princekumar983777/TYNOR/README.md

# TYNOR

these area the project that i have worked on,
these product falls under the Category of walker support
