princekumar983777/TYNOR/Walker Ergo/Z_INFO.txt

TYNOR Orthotics Pvt. Ltd

Leg Braces
Walking Ergo 

WE-P2-LB
