princekumar983777/TYNOR/Commode Chair Ergo/src/WhatsApp Image 2026-06-30 at 12.06.18 PM.jpeg

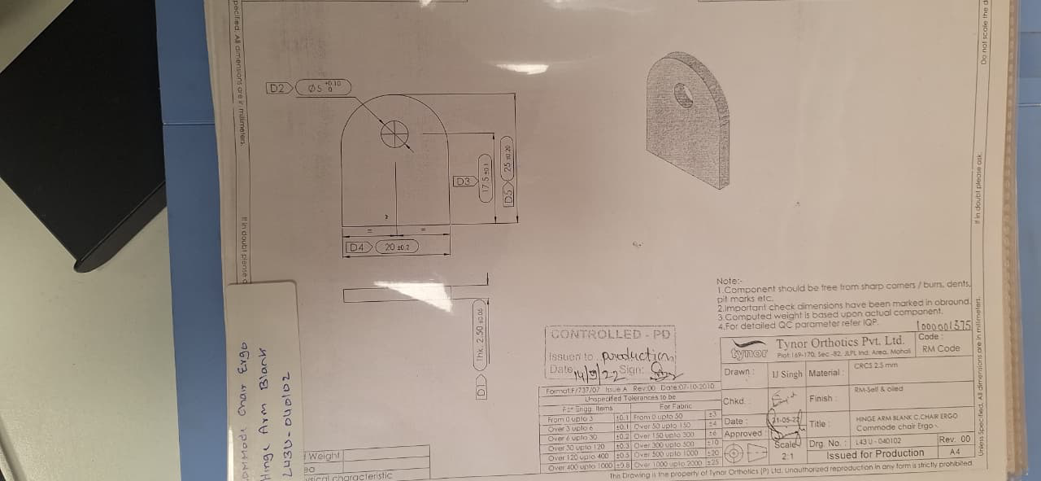
Commode Chair Ergo/src/WhatsApp Image 2026-06-30 at 12.06.18 PM.jpeg
