princekumar983777/TYNOR/Walker Aluminium/src/WhatsApp Image 2026-06-11 at 11.34.19 AM.jpeg

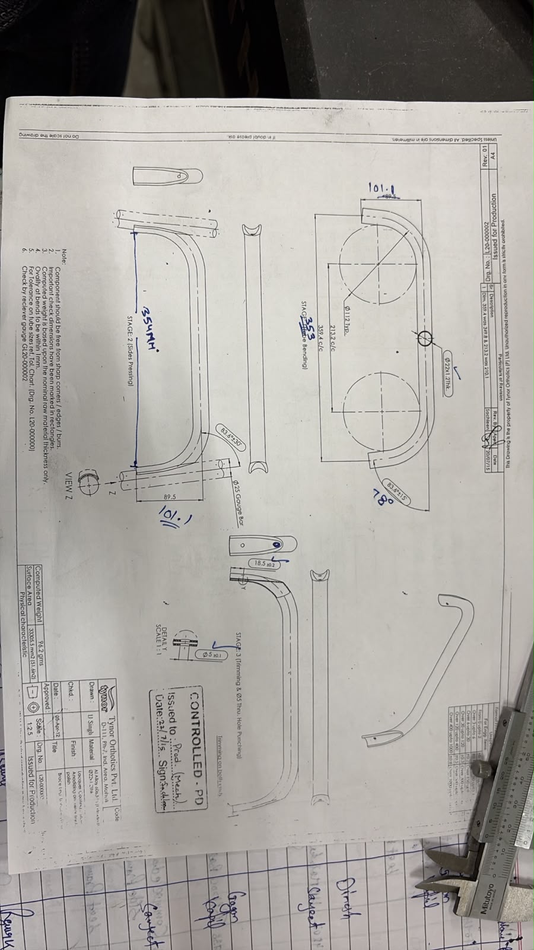
Walker Aluminium/src/WhatsApp Image 2026-06-11 at 11.34.19 AM.jpeg
