princekumar983777/TYNOR/Walker Aluminium/src/WhatsApp Image 2026-06-11 at 12.56.39 PM.jpeg

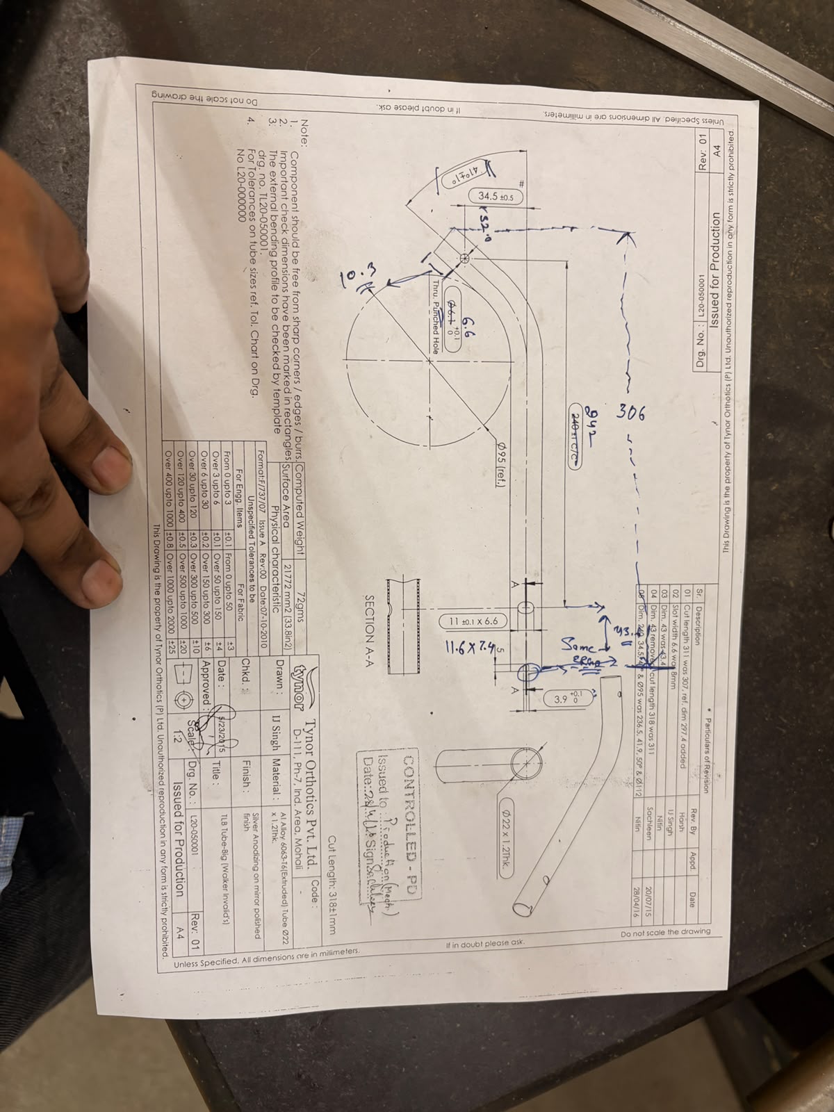
Walker Aluminium/src/WhatsApp Image 2026-06-11 at 12.56.39 PM.jpeg
