princekumar983777/TYNOR/Walker Aluminium/src/WhatsApp Image 2026-06-16 at 1.27.41 PM.jpeg

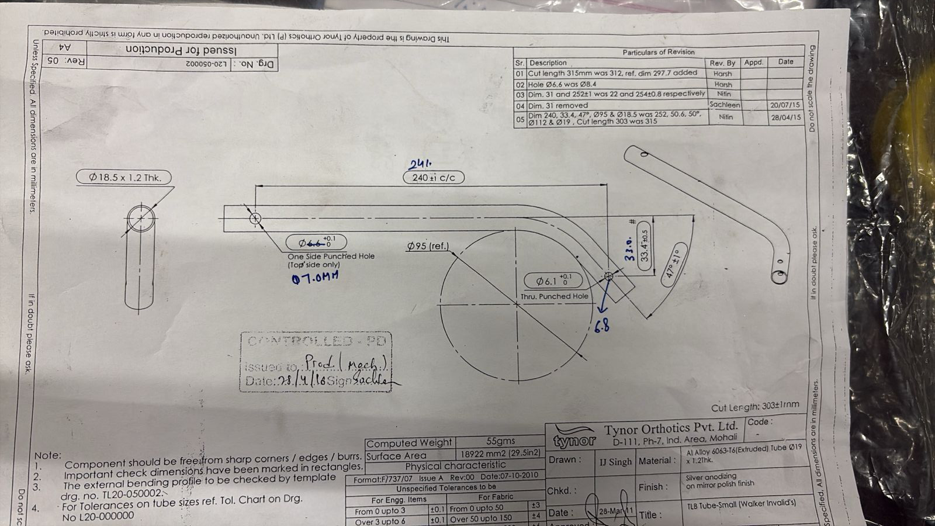
Walker Aluminium/src/WhatsApp Image 2026-06-16 at 1.27.41 PM.jpeg
