princekumar983777/TYNOR/Walker Aluminium/src/WhatsApp Image 2026-06-16 at 2.34.24 PM.jpeg

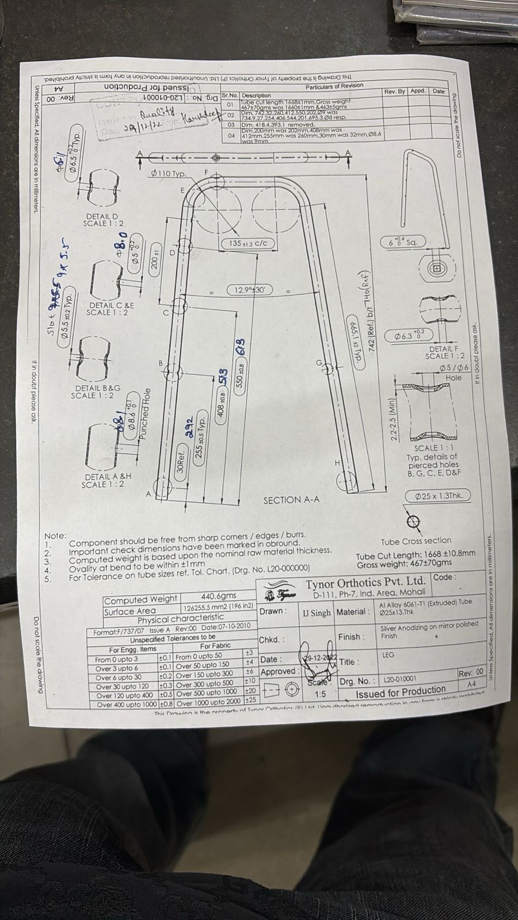
Walker Aluminium/src/WhatsApp Image 2026-06-16 at 2.34.24 PM.jpeg
