princekumar983777/TYNOR/Walker Aluminium/src/WhatsApp Image 2026-06-17 at 1.30.02 PM (2).jpeg

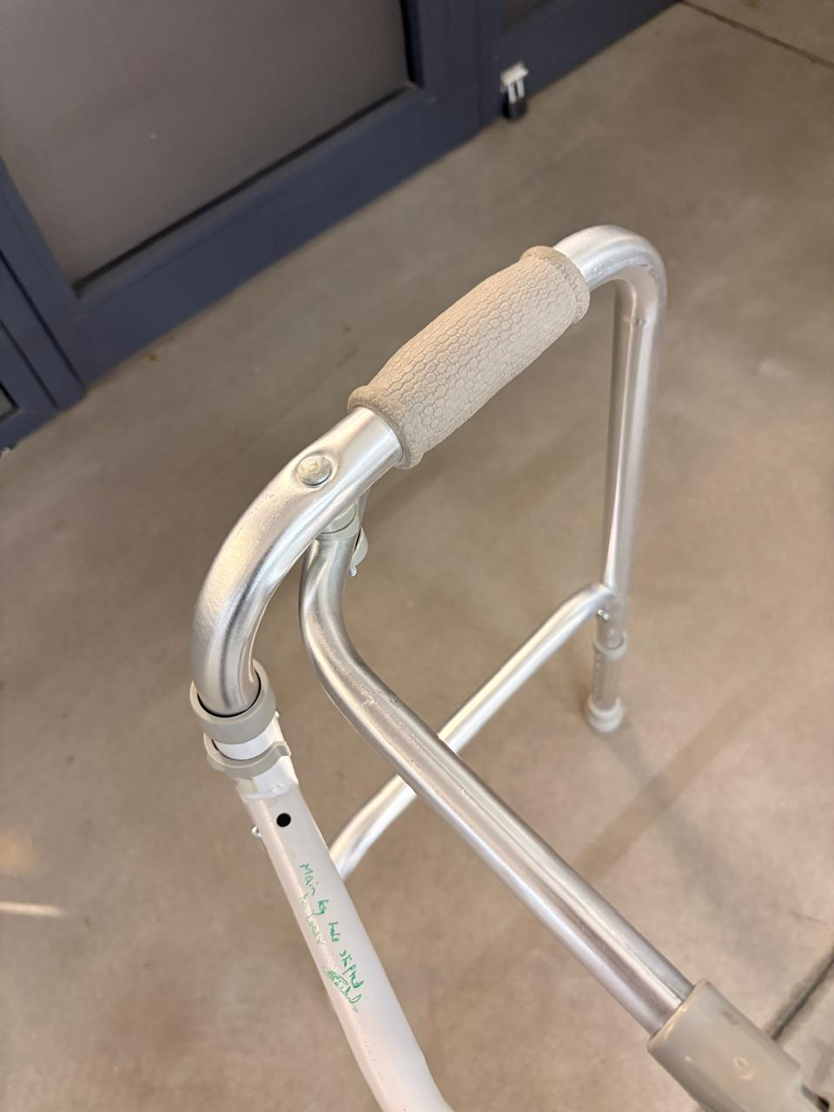
Walker Aluminium/src/WhatsApp Image 2026-06-17 at 1.30.02 PM (2).jpeg
