princekumar983777/TYNOR/Walker Aluminium/src/WhatsApp Image 2026-06-19 at 2.53.04 PM.jpeg

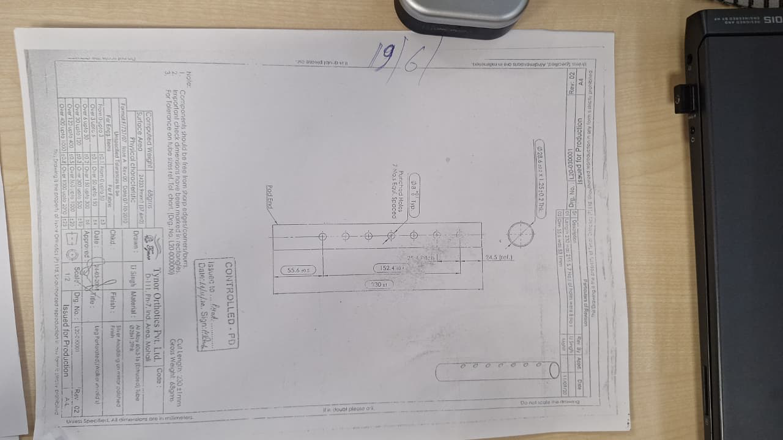
Walker Aluminium/src/WhatsApp Image 2026-06-19 at 2.53.04 PM.jpeg
