princekumar983777/TYNOR/Walker Aluminium/src/WhatsApp Image 2026-06-25 at 8.43.58 AM.jpeg

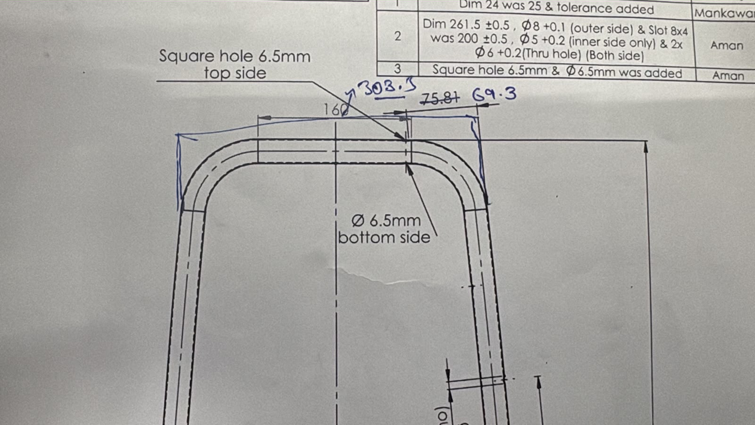
Walker Aluminium/src/WhatsApp Image 2026-06-25 at 8.43.58 AM.jpeg
