princekumar983777/TYNOR/Walker HD/src/WhatsApp Image 2026-06-15 at 3.05.31 PM.jpeg

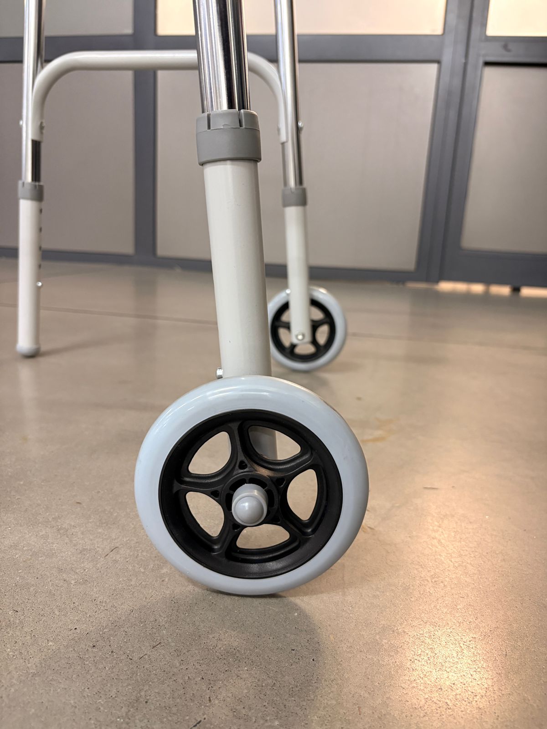
Walker HD/src/WhatsApp Image 2026-06-15 at 3.05.31 PM.jpeg
