princekumar983777/TYNOR/Walker HD/src/WhatsApp Image 2026-06-22 at 1.30.08 PM (3).jpeg

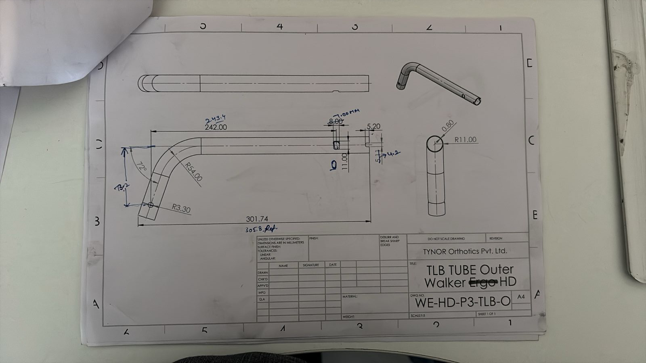
Walker HD/src/WhatsApp Image 2026-06-22 at 1.30.08 PM (3).jpeg
