princekumar983777/TYNOR/Walker Aluminium/Simple Walker/PART_1 MAIN LINE.SLDPRT

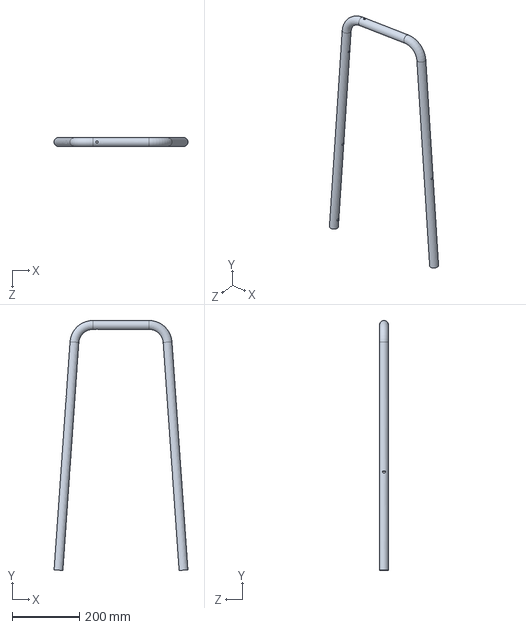
[picture p37: CAD file, 2026-06-26]
Walker Aluminium/Simple Walker/PART_1 MAIN LINE.SLDPRT
398.2 x 743.4 x 26.4 mm
