princekumar983777/TYNOR/Walker Aluminium/Walker Al. with Wheel with Straight Leg/Walker Al. with Wheel/PART_1 MAIN LINE.SLDPRT

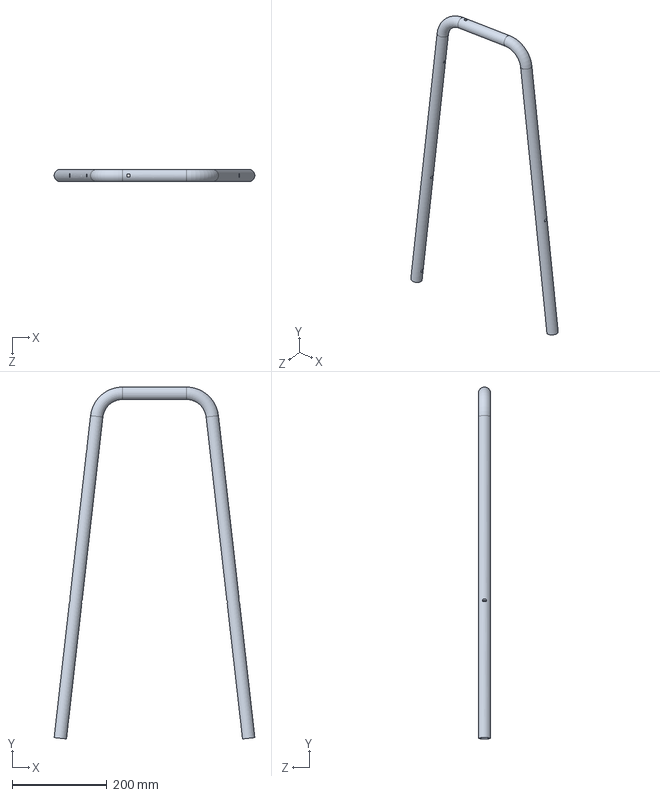
[picture p38: CAD file, 2026-06-25]
Walker Aluminium/Walker Al. with Wheel with Straight Leg/Walker Al. with Wheel/PART_1 MAIN LINE.SLDPRT
424.4 x 744.0 x 26.4 mm
