princekumar983777/TYNOR/Walker Ergo/PART_1 MAIN LINE.SLDPRT

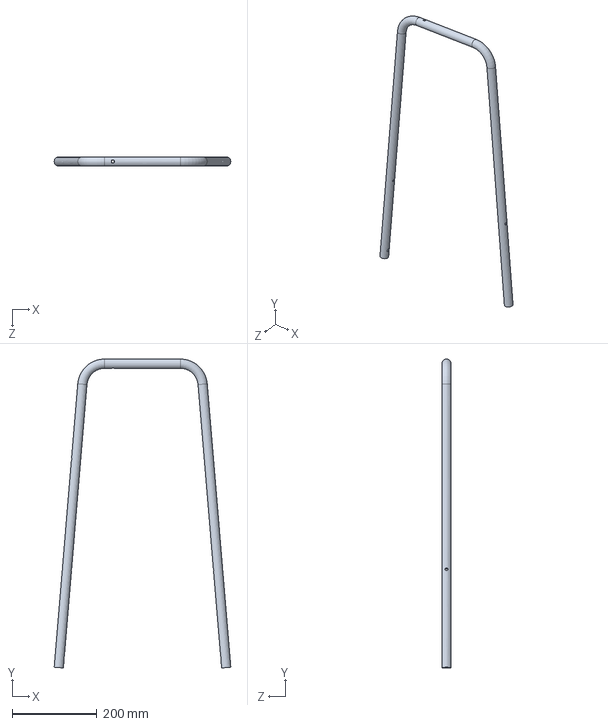
[picture p39: CAD file, 2026-06-25]
Walker Ergo/PART_1 MAIN LINE.SLDPRT
417.9 x 730.9 x 22.0 mm
