princekumar983777/TYNOR/Walker Aluminium/Simple Walker/SIDE STAND.SLDASM

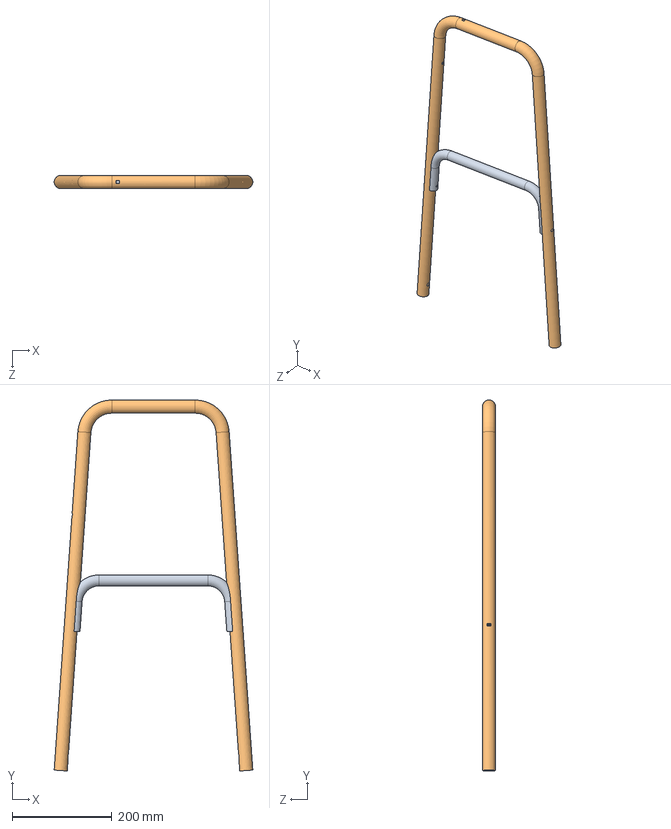
[picture p40: CAD file, 2026-06-26]
Walker Aluminium/Simple Walker/SIDE STAND.SLDASM
398.2 x 743.4 x 26.4 mm
PART_1 MAIN LINE
PART_2 Ergo walker joint Formed
