princekumar983777/TYNOR/Walker Aluminium/Simple Walker/Assembly 1.0.SLDASM

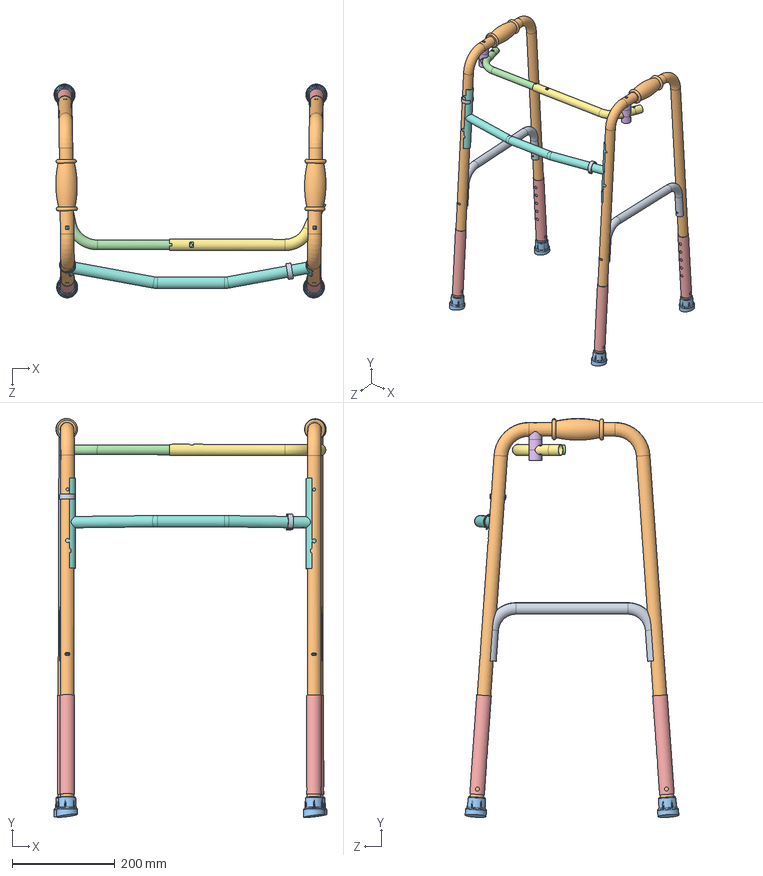
[picture p42: CAD file, 2026-06-26]
Walker Aluminium/Simple Walker/Assembly 1.0.SLDASM
530.8 x 775.9 x 415.9 mm
PART_1 MAIN LINE x 2
PART_2 Ergo walker joint Formed x 2
PART_4 WELDED Coated ERGO WALKER
PART_3 TLB Tube Outer walker Ergo
Pkug x 6
PART_5 Perforated Pipe D25.4 ERGO WALKER x 4
PART_3_1 TLB Tube Inner
P_Stand x 4
P_Handle Part x 2
LOCK_PIN x 2
