princekumar983777/TYNOR/Walker Aluminium/Walker Al. with Wheel/Assembly 1.0.SLDASM

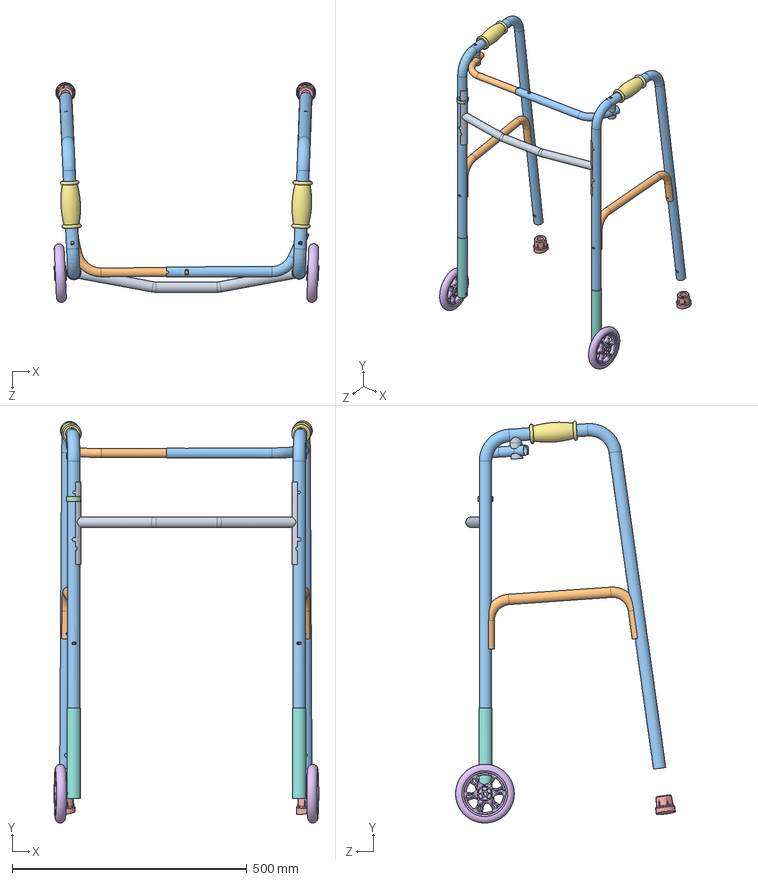
[picture p43: CAD file, 2026-06-26]
Walker Aluminium/Walker Al. with Wheel/Assembly 1.0.SLDASM
563.7 x 855.5 x 468.1 mm
PART_1 MAIN LINE x 2
PART_2 Ergo walker joint Formed x 2
PART_4 WELDED Coated ERGO WALKER
PART_5 Perforated Pipe D25.4 ERGO WALKER x 2
P_Handle Part x 2
wheel x 2
P_Stand x 2
LOCK_PIN
PART_3 TLB Tube Outer walker Ergo
PART_3_1 TLB Tube Inner
Plug_ x 6
