princekumar983777/TYNOR/Walker HD/Walker HD Fr. Wheel/Assembly 1.0.SLDASM

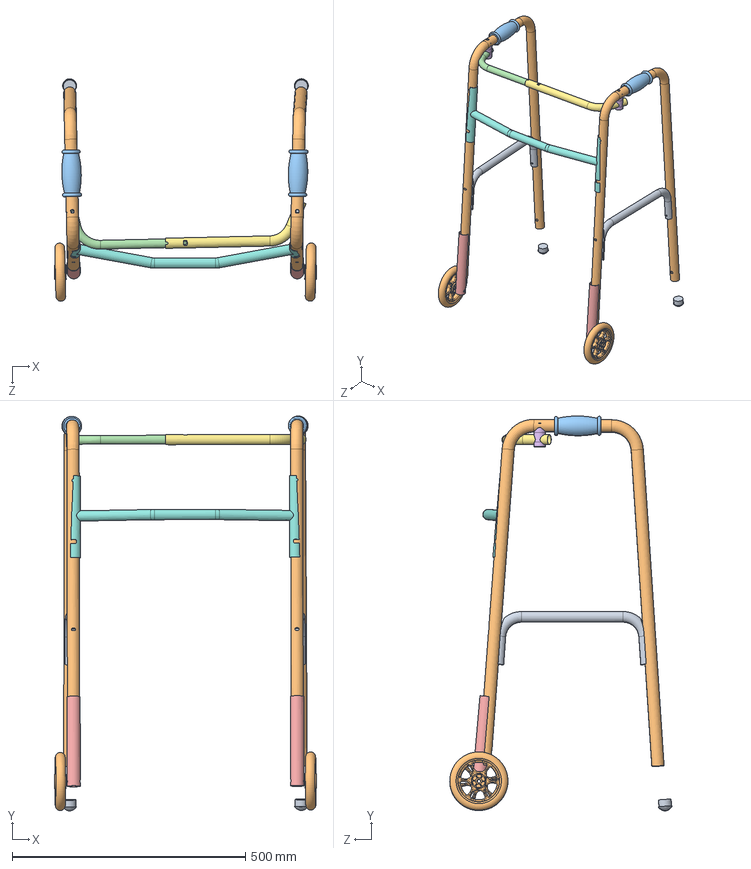
[picture p44: CAD file, 2026-06-25]
Walker HD/Walker HD Fr. Wheel/Assembly 1.0.SLDASM
563.1 x 847.6 x 477.5 mm
PART_1 MAIN LINE x 2
PART_2 Ergo walker joint Formed x 2
PART_4 WELDED Coated ERGO WALKER
PART_3 TLB Tube Outer walker Ergo
Pkug x 6
PART_5 Perforated Pipe D25.4 ERGO WALKER x 2
PART_3_1 TLB Tube Inner
P_Handle Part x 2
wheel x 2
plug_wheel x 2
