princekumar983777/TYNOR/Walker Aluminium/Walker Al. with Wheel with Straight Leg/STP/Main_Leg_Straight.STEP

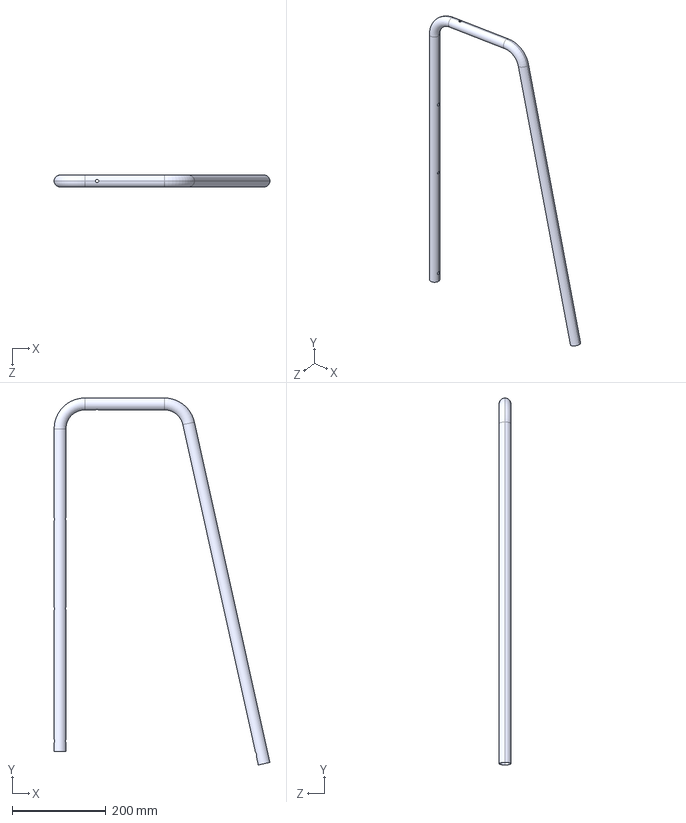
[picture p47: CAD file, 2026-06-26]
Walker Aluminium/Walker Al. with Wheel with Straight Leg/STP/Main_Leg_Straight.STEP
461.0 x 784.0 x 25.4 mm
