princekumar983777/TYNOR/Commode Chair Ergo/Commode Chair Ergo/Arm rest pipe hinge assembly Commode Chair Ergo.SLDPRT

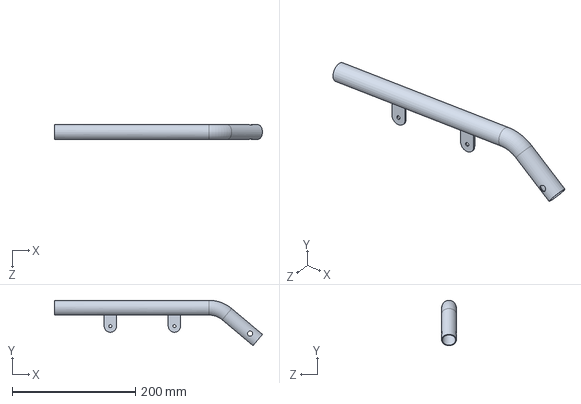
[picture p48: CAD file, 2026-06-30]
Commode Chair Ergo/Commode Chair Ergo/Arm rest pipe hinge assembly Commode Chair Ergo.SLDPRT
337.7 x 73.7 x 24.0 mm
