princekumar983777/TYNOR/Walker Ergo/Assembly 1.0.SLDASM

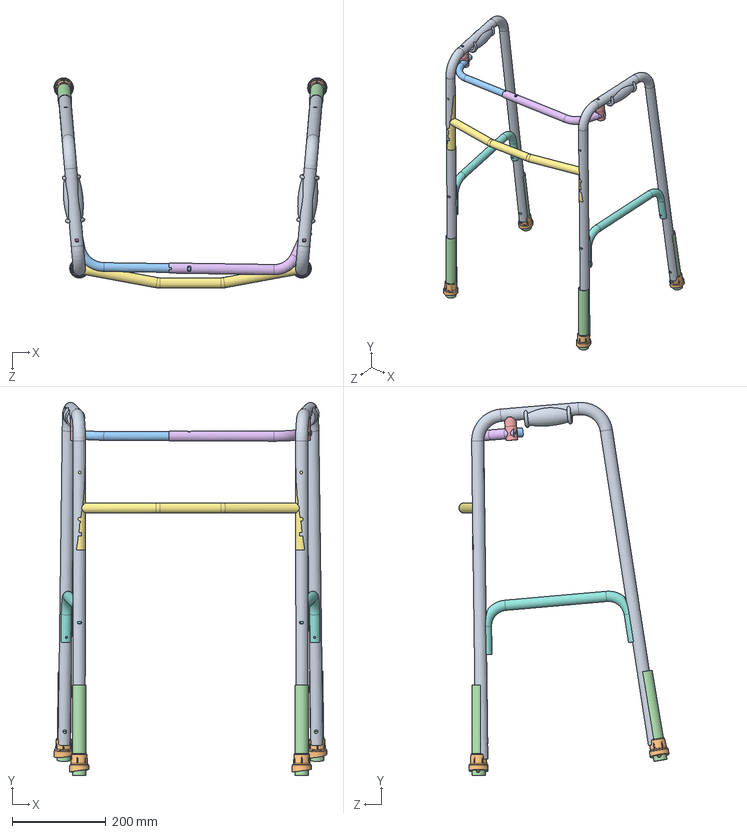
[picture p49: CAD file, 2026-06-17]
Walker Ergo/Assembly 1.0.SLDASM
583.3 x 797.6 x 449.7 mm
PART_1 MAIN LINE x 2
PART_2 Ergo walker joint Formed x 2
PART_4 WELDED Coated ERGO WALKER
PART_3 TLB Tube Outer walker Ergo
Pkug x 6
PART_5 Perforated Pipe D25.4 ERGO WALKER x 4
PART_3_1 TLB Tube Inner
P_Stand x 4
P_Handle Part x 2
