princekumar983777/TYNOR/Walker Aluminium/Walker Al. with Wheel with Straight Leg/Walker Al. with Wheel/Ground Stand.SLDASM

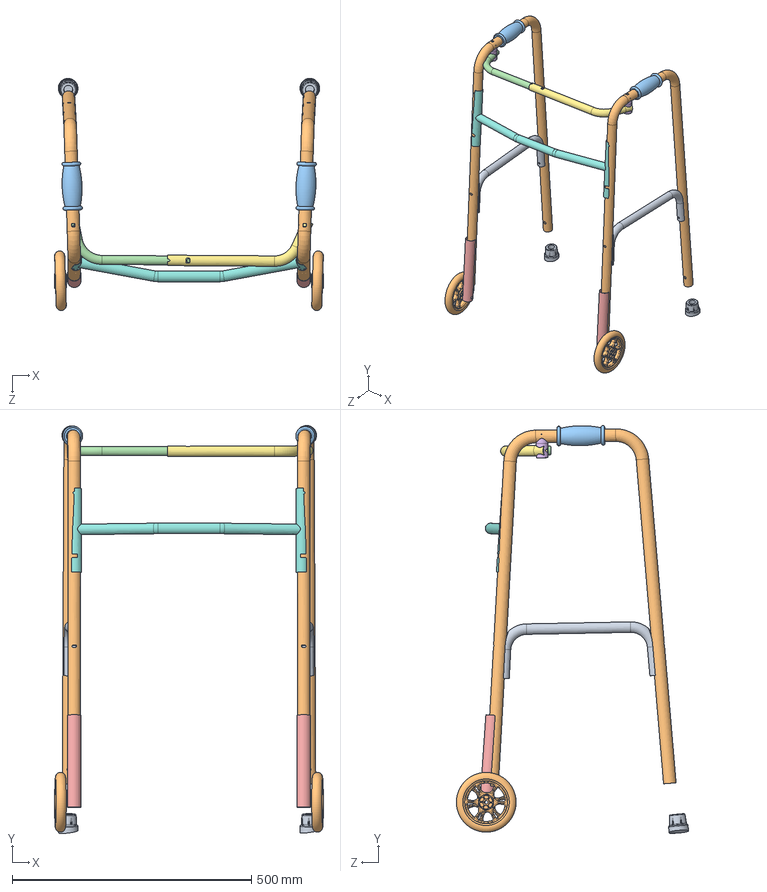
[picture p51: CAD file, 2026-06-17]
Walker Aluminium/Walker Al. with Wheel with Straight Leg/Walker Al. with Wheel/Ground Stand.SLDASM
563.4 x 852.9 x 485.5 mm
PART_1 MAIN LINE x 2
PART_2 Ergo walker joint Formed x 2
PART_4 WELDED Coated ERGO WALKER
PART_3 TLB Tube Outer walker Ergo
Pkug x 6
PART_5 Perforated Pipe D25.4 ERGO WALKER x 2
PART_3_1 TLB Tube Inner
P_Handle Part x 2
wheel x 2
P_Stand x 2
