princekumar983777/TYNOR/Commode Chair Ergo/Commode Chair Ergo/P_Stand.SLDPRT

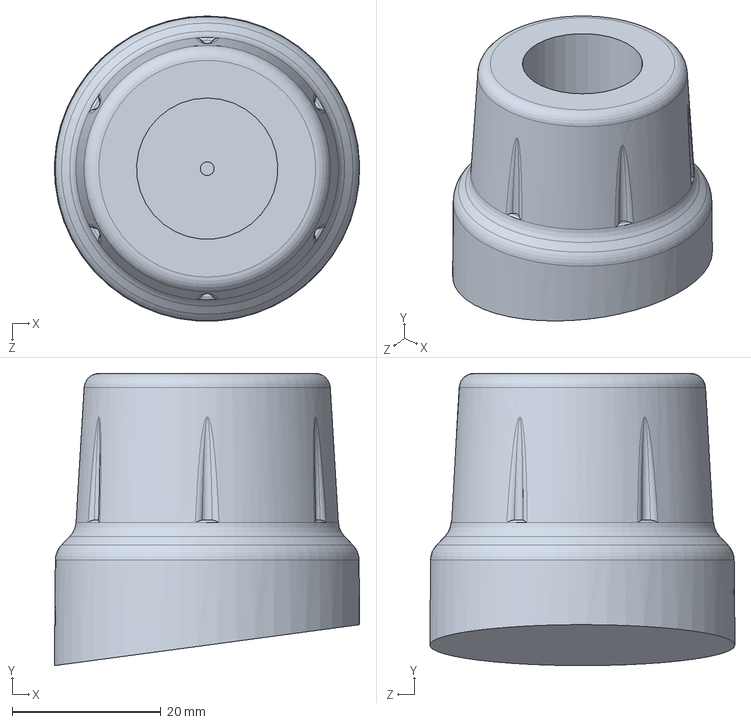
[picture p52: CAD file, 2026-07-01]
Commode Chair Ergo/Commode Chair Ergo/P_Stand.SLDPRT
41.0 x 39.3 x 41.0 mm
