princekumar983777/TYNOR/randoms/Pipe.SLDPRT

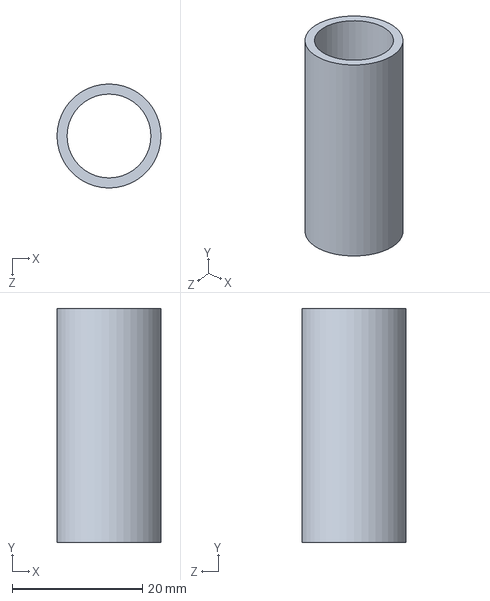
[picture p53: CAD file, 2026-06-29]
randoms/Pipe.SLDPRT
16.0 x 36.0 x 16.0 mm
