princekumar983777/TYNOR/Walker Aluminium/test Part.SLDPRT

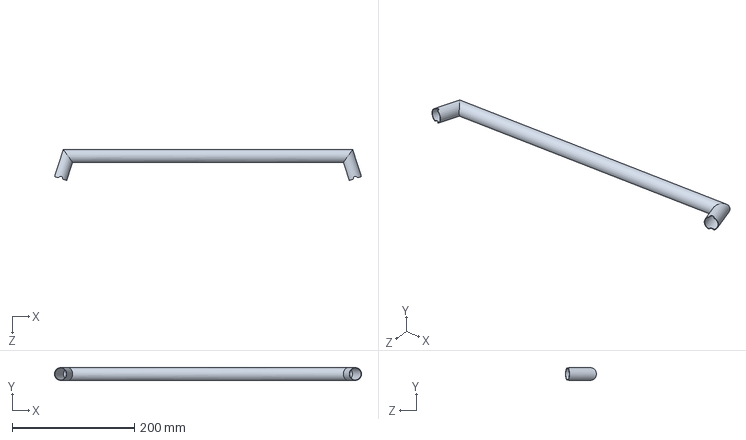
[picture p54: CAD file, 2026-06-25]
Walker Aluminium/test Part.SLDPRT
501.6 x 21.0 x 50.6 mm
