princekumar983777/TYNOR/Walker Aluminium/Walker Al. with Wheel with Straight Leg/STP/PART_2 Ergo walker joint Formed.STEP

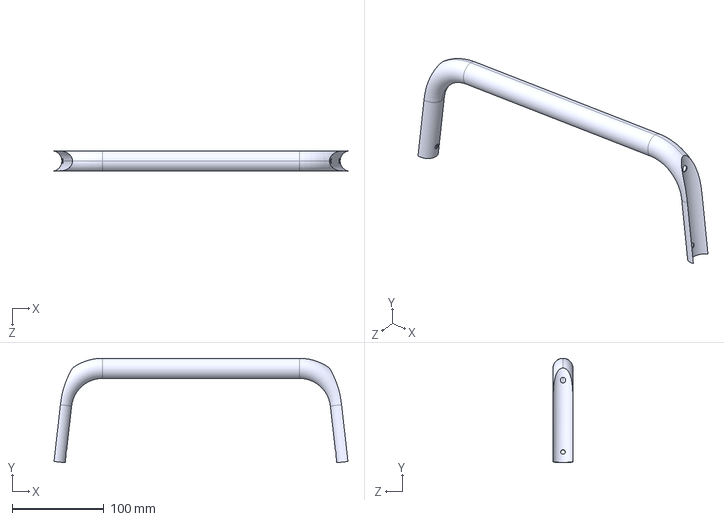
[picture p55: CAD file, 2026-06-26]
Walker Aluminium/Walker Al. with Wheel with Straight Leg/STP/PART_2 Ergo walker joint Formed.STEP
321.1 x 114.1 x 22.0 mm
