princekumar983777/TYNOR/Walker Aluminium/Walker Al. with Wheel with Straight Leg/Walker Al. with Wheel/Wheel/wheel.SLDPRT

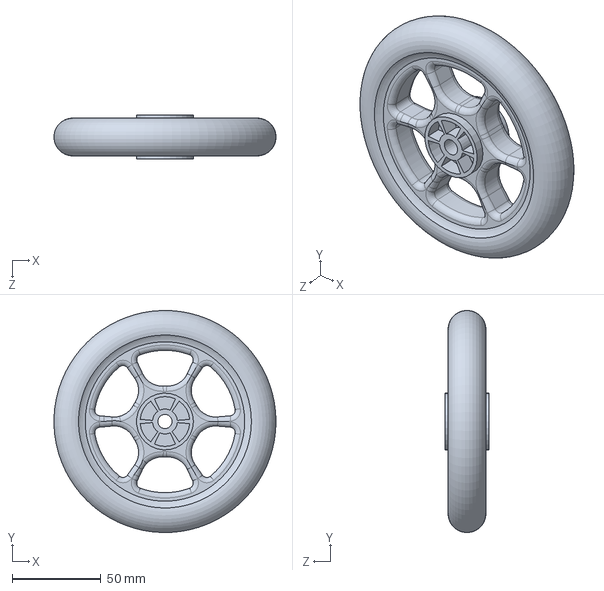
[picture p56: CAD file, 2026-06-17]
Walker Aluminium/Walker Al. with Wheel with Straight Leg/Walker Al. with Wheel/Wheel/wheel.SLDPRT
124.8 x 124.9 x 25.0 mm
