princekumar983777/TYNOR/Walker Aluminium/Walker Al. with Wheel/PART_3 TLB Tube Outer walker Ergo.SLDPRT

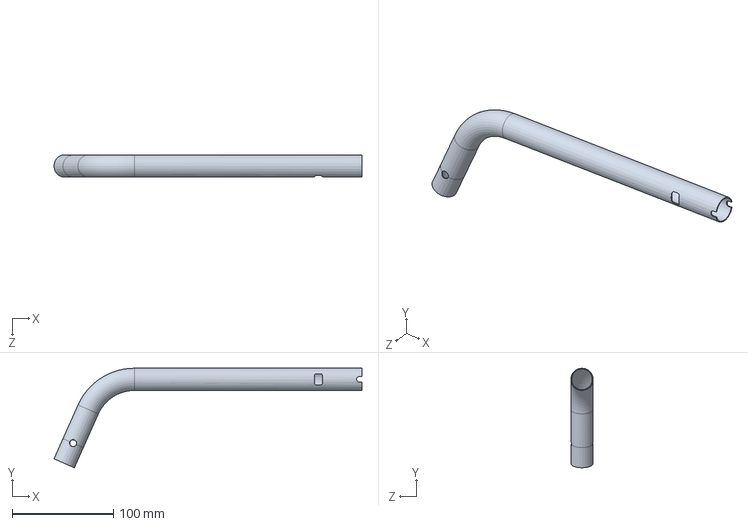
[picture p57: CAD file, 2026-06-26]
Walker Aluminium/Walker Al. with Wheel/PART_3 TLB Tube Outer walker Ergo.SLDPRT
303.9 x 98.3 x 22.0 mm
