princekumar983777/TYNOR/Walker Aluminium/Walker Al. with Wheel/RAW/Unbent TLB outer.SLDPRT

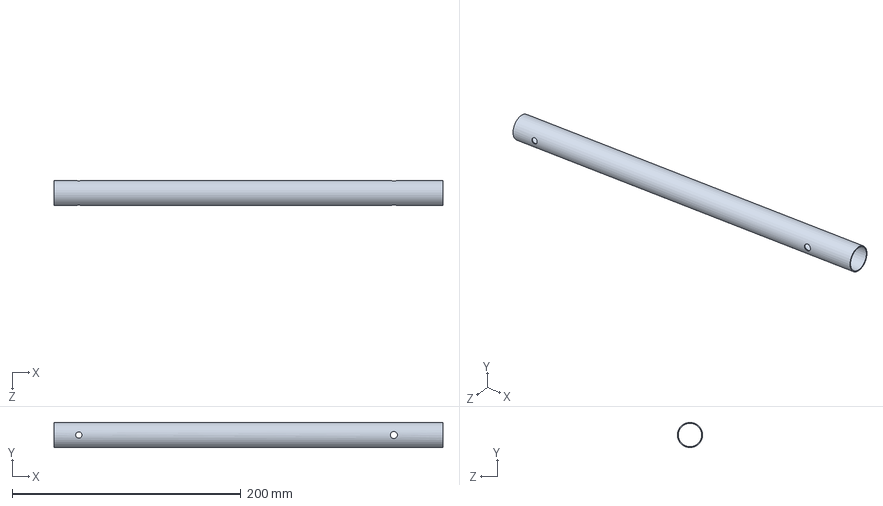
[picture p58: CAD file, 2026-06-26]
Walker Aluminium/Walker Al. with Wheel/RAW/Unbent TLB outer.SLDPRT
340.3 x 22.0 x 22.0 mm
