princekumar983777/TYNOR/Walker HD/Walker HD Fr. Wheel/Wheel/plug_wheel.SLDPRT

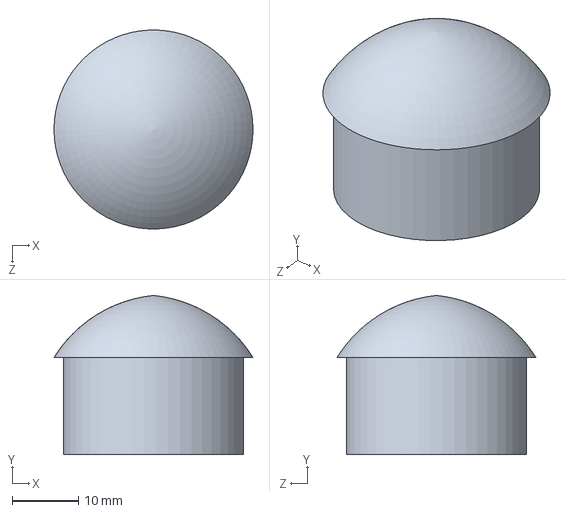
[picture p60: CAD file, 2026-06-25]
Walker HD/Walker HD Fr. Wheel/Wheel/plug_wheel.SLDPRT
30.0 x 24.0 x 30.0 mm
