princekumar983777/TYNOR/Walker HD/Walker HD/PART_3_1 TLB Tube Inner.SLDPRT

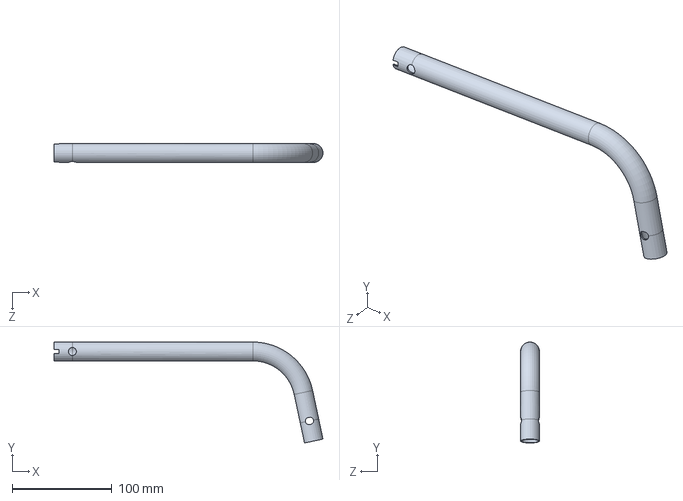
[picture p61: CAD file, 2026-06-25]
Walker HD/Walker HD/PART_3_1 TLB Tube Inner.SLDPRT
270.3 x 101.5 x 19.0 mm
