princekumar983777/TYNOR/Commode Chair Ergo/Commode Chair Ergo/PJug_front.SLDPRT

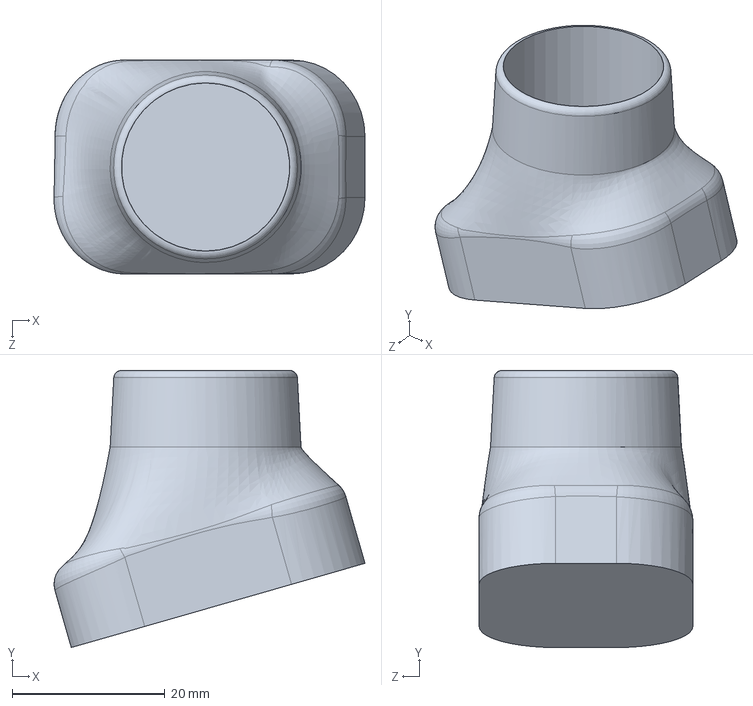
[picture p62: CAD file, 2026-07-01]
Commode Chair Ergo/Commode Chair Ergo/PJug_front.SLDPRT
40.7 x 36.3 x 28.0 mm
