princekumar983777/TYNOR/randoms/Pipe_Holder.SLDPRT

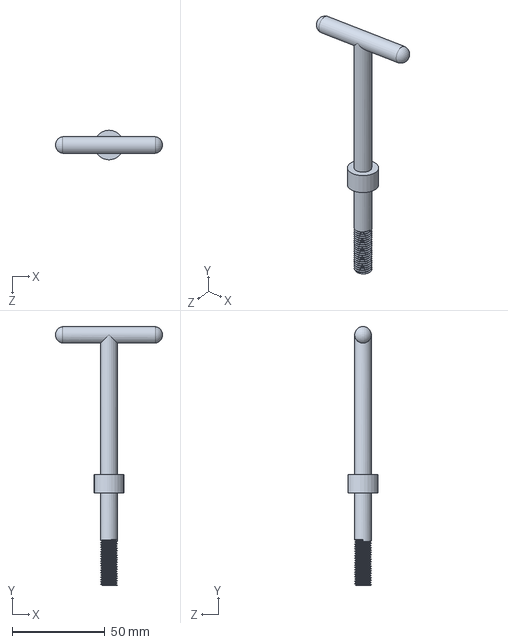
[picture p63: CAD file, 2026-06-29]
randoms/Pipe_Holder.SLDPRT
57.9 x 140.0 x 16.0 mm
