princekumar983777/TYNOR/Walker Aluminium/Walker Al. with Wheel with Straight Leg/STP/P_Stand.STEP

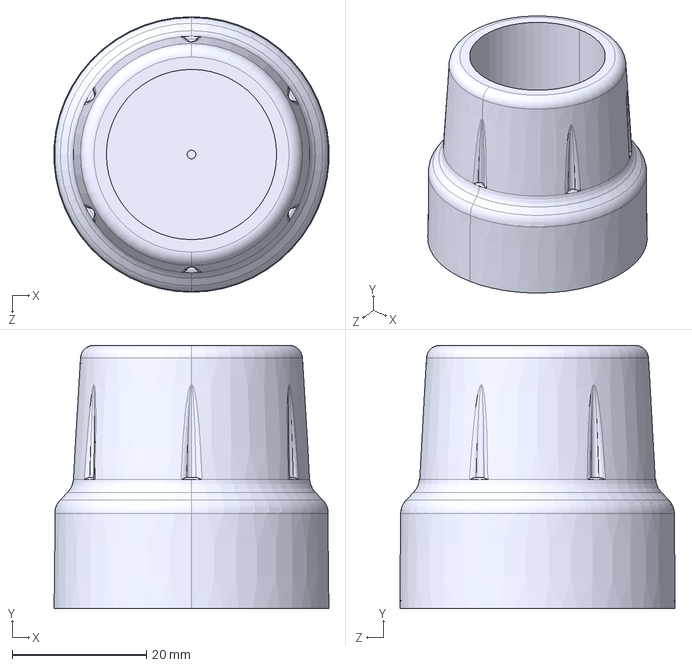
[picture p64: CAD file, 2026-06-26]
Walker Aluminium/Walker Al. with Wheel with Straight Leg/STP/P_Stand.STEP
41.0 x 39.3 x 41.1 mm
