princekumar983777/TYNOR/Walker Aluminium/Walker Al. with Wheel with Straight Leg/Walker Al. with Wheel/Plug_.SLDPRT

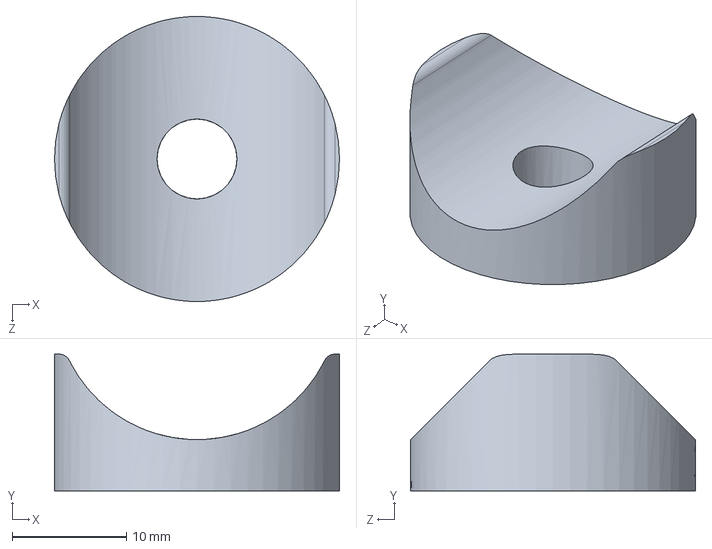
[picture p65: CAD file, 2026-06-25]
Walker Aluminium/Walker Al. with Wheel with Straight Leg/Walker Al. with Wheel/Plug_.SLDPRT
25.0 x 12.0 x 25.0 mm
