princekumar983777/TYNOR/Walker Aluminium/Walker Al. with Wheel/RAW/Unbent TLB Inner.SLDPRT

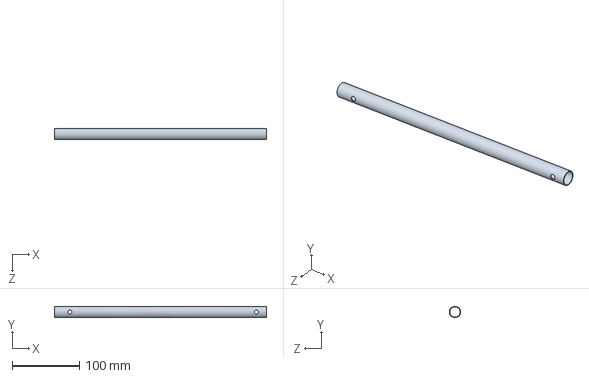
[picture p66: CAD file, 2026-06-26]
Walker Aluminium/Walker Al. with Wheel/RAW/Unbent TLB Inner.SLDPRT
315.0 x 16.9 x 17.0 mm
