princekumar983777/TYNOR/Walker Aluminium/Walker Al. with Wheel/TLB_OUTER_Using_Bending.SLDPRT

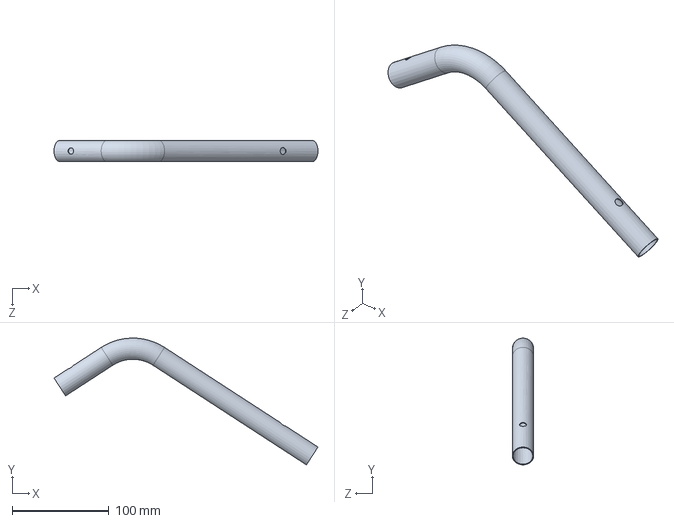
[picture p67: CAD file, 2026-06-26]
Walker Aluminium/Walker Al. with Wheel/TLB_OUTER_Using_Bending.SLDPRT
273.0 x 131.1 x 22.0 mm
