princekumar983777/TYNOR/Walker Ergo/PART_4 WELDED Coated ERGO WALKER.SLDPRT

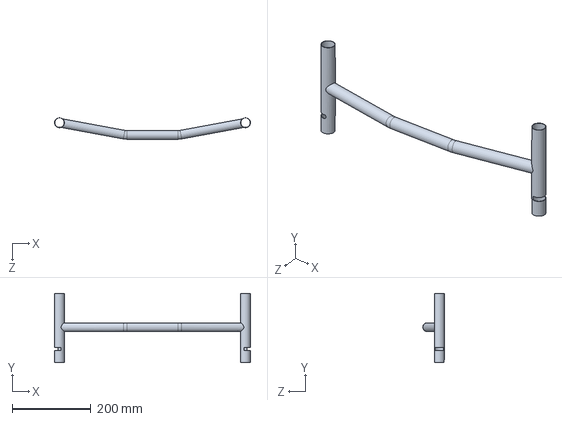
[picture p68: CAD file, 2026-06-25]
Walker Ergo/PART_4 WELDED Coated ERGO WALKER.SLDPRT
499.2 x 176.0 x 54.9 mm
