princekumar983777/TYNOR/Commode Chair Ergo/Commode Chair Ergo/PJug_back.SLDPRT

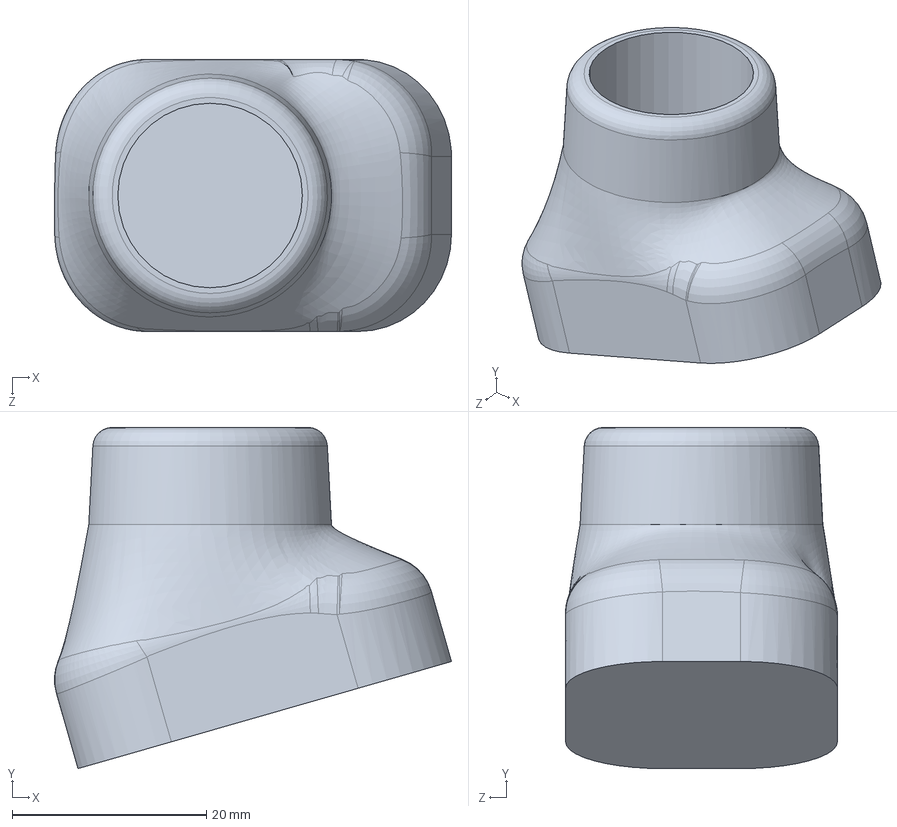
[picture p69: CAD file, 2026-07-01]
Commode Chair Ergo/Commode Chair Ergo/PJug_back.SLDPRT
40.9 x 35.1 x 28.0 mm
