princekumar983777/TYNOR/Walker Aluminium/Walker Al. with Wheel with Straight Leg/Walker Al. with Wheel/LOCK_PIN.SLDPRT

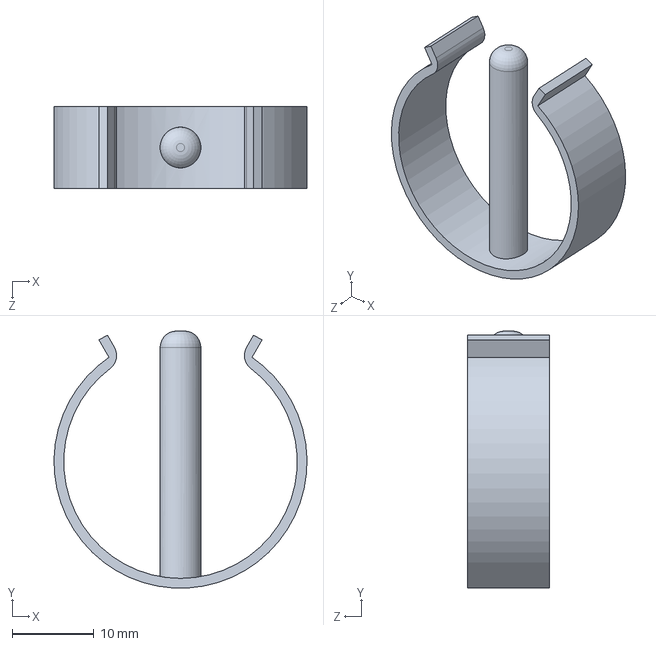
[picture p70: CAD file, 2026-06-25]
Walker Aluminium/Walker Al. with Wheel with Straight Leg/Walker Al. with Wheel/LOCK_PIN.SLDPRT
31.0 x 31.5 x 10.0 mm
