princekumar983777/TYNOR/Walker Ergo/P_Handle Part.SLDPRT

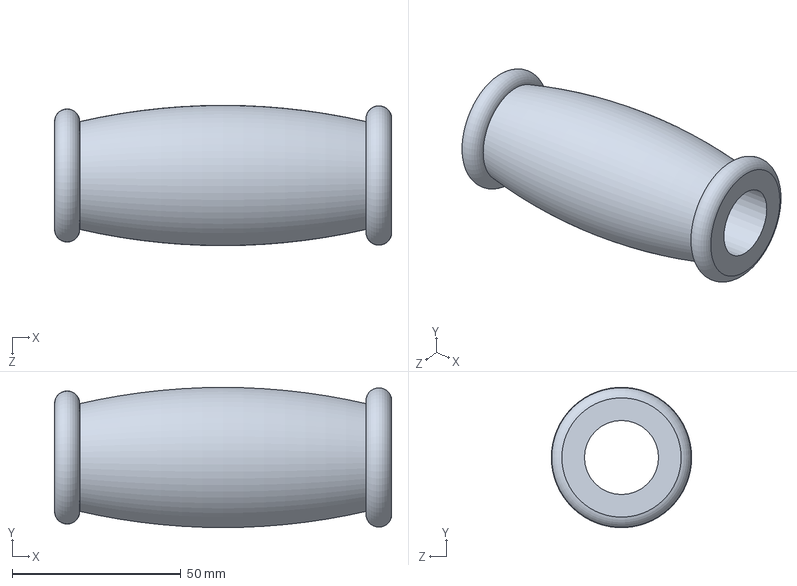
[picture p71: CAD file, 2026-06-25]
Walker Ergo/P_Handle Part.SLDPRT
100.0 x 41.6 x 41.7 mm
