princekumar983777/TYNOR/Walker HD/Walker HD/Pkug.SLDPRT

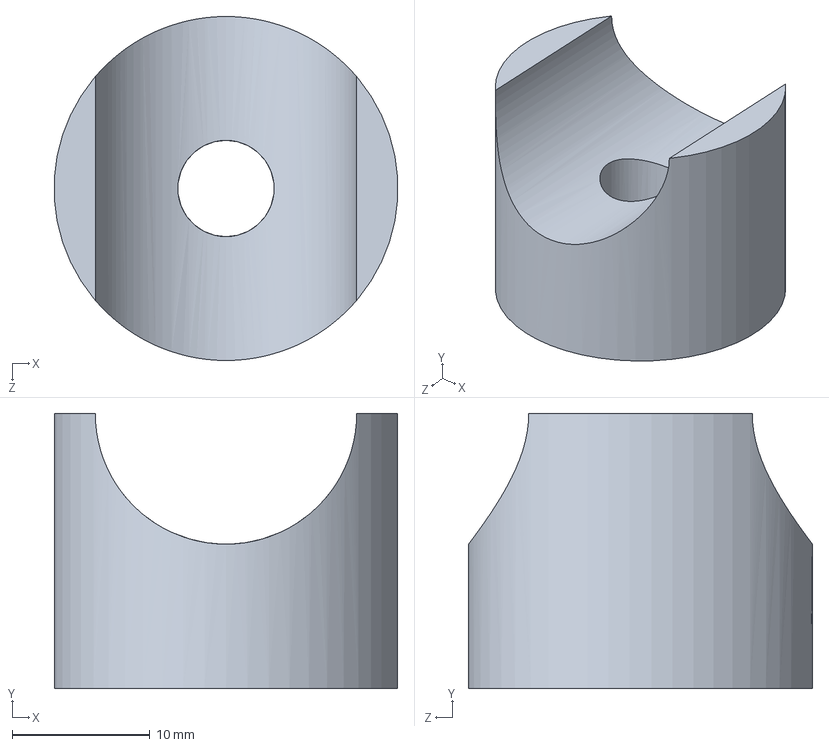
[picture p72: CAD file, 2026-06-25]
Walker HD/Walker HD/Pkug.SLDPRT
25.0 x 20.0 x 25.0 mm
