princekumar983777/TYNOR/Walker Aluminium/Simple Walker/PART_2 Ergo walker joint Formed.SLDPRT

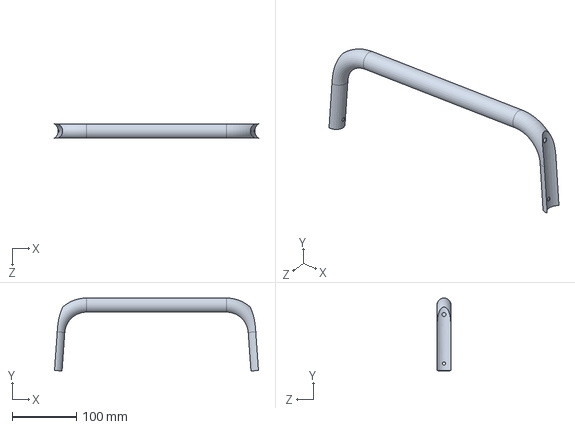
[picture p73: CAD file, 2026-06-26]
Walker Aluminium/Simple Walker/PART_2 Ergo walker joint Formed.SLDPRT
317.7 x 113.7 x 22.0 mm
