princekumar983777/TYNOR/Walker Aluminium/Walker Al. with Wheel with Straight Leg/STP/LOCK_PIN.STEP

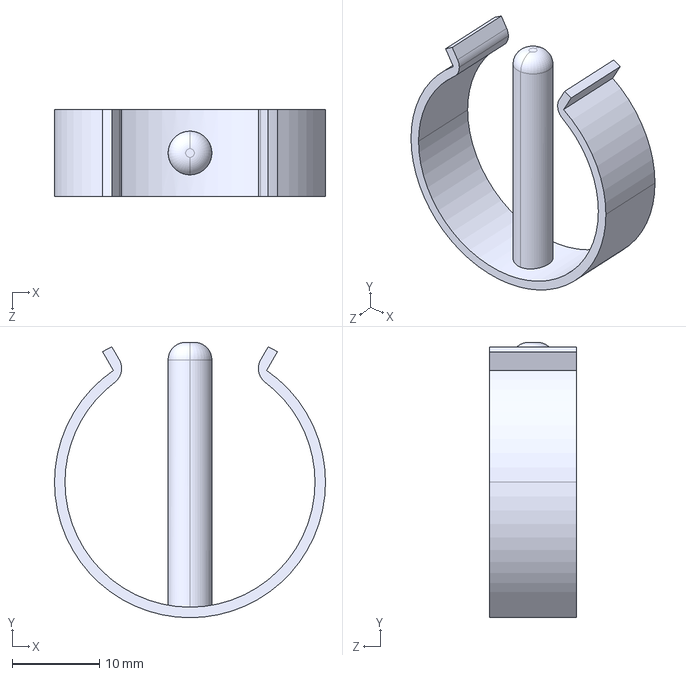
[picture p74: CAD file, 2026-06-26]
Walker Aluminium/Walker Al. with Wheel with Straight Leg/STP/LOCK_PIN.STEP
31.0 x 31.5 x 10.0 mm
