princekumar983777/TYNOR/Walker Ergo/PART_3_1 TLB Tube Inner.SLDPRT

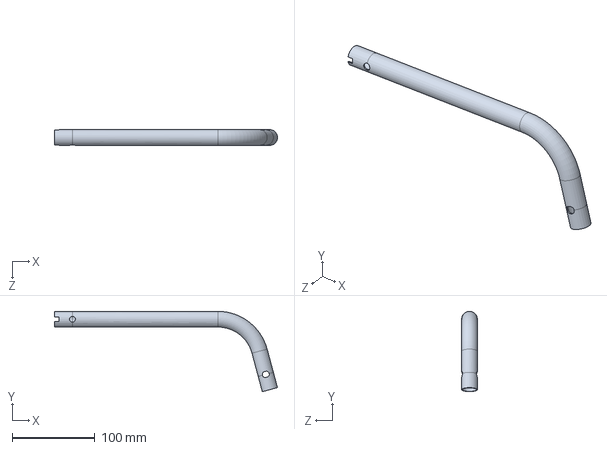
[picture p75: CAD file, 2026-06-25]
Walker Ergo/PART_3_1 TLB Tube Inner.SLDPRT
269.1 x 97.0 x 19.0 mm
