princekumar983777/TYNOR/Commode Chair Ergo/Commode Chair Ergo/Back Support Tube Commode Chair Ergo.SLDPRT

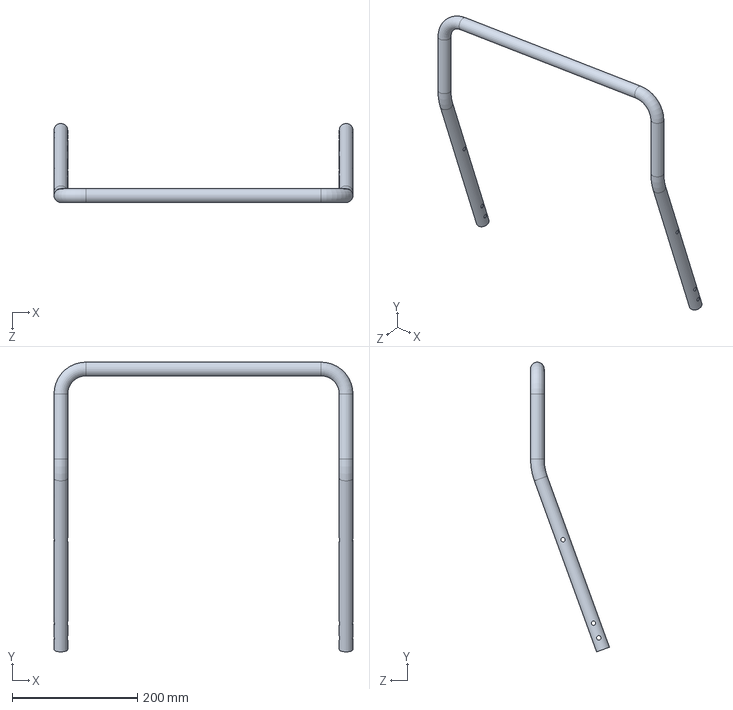
[picture p76: CAD file, 2026-07-01]
Commode Chair Ergo/Commode Chair Ergo/Back Support Tube Commode Chair Ergo.SLDPRT
478.0 x 463.3 x 126.3 mm
