princekumar983777/TYNOR/Walker Aluminium/Walker Al. with Wheel/PART_3_1 TLB Tube Inner.SLDPRT

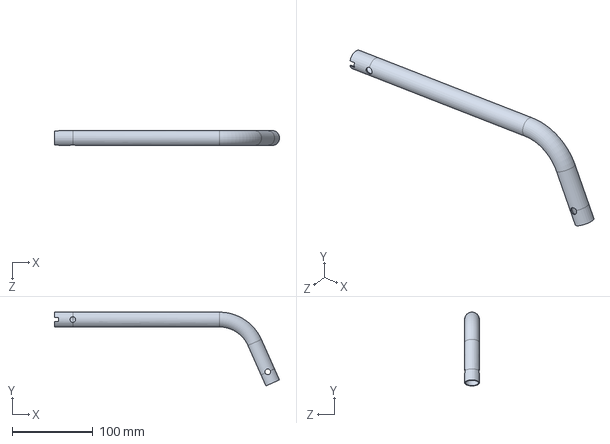
[picture p78: CAD file, 2026-06-26]
Walker Aluminium/Walker Al. with Wheel/PART_3_1 TLB Tube Inner.SLDPRT
279.3 x 91.7 x 18.5 mm
