princekumar983777/TYNOR/Walker HD/Walker HD Fr. Wheel/PART_4 WELDED Coated ERGO WALKER.SLDPRT

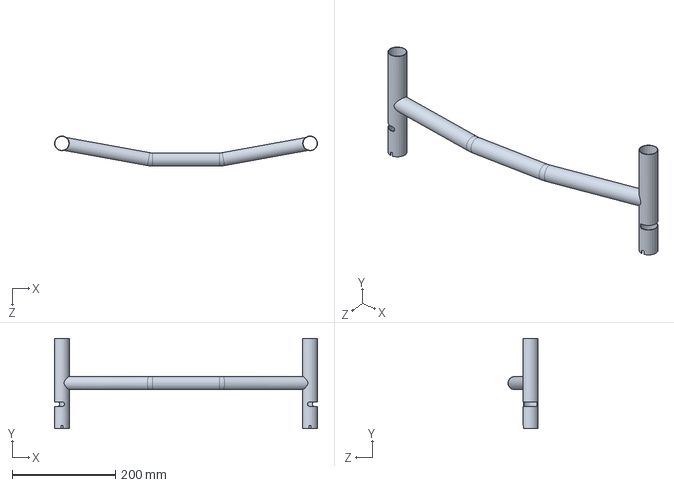
[picture p79: CAD file, 2026-06-17]
Walker HD/Walker HD Fr. Wheel/PART_4 WELDED Coated ERGO WALKER.SLDPRT
508.4 x 174.5 x 58.1 mm
