princekumar983777/TYNOR/Walker HD/Walker HD/PART_3 TLB Tube Outer walker Ergo.SLDPRT

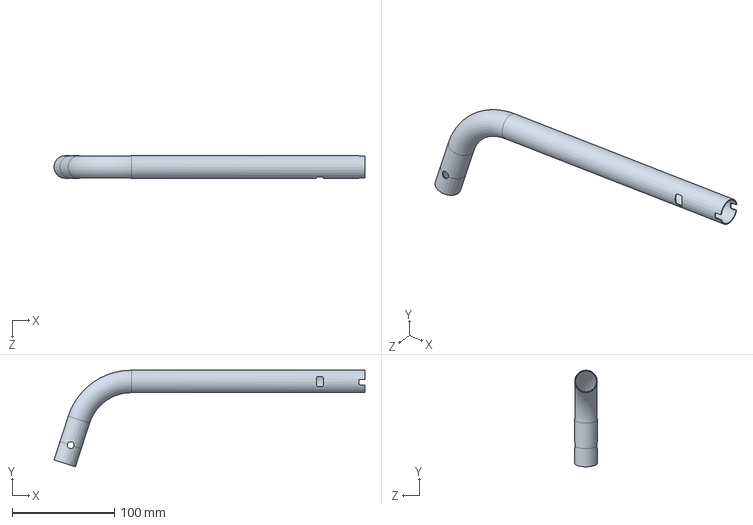
[picture p80: CAD file, 2026-06-25]
Walker HD/Walker HD/PART_3 TLB Tube Outer walker Ergo.SLDPRT
303.6 x 94.4 x 22.0 mm
