princekumar983777/TYNOR/Commode Chair Ergo/Commode Chair Ergo/pla_rivets_3.SLDPRT

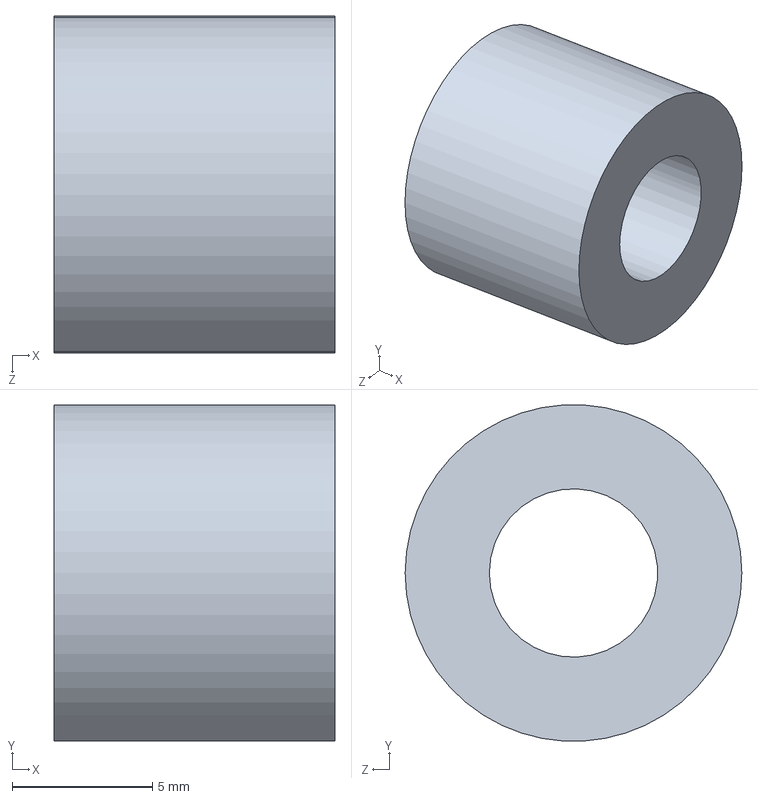
[picture p81: CAD file, 2026-07-01]
Commode Chair Ergo/Commode Chair Ergo/pla_rivets_3.SLDPRT
10.0 x 12.0 x 12.0 mm
