princekumar983777/TYNOR/Walker Ergo/PART_2 Ergo walker joint Formed.SLDPRT

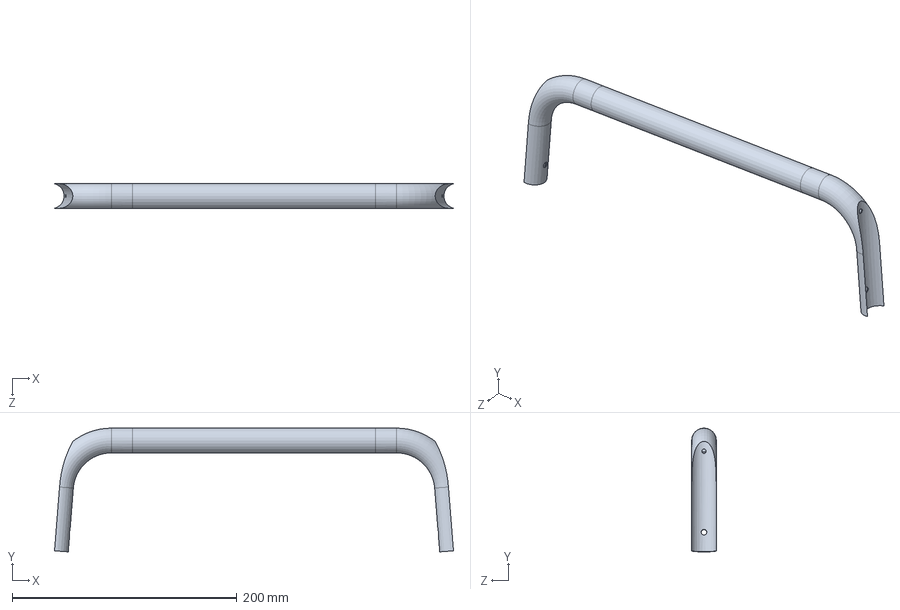
[picture p82: CAD file, 2026-06-25]
Walker Ergo/PART_2 Ergo walker joint Formed.SLDPRT
354.7 x 110.1 x 22.0 mm
