princekumar983777/TYNOR/Commode Chair Ergo/Commode Chair Ergo/Back Leg Frame Commode Chair Ergo.SLDPRT

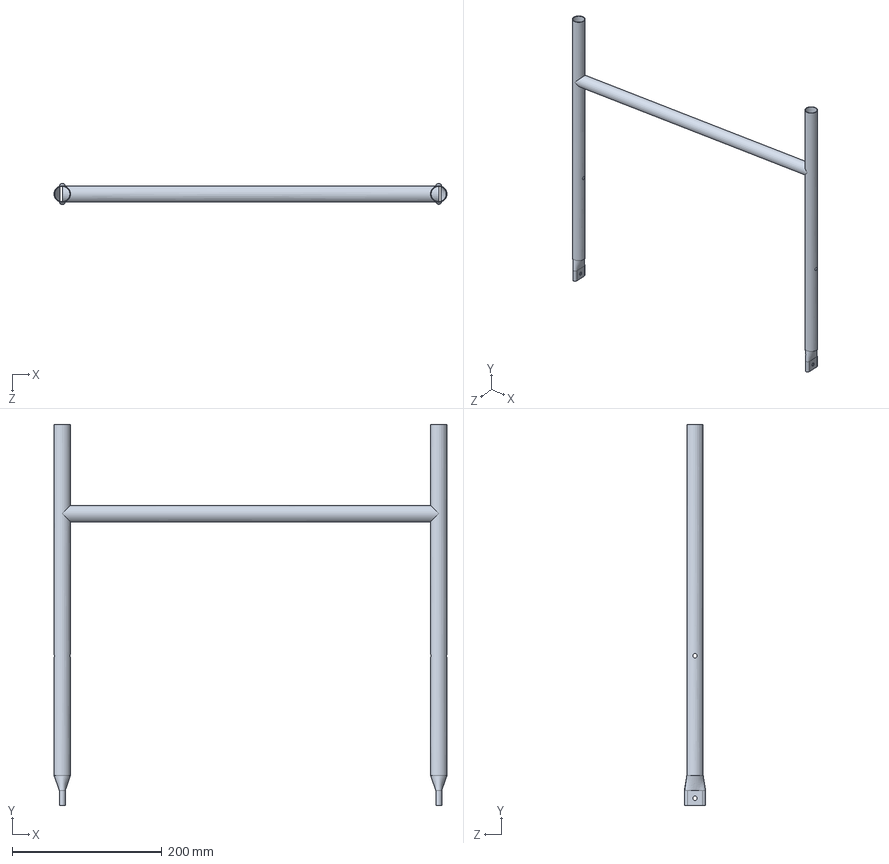
[picture p83: CAD file, 2026-07-01]
Commode Chair Ergo/Commode Chair Ergo/Back Leg Frame Commode Chair Ergo.SLDPRT
525.0 x 509.0 x 28.4 mm
