princekumar983777/TYNOR/Walker Aluminium/Simple Walker/LOCK_PIN.SLDPRT

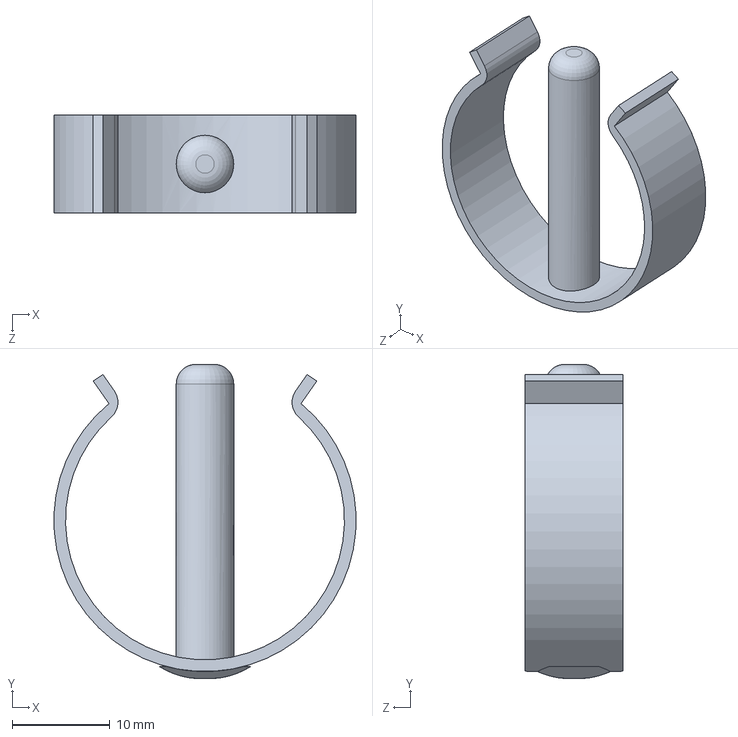
[picture p84: CAD file, 2026-06-25]
Walker Aluminium/Simple Walker/LOCK_PIN.SLDPRT
31.0 x 32.2 x 10.0 mm
