princekumar983777/TYNOR/Walker Aluminium/Walker Al. with Wheel with Straight Leg/STP/P_fixer.STEP

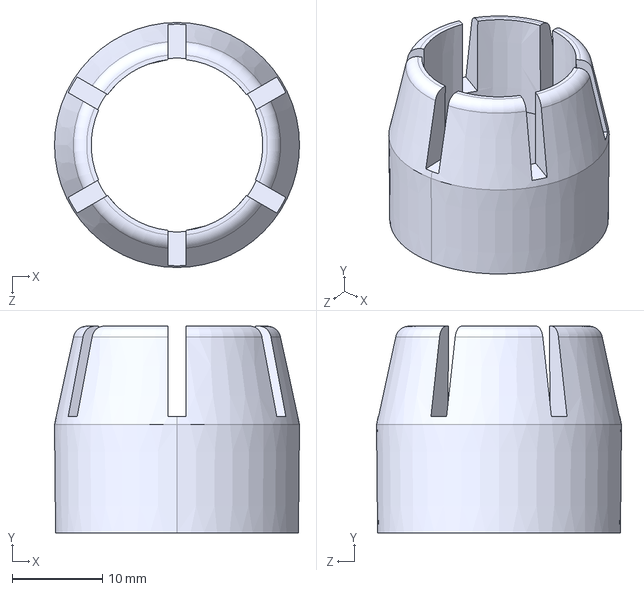
[picture p85: CAD file, 2026-06-26]
Walker Aluminium/Walker Al. with Wheel with Straight Leg/STP/P_fixer.STEP
27.1 x 22.9 x 27.1 mm
