princekumar983777/TYNOR/Walker HD/Walker HD/PART_2 Ergo walker joint Formed.SLDPRT

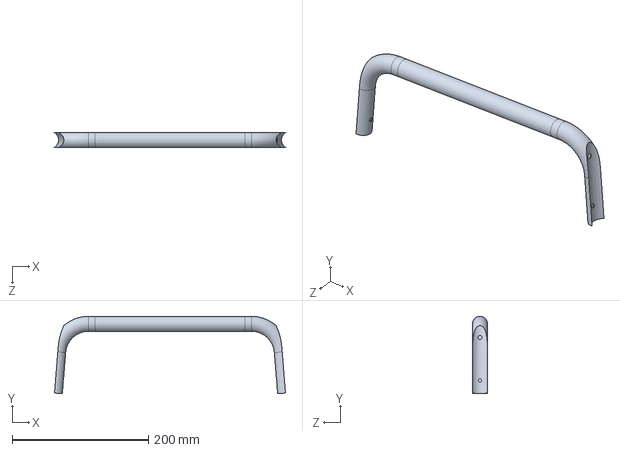
[picture p86: CAD file, 2026-06-25]
Walker HD/Walker HD/PART_2 Ergo walker joint Formed.SLDPRT
339.3 x 113.8 x 22.0 mm
