princekumar983777/TYNOR/Commode Chair Ergo/Commode Chair Ergo/pla_rivets_2.SLDPRT

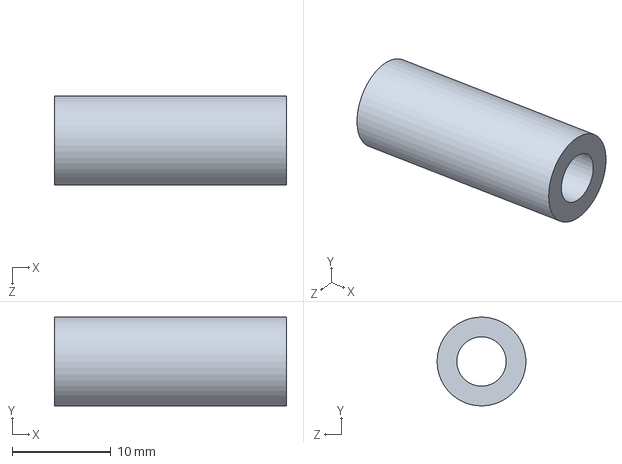
[picture p87: CAD file, 2026-07-01]
Commode Chair Ergo/Commode Chair Ergo/pla_rivets_2.SLDPRT
23.5 x 8.99 x 9.00 mm
