princekumar983777/TYNOR/Walker Aluminium/Simple Walker/PART_3 TLB Tube Outer walker Ergo.SLDPRT

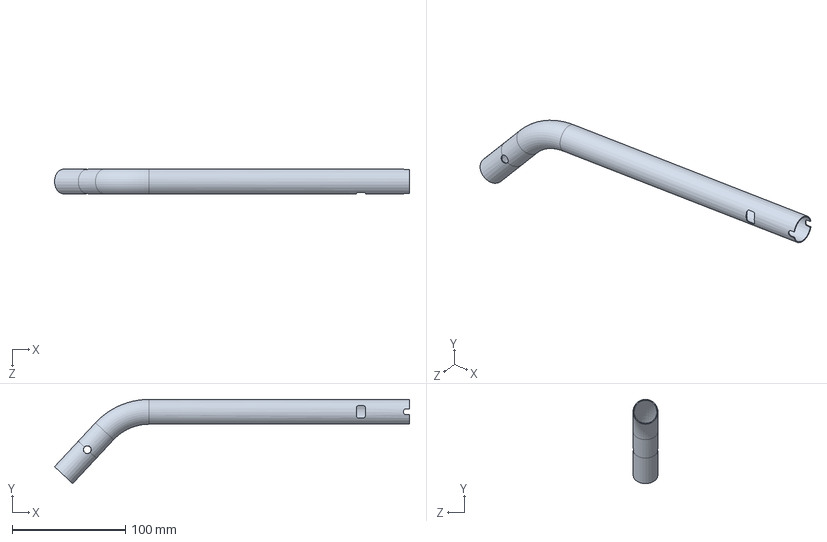
[picture p88: CAD file, 2026-06-25]
Walker Aluminium/Simple Walker/PART_3 TLB Tube Outer walker Ergo.SLDPRT
314.0 x 74.6 x 22.0 mm
