princekumar983777/TYNOR/Walker Aluminium/Walker Al. with Wheel with Straight Leg/STP/P_Handle Part.STEP

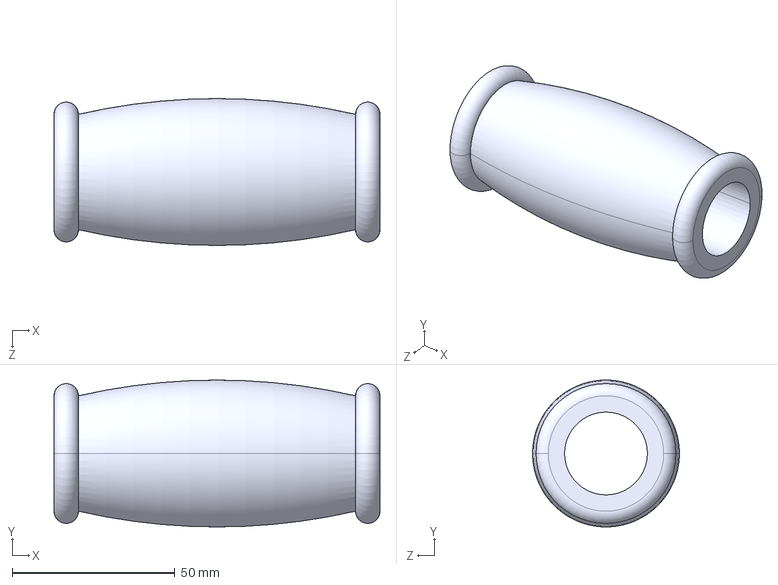
[picture p89: CAD file, 2026-06-26]
Walker Aluminium/Walker Al. with Wheel with Straight Leg/STP/P_Handle Part.STEP
100.0 x 45.1 x 45.1 mm
