princekumar983777/TYNOR/Walker Aluminium/Walker Al. with Wheel with Straight Leg/Walker Al. with Wheel/PART_3_1 TLB Tube Inner.SLDPRT

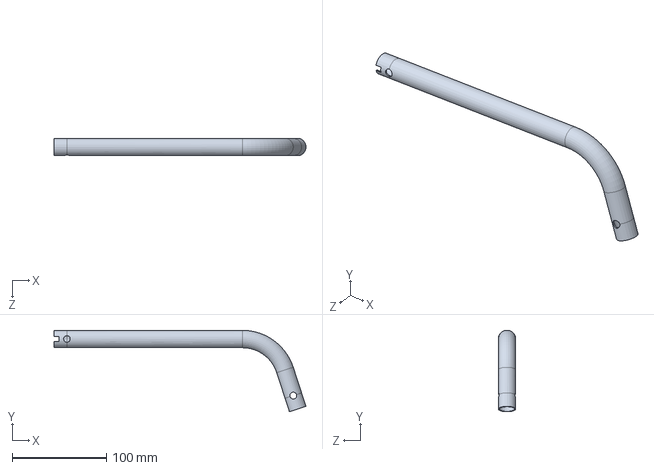
[picture p90: CAD file, 2026-06-25]
Walker Aluminium/Walker Al. with Wheel with Straight Leg/Walker Al. with Wheel/PART_3_1 TLB Tube Inner.SLDPRT
267.2 x 86.4 x 18.5 mm
