princekumar983777/TYNOR/Walker Ergo/Pkug.SLDPRT

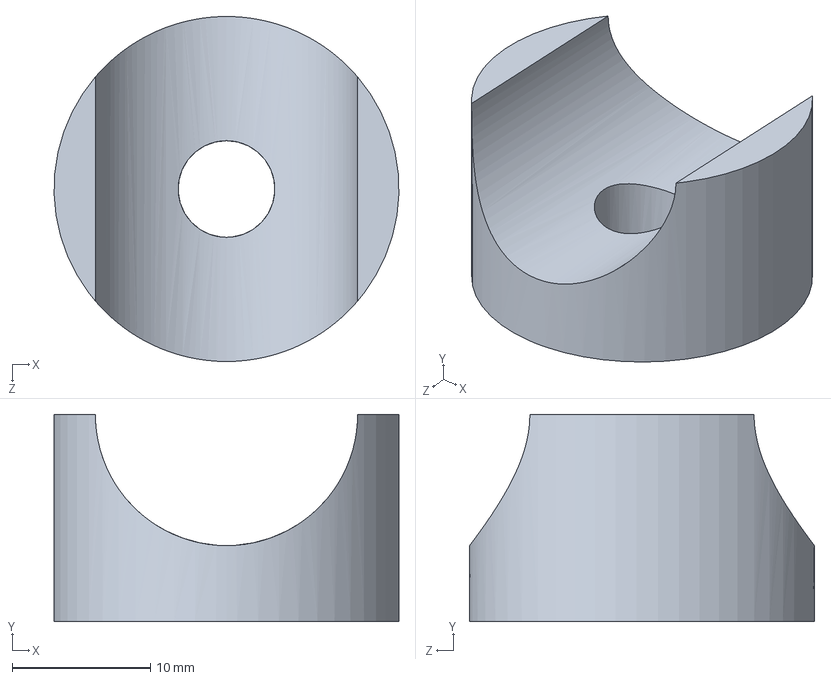
[picture p91: CAD file, 2026-06-25]
Walker Ergo/Pkug.SLDPRT
25.0 x 15.0 x 25.0 mm
