princekumar983777/TYNOR/Commode Chair Ergo/Commode Chair Ergo/Front Leg Frame Commode Chair Ergo.SLDPRT

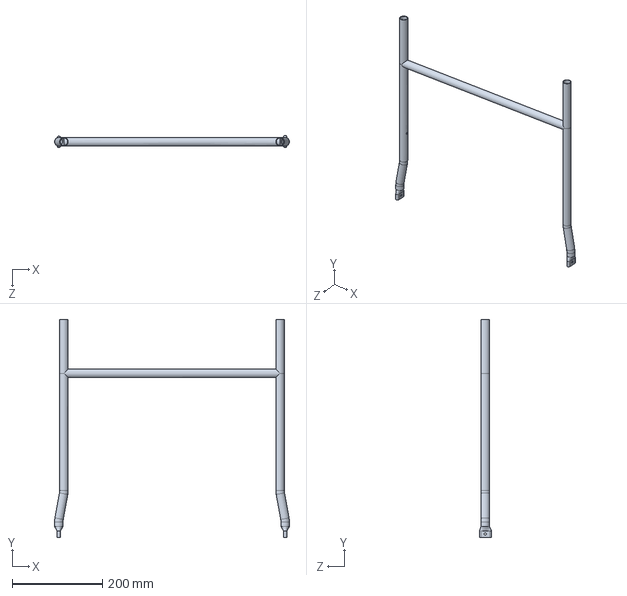
[picture p93: CAD file, 2026-06-30]
Commode Chair Ergo/Commode Chair Ergo/Front Leg Frame Commode Chair Ergo.SLDPRT
522.0 x 485.0 x 27.0 mm
