princekumar983777/TYNOR/Walker HD/Walker HD Fr. Wheel/PART_2 Ergo walker joint Formed.SLDPRT

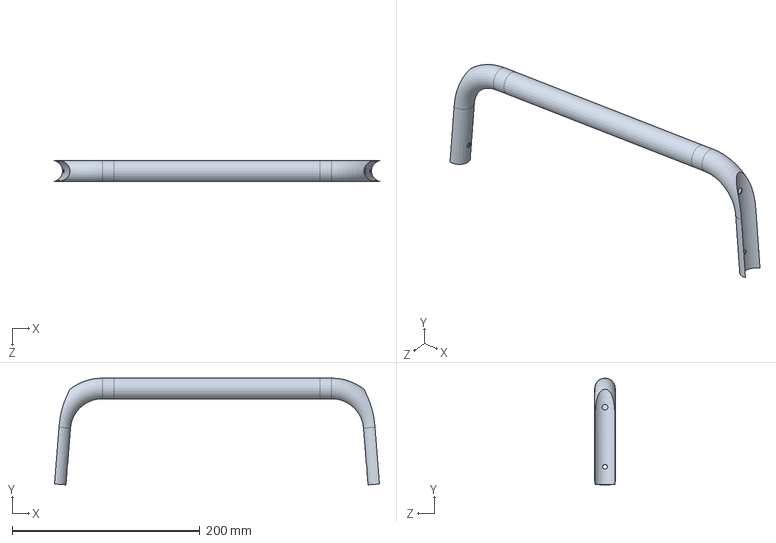
[picture p94: CAD file, 2026-06-17]
Walker HD/Walker HD Fr. Wheel/PART_2 Ergo walker joint Formed.SLDPRT
346.3 x 113.8 x 22.0 mm
