princekumar983777/TYNOR/Walker Aluminium/Simple Walker/P_botom pipe fixed top.SLDPRT

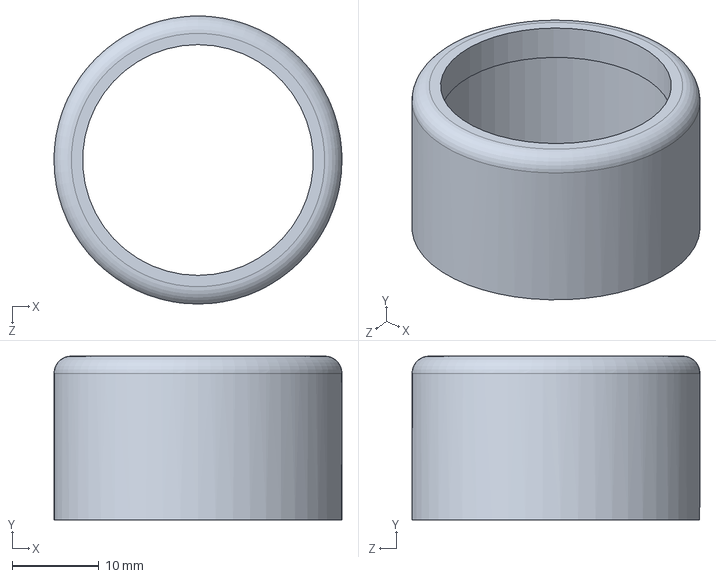
[picture p95: CAD file, 2026-06-25]
Walker Aluminium/Simple Walker/P_botom pipe fixed top.SLDPRT
33.2 x 18.9 x 33.2 mm
