princekumar983777/TYNOR/Walker Aluminium/Walker Al. with Wheel with Straight Leg/STP/P_botom pipe fixed top.STEP

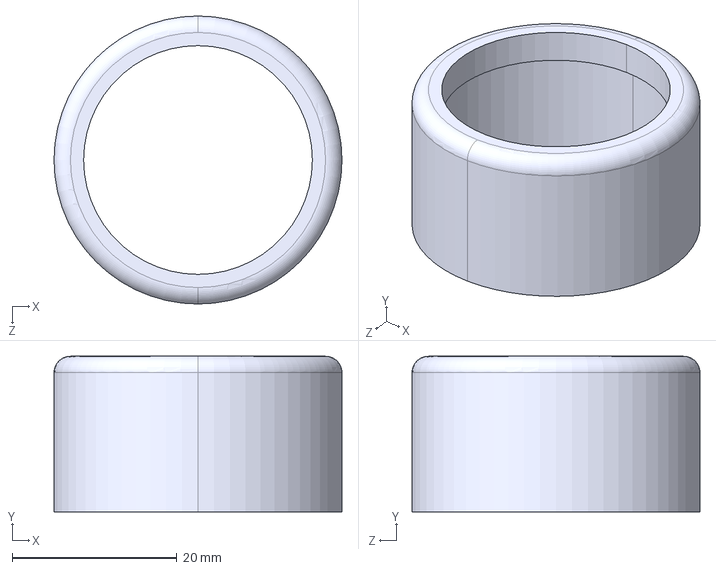
[picture p96: CAD file, 2026-06-26]
Walker Aluminium/Walker Al. with Wheel with Straight Leg/STP/P_botom pipe fixed top.STEP
35.0 x 18.9 x 35.0 mm
