princekumar983777/TYNOR/Walker Aluminium/Walker Al. with Wheel with Straight Leg/Walker Al. with Wheel/PART_3 TLB Tube Outer walker Ergo.SLDPRT

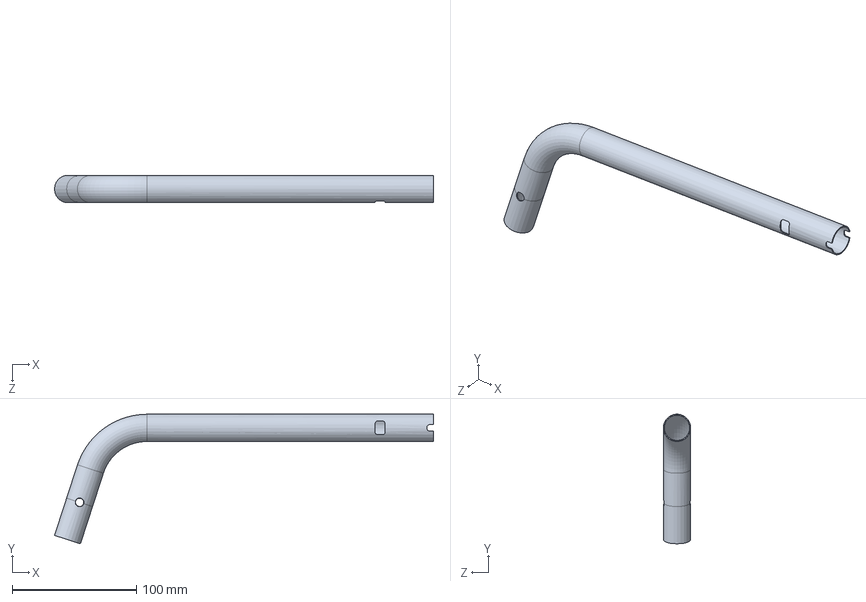
[picture p97: CAD file, 2026-06-25]
Walker Aluminium/Walker Al. with Wheel with Straight Leg/Walker Al. with Wheel/PART_3 TLB Tube Outer walker Ergo.SLDPRT
305.2 x 104.4 x 22.0 mm
