princekumar983777/TYNOR/Walker Ergo/PART_3 TLB Tube Outer walker Ergo.SLDPRT

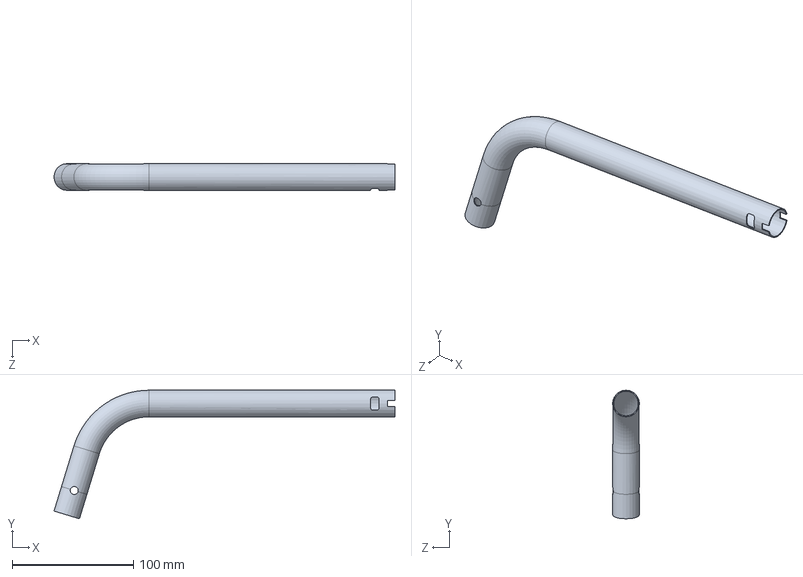
[picture p98: CAD file, 2026-06-25]
Walker Ergo/PART_3 TLB Tube Outer walker Ergo.SLDPRT
281.6 x 106.2 x 22.0 mm
