princekumar983777/TYNOR/Commode Chair Ergo/Commode Chair Ergo/pla_rivets.SLDPRT

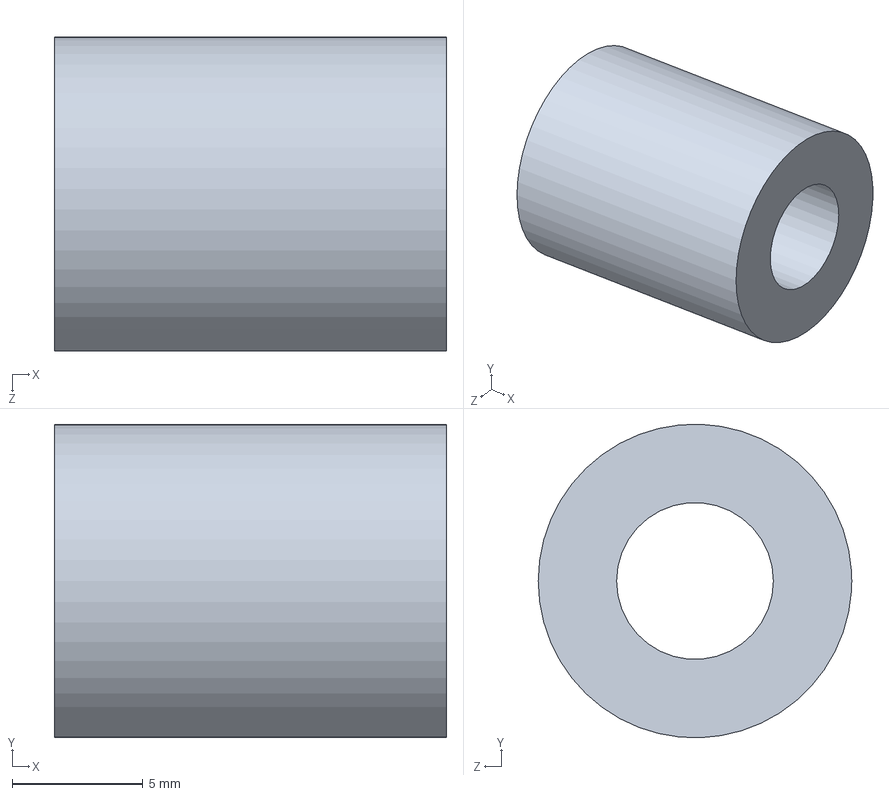
[picture p99: CAD file, 2026-06-30]
Commode Chair Ergo/Commode Chair Ergo/pla_rivets.SLDPRT
15.0 x 12.0 x 12.0 mm
