princekumar983777/TYNOR/Walker Aluminium/Simple Walker/P_Handle Part.SLDPRT

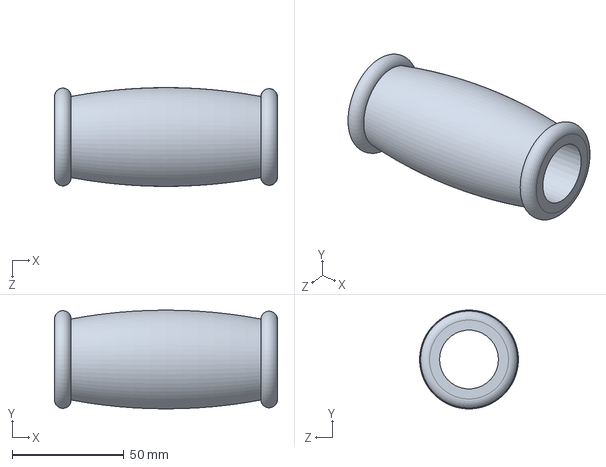
[picture p100: CAD file, 2026-06-25]
Walker Aluminium/Simple Walker/P_Handle Part.SLDPRT
100.0 x 44.3 x 44.3 mm
