princekumar983777/TYNOR/Commode Chair Ergo/Commode Chair Ergo/Rivets.SLDPRT

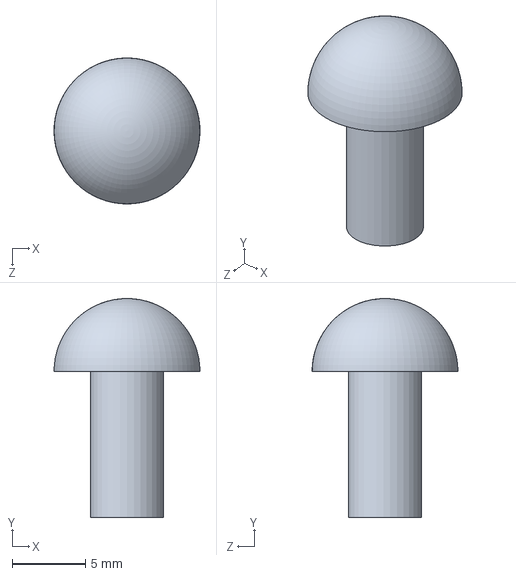
[picture p102: CAD file, 2026-06-30]
Commode Chair Ergo/Commode Chair Ergo/Rivets.SLDPRT
10.00 x 15.0 x 9.99 mm
