princekumar983777/TYNOR/Walker Aluminium/Simple Walker/PART_3_1 TLB Tube Inner.SLDPRT

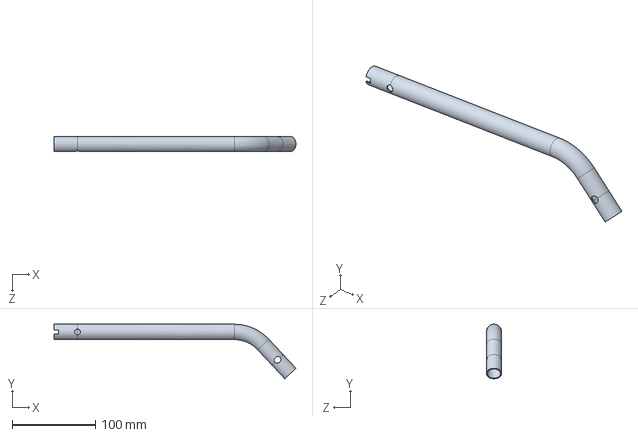
[picture p103: CAD file, 2026-06-25]
Walker Aluminium/Simple Walker/PART_3_1 TLB Tube Inner.SLDPRT
290.4 x 65.6 x 18.5 mm
