princekumar983777/TYNOR/Walker Aluminium/Walker Al. with Wheel with Straight Leg/Walker Al. with Wheel/P_.SLDPRT

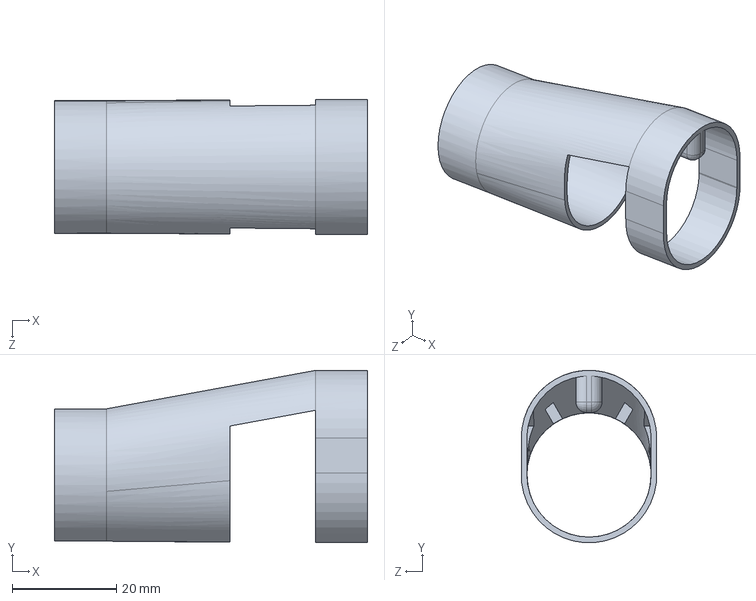
[picture p104: CAD file, 2026-06-17]
Walker Aluminium/Walker Al. with Wheel with Straight Leg/Walker Al. with Wheel/P_.SLDPRT
60.0 x 33.0 x 26.0 mm
