princekumar983777/TYNOR/Commode Chair Ergo/Commode Chair Ergo/PIP.SLDPRT

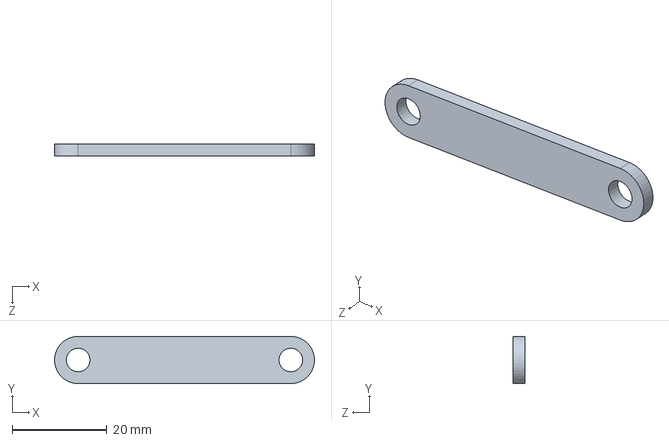
[picture p105: CAD file, 2026-06-30]
Commode Chair Ergo/Commode Chair Ergo/PIP.SLDPRT
55.0 x 10.0 x 2.50 mm
