princekumar983777/TYNOR/Walker Aluminium/Simple Walker/P_.SLDPRT

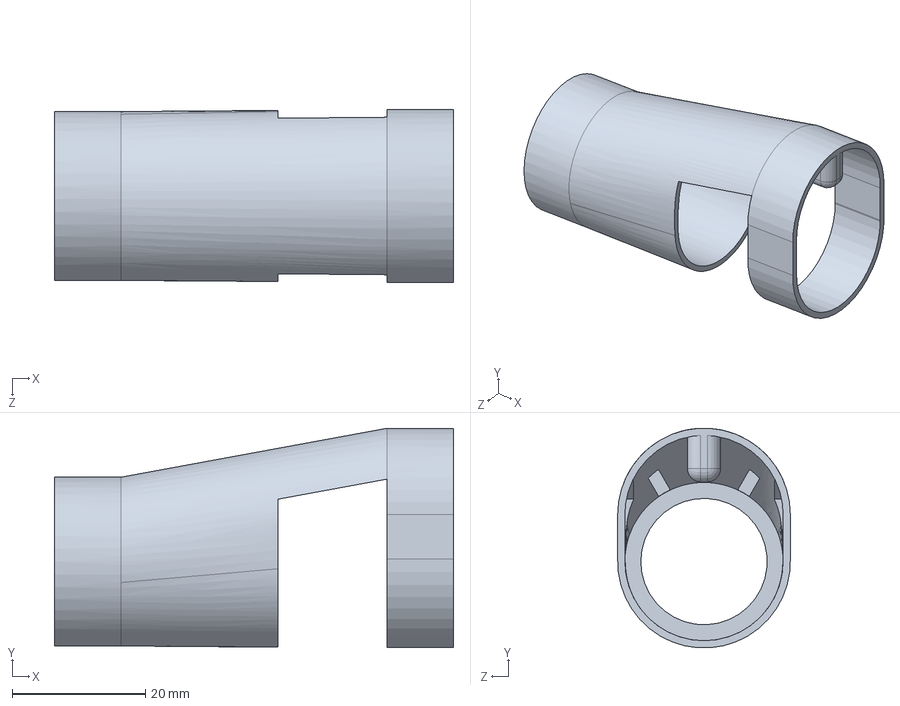
[picture p106: CAD file, 2026-06-25]
Walker Aluminium/Simple Walker/P_.SLDPRT
60.0 x 33.0 x 26.0 mm
