princekumar983777/TYNOR/Walker Aluminium/Walker Al. with Wheel with Straight Leg/STP/Leg Brace for Straight Leg.STEP

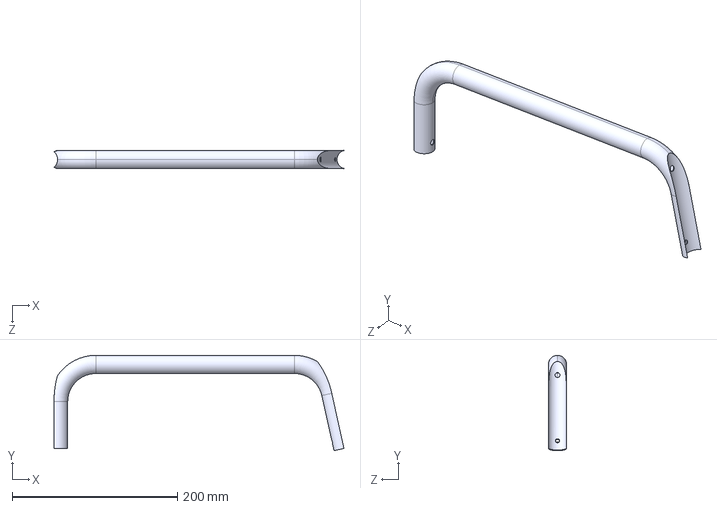
[picture p107: CAD file, 2026-06-26]
Walker Aluminium/Walker Al. with Wheel with Straight Leg/STP/Leg Brace for Straight Leg.STEP
350.6 x 115.3 x 22.0 mm
