princekumar983777/TYNOR/Commode Chair Ergo/Commode Chair Ergo/Seat Frame Wire Commode Chair Ergo.SLDPRT

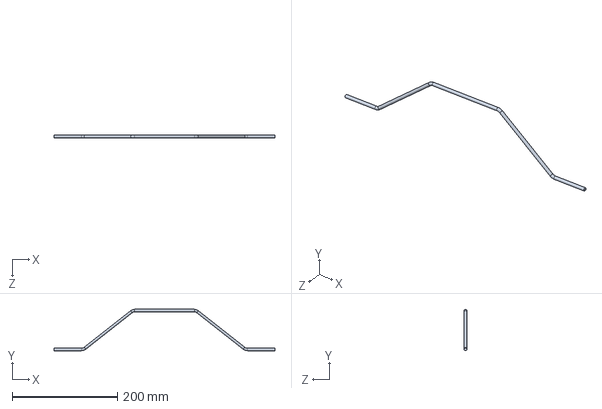
[picture p108: CAD file, 2026-06-30]
Commode Chair Ergo/Commode Chair Ergo/Seat Frame Wire Commode Chair Ergo.SLDPRT
420.0 x 78.9 x 5.00 mm
