princekumar983777/TYNOR/Commode Chair Ergo/Commode Chair Ergo/Seat Frame Commode Chair Ergo.SLDPRT

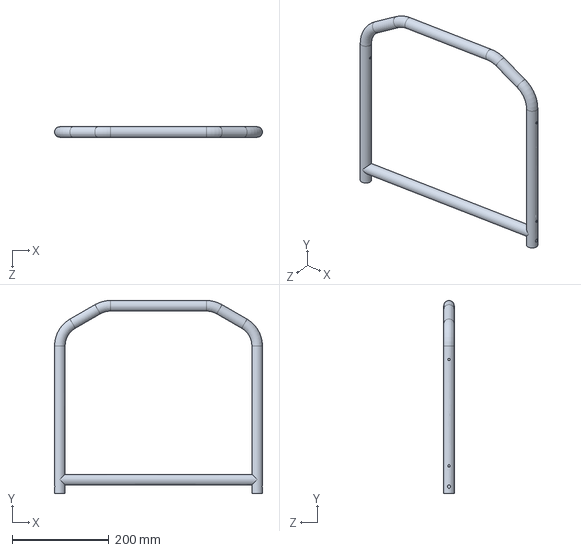
[picture p109: CAD file, 2026-06-30]
Commode Chair Ergo/Commode Chair Ergo/Seat Frame Commode Chair Ergo.SLDPRT
430.0 x 399.0 x 22.0 mm
