princekumar983777/TYNOR/Commode Chair Ergo/Commode Chair Ergo/Front Leg Tube Commode Chair Ergo.SLDPRT

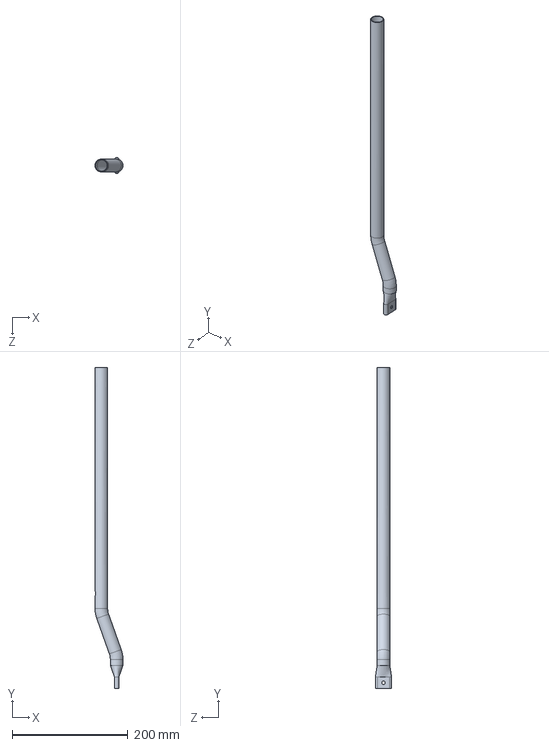
[picture p110: CAD file, 2026-06-29]
Commode Chair Ergo/Commode Chair Ergo/Front Leg Tube Commode Chair Ergo.SLDPRT
48.5 x 554.0 x 28.0 mm
