princekumar983777/TYNOR/Walker Aluminium/Walker Al. with Wheel with Straight Leg/STP/PART_3_1 TLB Tube Inner.STEP

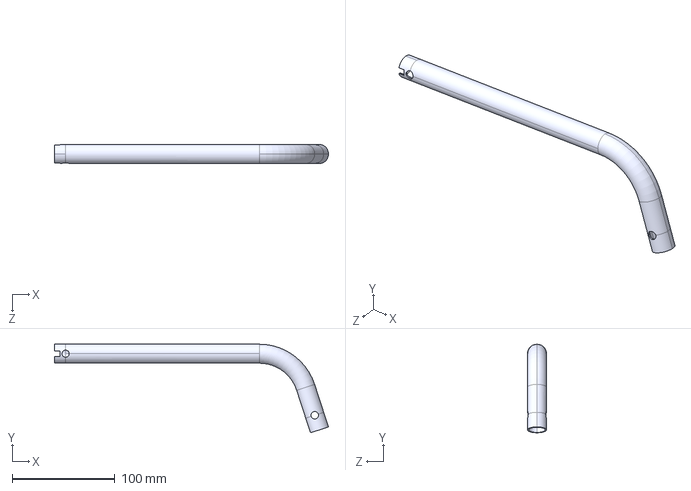
[picture p111: CAD file, 2026-06-26]
Walker Aluminium/Walker Al. with Wheel with Straight Leg/STP/PART_3_1 TLB Tube Inner.STEP
267.2 x 86.4 x 18.5 mm
