princekumar983777/TYNOR/Walker Aluminium/Walker Al. with Wheel with Straight Leg/STP/PART_3 TLB Tube Outer walker Ergo.STEP

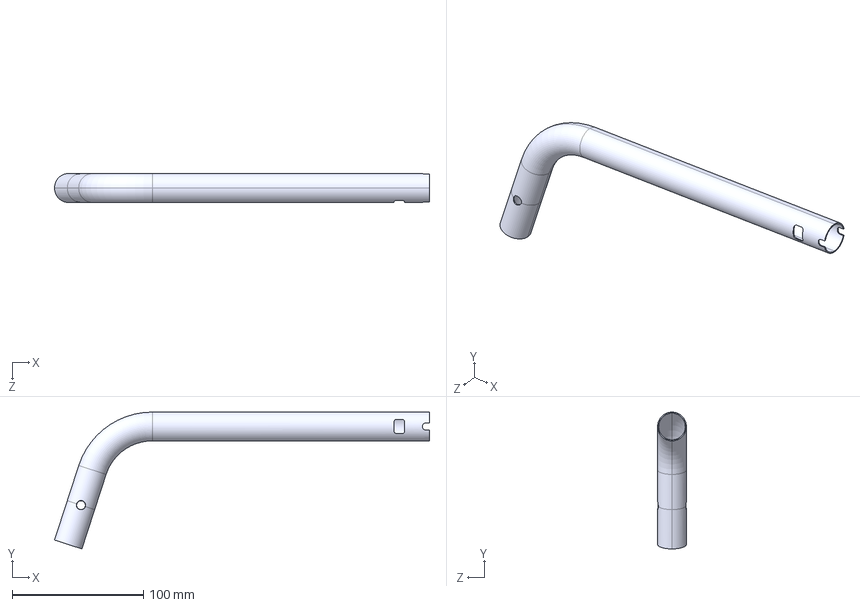
[picture p112: CAD file, 2026-06-26]
Walker Aluminium/Walker Al. with Wheel with Straight Leg/STP/PART_3 TLB Tube Outer walker Ergo.STEP
286.1 x 104.4 x 22.0 mm
