princekumar983777/TYNOR/Walker Aluminium/Walker Al. with Wheel with Straight Leg/Ground Stand.SLDASM

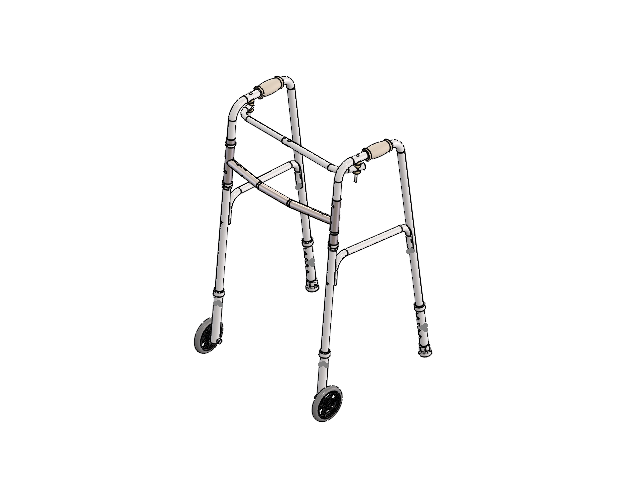
[picture p113: CAD file, 2026-06-26]
Walker Aluminium/Walker Al. with Wheel with Straight Leg/Ground Stand.SLDASM
PART_4 WELDED Coated ERGO WALKER
PART_5 Perforated Pipe D25.4 ERGO WALKER x 2
P_Handle Part x 2
P_botom pipe fixed top x 4
P_fixer - Copy x 2
wheel x 2
bolt x 2
nut x 2
PART_5 Perforated Pipe D25.4 ERGO WALKER - Copy x 2
P_Stand x 2
LOCK_PIN
PART_3 TLB Tube Outer walker Ergo
PART_3_1 TLB Tube Inner
Plug_ x 6
Main_Leg_Straight x 2
Leg Brace for Straight Leg x 2
screw x 2
