princekumar983777/TYNOR/Commode Chair Ergo/Commode Chair Ergo/Assem2.SLDASM

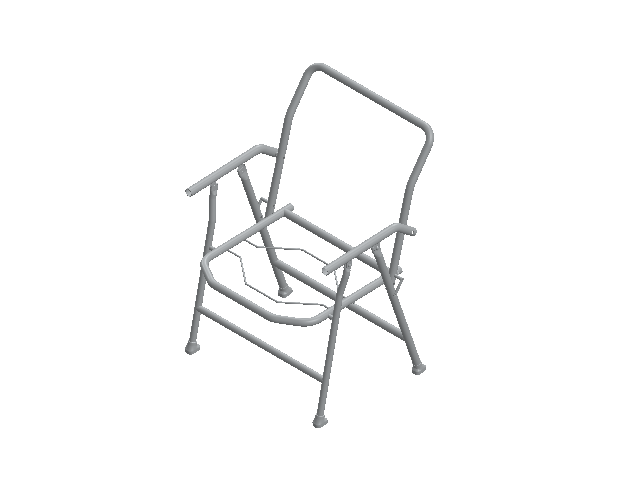
[picture p114: CAD file, 2026-07-01]
Commode Chair Ergo/Commode Chair Ergo/Assem2.SLDASM
Arm rest pipe hinge assembly Commode Chair Ergo x 2
Back Leg Frame Commode Chair Ergo
Front Leg Frame Commode Chair Ergo
Seat Frame Commode Chair Ergo
Seat Frame Wire Commode Chair Ergo x 2
Back Support Tube Commode Chair Ergo
PIP x 2
Rivets x 4
pla_rivets x 2
pla_rivets_2 x 2
pla_rivets_3 x 2
PJug_front x 2
PJug_back x 2
