princekumar983777/TYNOR/Walker Aluminium/Walker Al. with Wheel with Straight Leg/Side Stand With Straight Leg.SLDASM

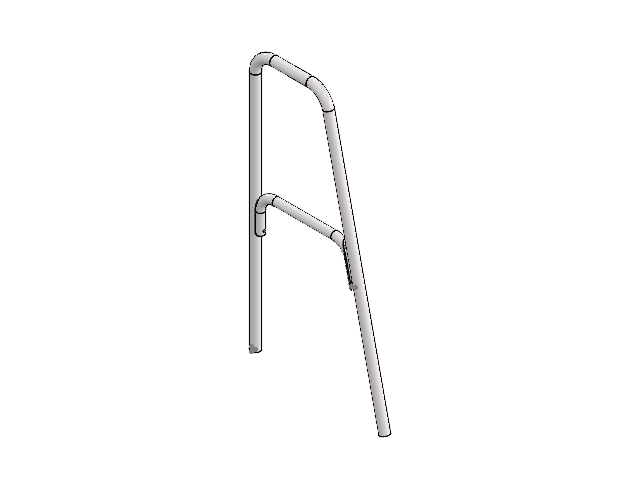
[picture p115: CAD file, 2026-06-25]
Walker Aluminium/Walker Al. with Wheel with Straight Leg/Side Stand With Straight Leg.SLDASM
Main_Leg_Straight
Leg Brace for Straight Leg
