princekumar983777/TYNOR/Commode Chair Ergo/Commode Chair Ergo/Seat frame Assembly.SLDASM

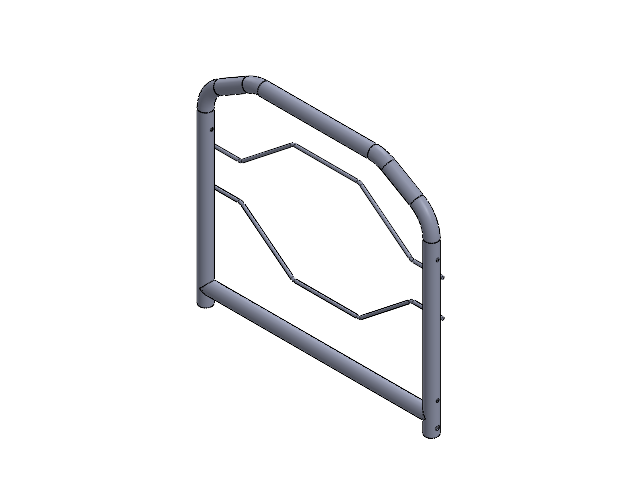
[picture p117: CAD file, 2026-06-30]
Commode Chair Ergo/Commode Chair Ergo/Seat frame Assembly.SLDASM
Seat Frame Commode Chair Ergo
Seat Frame Wire Commode Chair Ergo x 2
