princekumar983777/TYNOR/(list of files, cad)

Other CAD files:
Walker HD/Walker HD Fr. Wheel/SIDE STAND.SLDASM
Walker HD/Walker HD/SIDE STAND.SLDASM
Walker HD/Walker HD Fr. Wheel/PART_1 MAIN LINE.SLDPRT
Walker Aluminium/Walker Al. with Wheel with Straight Leg/Walker Al. with Wheel/SIDE STAND.SLDASM
Walker Ergo/SIDE STAND.SLDASM
Walker HD/Walker HD/PART_1 MAIN LINE.SLDPRT
Walker Aluminium/Walker Al. with Wheel with Straight Leg/STP/Plug_.STEP
Walker Aluminium/Walker Al. with Wheel with Straight Leg/Walker Al. with Wheel/PART_2 Ergo walker joint Formed.SLDPRT
Walker Aluminium/Simple Walker/PART_4 WELDED Coated ERGO WALKER.SLDPRT
Walker Aluminium/Walker Al. with Wheel with Straight Leg/Walker Al. with Wheel/PART_4 WELDED Coated ERGO WALKER.SLDPRT
Walker HD/Walker HD Fr. Wheel/PART_3_1 TLB Tube Inner.SLDPRT
Walker HD/Walker HD Fr. Wheel/PART_3 TLB Tube Outer walker Ergo.SLDPRT
Walker Aluminium/Walker Al. with Wheel with Straight Leg/Walker Al. with Wheel/PART_5 Perforated Pipe D25.4 ERGO WALKER.SLDPRT
Walker Aluminium/Walker Al. with Wheel/PART_4 WELDED Coated ERGO WALKER.SLDPRT
Walker Aluminium/Walker Al. with Wheel with Straight Leg/STP/PART_4 WELDED Coated ERGO WALKER.STEP
Walker Aluminium/Walker Al. with Wheel with Straight Leg/Walker Al. with Wheel/P_botom pipe fixed top.SLDPRT
Walker Aluminium/Walker Al. with Wheel with Straight Leg/Walker Al. with Wheel/P_Stand.SLDPRT
Walker Aluminium/Walker Al. with Wheel with Straight Leg/Walker Al. with Wheel/P_fixer.SLDPRT
Walker Aluminium/Walker Al. with Wheel with Straight Leg/STP/P_.STEP
Walker Aluminium/Walker Al. with Wheel with Straight Leg/Walker Al. with Wheel/P_Handle Part.SLDPRT
Walker Aluminium/Walker Al. with Wheel with Straight Leg/STP/PART_5 Perforated Pipe D25.4 ERGO WALKER.STEP
Commode Chair Ergo/Commode Chair Ergo/Arm rest pipe hinge assembly Commode Chair Ergo.SLDDRW
Commode Chair Ergo/Commode Chair Ergo/Assem2.SLDDRW
Commode Chair Ergo/Commode Chair Ergo/Back Leg Frame Commode Chair Ergo.SLDDRW
Commode Chair Ergo/Commode Chair Ergo/Back Support Tube Commode Chair Ergo.SLDDRW
Commode Chair Ergo/Commode Chair Ergo/Front Leg Frame Commode Chair Ergo.SLDDRW
Commode Chair Ergo/Commode Chair Ergo/Front Leg Tube Commode Chair Ergo.SLDDRW
Commode Chair Ergo/Commode Chair Ergo/PIP.SLDDRW
Commode Chair Ergo/Commode Chair Ergo/Seat Frame Commode Chair Ergo.SLDDRW
Commode Chair Ergo/Commode Chair Ergo/Seat frame Assembly.SLDDRW
Walker Aluminium/Simple Walker/Assembly 1.0.SLDDRW
Walker Aluminium/Simple Walker/LOCK_PIN.SLDDRW
Walker Aluminium/Simple Walker/PART_1 MAIN LINE.SLDDRW
Walker Aluminium/Simple Walker/PART_2 Ergo walker joint Formed.SLDDRW
Walker Aluminium/Simple Walker/PART_3 TLB Tube Outer walker Ergo.SLDDRW
Walker Aluminium/Simple Walker/PART_3_1 TLB Tube Inner.SLDDRW
Walker Aluminium/Simple Walker/PART_4 WELDED Coated ERGO WALKER.SLDDRW
Walker Aluminium/Simple Walker/PART_5 Perforated Pipe D25.4 AL WALKER.SLDDRW
Walker Aluminium/Simple Walker/PART_5 Perforated Pipe D25.4 ERGO WALKER.SLDDRW
Walker Aluminium/Walker Al. with Wheel with Straight Leg/Assembly 1.0.SLDASM
Walker Aluminium/Walker Al. with Wheel with Straight Leg/Assembly 1.0.SLDDRW
Walker Aluminium/Walker Al. with Wheel with Straight Leg/Ground Stand.SLDDRW
Walker Aluminium/Walker Al. with Wheel with Straight Leg/LOCK_PIN.SLDDRW
Walker Aluminium/Walker Al. with Wheel with Straight Leg/Leg Brace for Straight Leg.SLDPRT
Walker Aluminium/Walker Al. with Wheel with Straight Leg/Main_Leg_Straight.SLDDRW
Walker Aluminium/Walker Al. with Wheel with Straight Leg/Main_Leg_Straight.SLDPRT
Walker Aluminium/Walker Al. with Wheel with Straight Leg/PART_1 MAIN LINE.SLDDRW
Walker Aluminium/Walker Al. with Wheel with Straight Leg/PART_2 Ergo walker joint Formed.SLDDRW
Walker Aluminium/Walker Al. with Wheel with Straight Leg/PART_3 TLB Tube Outer walker Ergo.SLDDRW
Walker Aluminium/Walker Al. with Wheel with Straight Leg/PART_3_1 TLB Tube Inner.SLDDRW
Walker Aluminium/Walker Al. with Wheel with Straight Leg/PART_4 WELDED Coated ERGO WALKER.SLDDRW
Walker Aluminium/Walker Al. with Wheel with Straight Leg/PART_4 WELDED Coated ERGO WALKER.SLDPRT
Walker Aluminium/Walker Al. with Wheel with Straight Leg/PART_5 Perforated Pipe D25.4 ERGO WALKER - Copy.SLDDRW
Walker Aluminium/Walker Al. with Wheel with Straight Leg/PART_5 Perforated Pipe D25.4 ERGO WALKER - Copy.SLDPRT
Walker Aluminium/Walker Al. with Wheel with Straight Leg/PART_5 Perforated Pipe D25.4 ERGO WALKER.SLDDRW
Walker Aluminium/Walker Al. with Wheel with Straight Leg/PART_5 Perforated Pipe D25.4 ERGO WALKER.SLDPRT
Walker Aluminium/Walker Al. with Wheel with Straight Leg/P_Handle Part.SLDPRT
Walker Aluminium/Walker Al. with Wheel with Straight Leg/P_Stand.SLDPRT
Walker Aluminium/Walker Al. with Wheel with Straight Leg/P_botom pipe fixed top.SLDPRT
Walker Aluminium/Walker Al. with Wheel with Straight Leg/P_fixer - Copy.SLDPRT
Walker Aluminium/Walker Al. with Wheel with Straight Leg/P_fixer.SLDPRT
Walker Aluminium/Walker Al. with Wheel with Straight Leg/STP/PART_5 Perforated Pipe D25.4 ERGO WALKER - Copy.STEP
Walker Aluminium/Walker Al. with Wheel with Straight Leg/STP/P_fixer - Copy.STEP
Walker Aluminium/Walker Al. with Wheel with Straight Leg/STP/nut.STEP
Walker Aluminium/Walker Al. with Wheel with Straight Leg/STP/screw.STEP
Walker Aluminium/Walker Al. with Wheel with Straight Leg/WE-A1.SLDDRW
Walker Aluminium/Walker Al. with Wheel with Straight Leg/Walker Al. with Wheel/Ground Stand.SLDDRW
Walker Aluminium/Walker Al. with Wheel with Straight Leg/Walker Al. with Wheel/LOCK_PIN.SLDDRW
Walker Aluminium/Walker Al. with Wheel with Straight Leg/Walker Al. with Wheel/PART_1 MAIN LINE.SLDDRW
Walker Aluminium/Walker Al. with Wheel with Straight Leg/Walker Al. with Wheel/PART_2 Ergo walker joint Formed.SLDDRW
Walker Aluminium/Walker Al. with Wheel with Straight Leg/Walker Al. with Wheel/PART_3 TLB Tube Outer walker Ergo.SLDDRW
Walker Aluminium/Walker Al. with Wheel with Straight Leg/Walker Al. with Wheel/PART_3_1 TLB Tube Inner.SLDDRW
Walker Aluminium/Walker Al. with Wheel with Straight Leg/Walker Al. with Wheel/PART_4 WELDED Coated ERGO WALKER.SLDDRW
Walker Aluminium/Walker Al. with Wheel with Straight Leg/Walker Al. with Wheel/PART_5 Perforated Pipe D25.4 ERGO WALKER - Copy.SLDDRW
Walker Aluminium/Walker Al. with Wheel with Straight Leg/Walker Al. with Wheel/PART_5 Perforated Pipe D25.4 ERGO WALKER - Copy.SLDPRT
Walker Aluminium/Walker Al. with Wheel with Straight Leg/Walker Al. with Wheel/PART_5 Perforated Pipe D25.4 ERGO WALKER.SLDDRW
Walker Aluminium/Walker Al. with Wheel with Straight Leg/Walker Al. with Wheel/P_fixer - Copy.SLDPRT
Walker Aluminium/Walker Al. with Wheel with Straight Leg/Walker Al. with Wheel/WE-A1.SLDDRW
Walker Aluminium/Walker Al. with Wheel with Straight Leg/Walker Al. with Wheel/Wheel/bolt.SLDPRT
Walker Aluminium/Walker Al. with Wheel with Straight Leg/Walker Al. with Wheel/Wheel/wheel.SLDDRW
Walker Aluminium/Walker Al. with Wheel with Straight Leg/Walker Al. with Wheel/nut.SLDPRT
Walker Aluminium/Walker Al. with Wheel with Straight Leg/Walker Al. with Wheel/screw.SLDPRT
Walker Aluminium/Walker Al. with Wheel with Straight Leg/Wheel/bolt.SLDPRT
Walker Aluminium/Walker Al. with Wheel with Straight Leg/Wheel/wheel.SLDDRW
Walker Aluminium/Walker Al. with Wheel with Straight Leg/nut.SLDPRT
Walker Aluminium/Walker Al. with Wheel with Straight Leg/screw.SLDPRT
Walker Aluminium/Walker Al. with Wheel/LOCK_PIN.SLDDRW
Walker Aluminium/Walker Al. with Wheel/Maf_of_TLB_inner.SLDDRW
Walker Aluminium/Walker Al. with Wheel/Maf_of_TLb_Outer.SLDDRW
Walker Aluminium/Walker Al. with Wheel/PART_3 TLB Tube Outer walker Ergo.SLDDRW
Walker Aluminium/Walker Al. with Wheel/PART_3_1 TLB Tube Inner.SLDDRW
Walker Aluminium/Walker Al. with Wheel/TLB_OUTER_Using_Bending.SLDDRW
Walker Aluminium/Walker Al. with Wheel/screw.SLDPRT
Walker Ergo/Assembly 1.0 - Copy.SLDASM
Walker Ergo/Ground Stand.SLDDRW
Walker Ergo/PART_1 MAIN LINE.SLDDRW
Walker Ergo/PART_2 Ergo walker joint Formed.SLDDRW
Walker Ergo/PART_3 TLB Tube Outer walker Ergo.SLDDRW
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
