princekumar983777/TYNOR/Walker Ergo/Walker Foldable Ergo Assembly.pdf

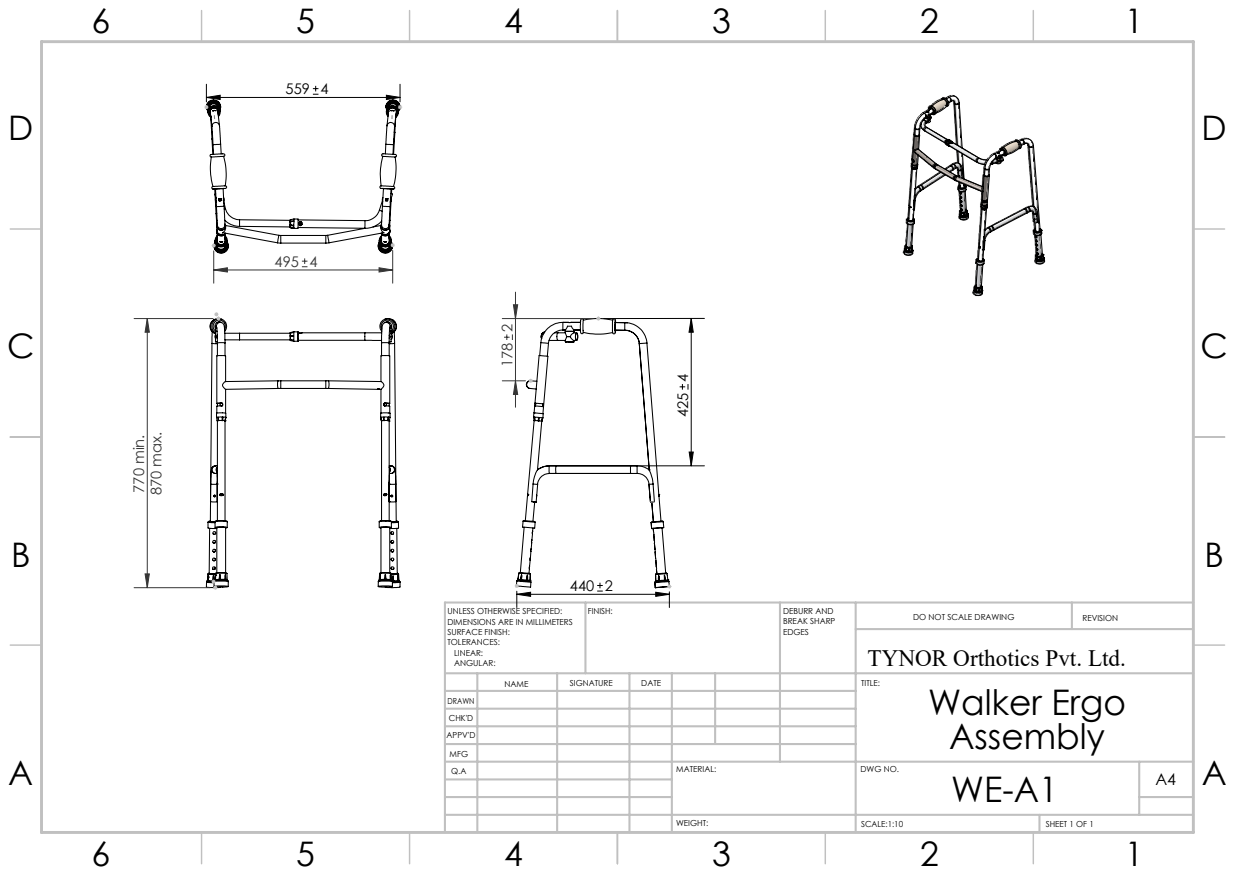
[picture p118: page 1]
770 min.; 870 max.; FINISH:; DEBURR AND; BREAK SHARP; DO NOT SCALE DRAWING; REVISION; SCALE:1:10; SHEET 1 OF 1

UNLESS OTHERWISE SPECIFIED:
DIMENSIONS ARE IN MILLIMETERS
SURFACE FINISH:
TOLERANCES:
LINEAR:
ANGULAR:

TYNOR Orthotics Pvt. Ltd.

NAME | SIGNATURE | DATE | | | | TITLE: Walker Ergo Assembly

DRAWN
CHK'D
APPV'D
MFG
Q.A | | | | MATERIAL: | DWG NO. WE-A1 | A4
