princekumar983777/TYNOR/Commode Chair Ergo/Commode Chair Ergo/Arm rest pipe hinge assembly Commode Chair Ergo.pdf

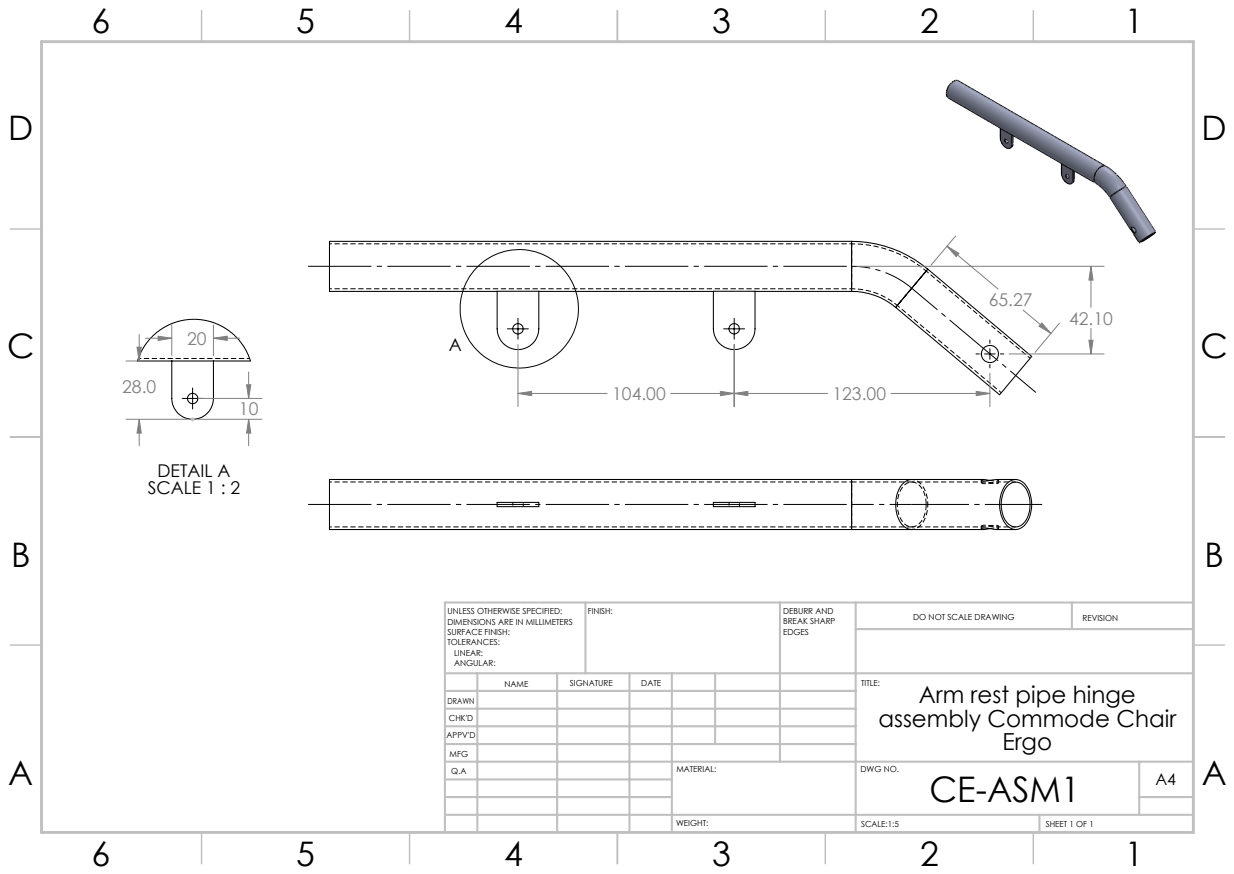
[picture p119: page 1]
DETAIL A SCALE 1 : 2; FINISH:; DEBURR AND; BREAK SHARP; DO NOT SCALE DRAWING; REVISION; SCALE:1:5; SHEET 1 OF 1

UNLESS OTHERWISE SPECIFIED:
DIMENSIONS ARE IN MILLIMETERS
SURFACE FINISH:
TOLERANCES:
LINEAR:
ANGULAR:

NAME | SIGNATURE | DATE | | | | TITLE: Arm rest pipe hinge assembly Commode Chair Ergo

DRAWN
CHK'D
APPV'D
MFG
Q.A | | | | MATERIAL: | DWG NO. CE-ASM1 | A4
