princekumar983777/TYNOR/Walker Ergo/Leg Brace Walker Ergo.pdf

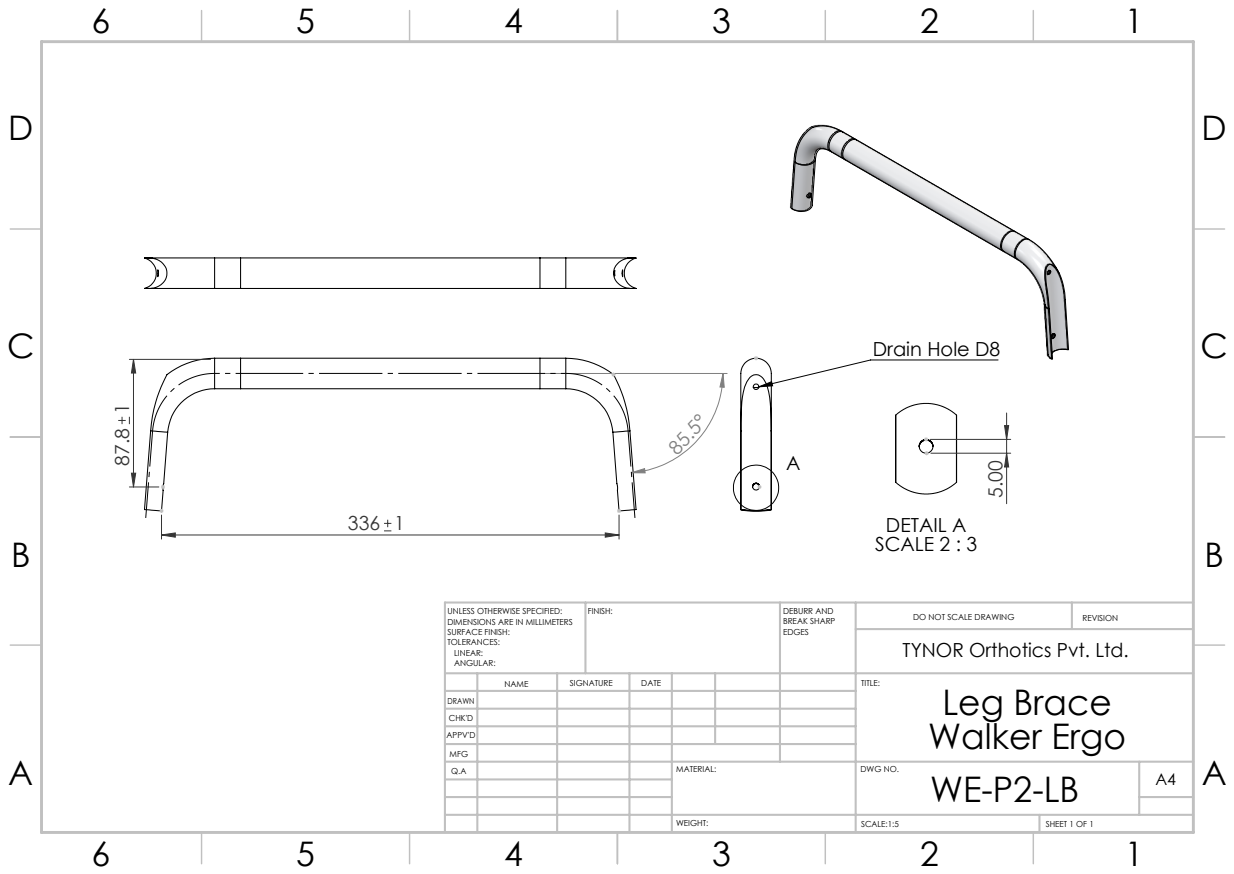
[picture p122: page 1]
Drain Hole D8 5.00; DETAIL A SCALE 2 : 3; FINISH:; DEBURR AND; BREAK SHARP; DO NOT SCALE DRAWING; REVISION; SCALE:1:5; SHEET 1 OF 1

UNLESS OTHERWISE SPECIFIED:
DIMENSIONS ARE IN MILLIMETERS
SURFACE FINISH:
TOLERANCES:
LINEAR:
ANGULAR:

TYNOR Orthotics Pvt. Ltd.

NAME | SIGNATURE | DATE | | | | TITLE: Leg Brace Walker Ergo

DRAWN
CHK'D
APPV'D
MFG
Q.A | | | | MATERIAL: | DWG NO. WE-P2-LB | A4
