princekumar983777/TYNOR/Walker Ergo/Leg Perforated Walker Ergo.pdf

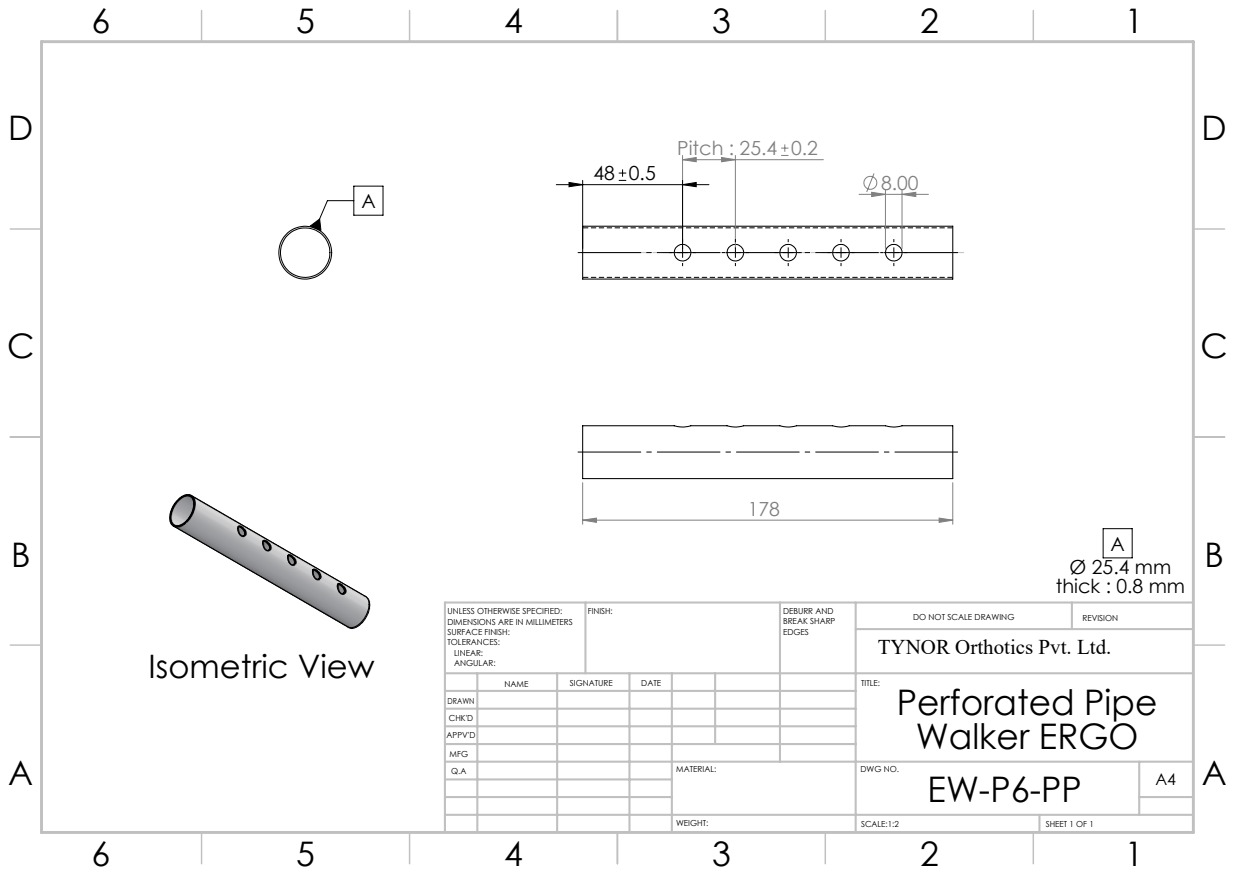
[picture p123: page 1]
Pitch : 25.4; Isometric View; TYNOR Orthotics Pvt. Ltd.; Ø 25.4 mm thick : 0.8 mm; FINISH:; DEBURR AND; BREAK SHARP; DO NOT SCALE DRAWING; REVISION; SCALE:1:2; SHEET 1 OF 1

UNLESS OTHERWISE SPECIFIED:
DIMENSIONS ARE IN MILLIMETERS
SURFACE FINISH:
TOLERANCES:
LINEAR:
ANGULAR:

NAME | SIGNATURE | DATE | | | | TITLE: Perforated Pipe Walker ERGO

DRAWN
CHK'D
APPV'D
MFG
Q.A | | | | MATERIAL: | DWG NO. EW-P6-PP | A4
