princekumar983777/TYNOR/Walker Ergo/Main Leg Walker Ergo.pdf

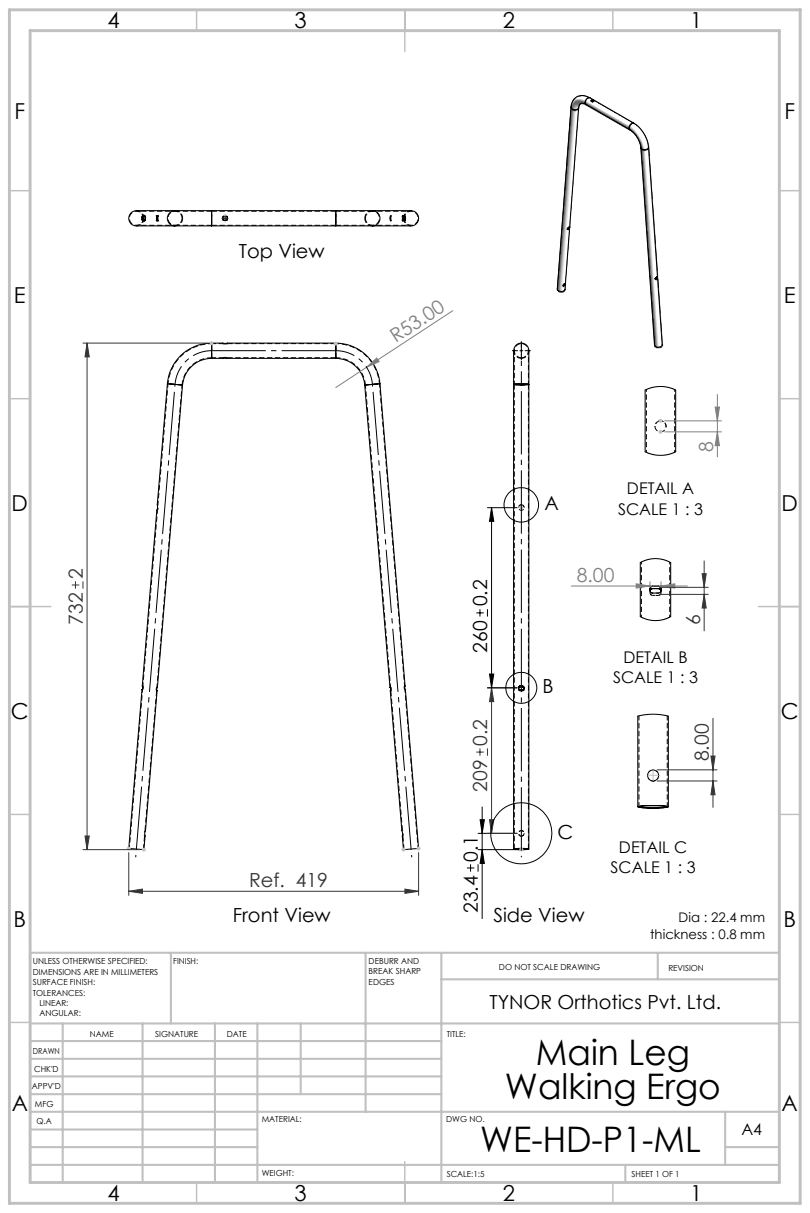
[picture p124: page 1]
Ref. 419; Side View; Top View; Front View; DETAIL A SCALE 1 : 3; DETAIL B SCALE 1 : 3 8.00; DETAIL C SCALE 1 : 3; Dia : 22.4 mm thickness : 0.8 mm; FINISH:; DEBURR AND; BREAK SHARP; DO NOT SCALE DRAWING; REVISION; SCALE:1:5; SHEET 1 OF 1

UNLESS OTHERWISE SPECIFIED:
DIMENSIONS ARE IN MILLIMETERS
SURFACE FINISH:
TOLERANCES:
LINEAR:
ANGULAR:

TYNOR Orthotics Pvt. Ltd.

NAME | SIGNATURE | DATE | | | | TITLE: Main Leg Walking Ergo

DRAWN
CHK'D
APPV'D
MFG
Q.A | | | | MATERIAL: | DWG NO. WE-HD-P1-ML | A4
