princekumar983777/TYNOR/Walker Ergo/TLB Outer Walker Ergo.pdf

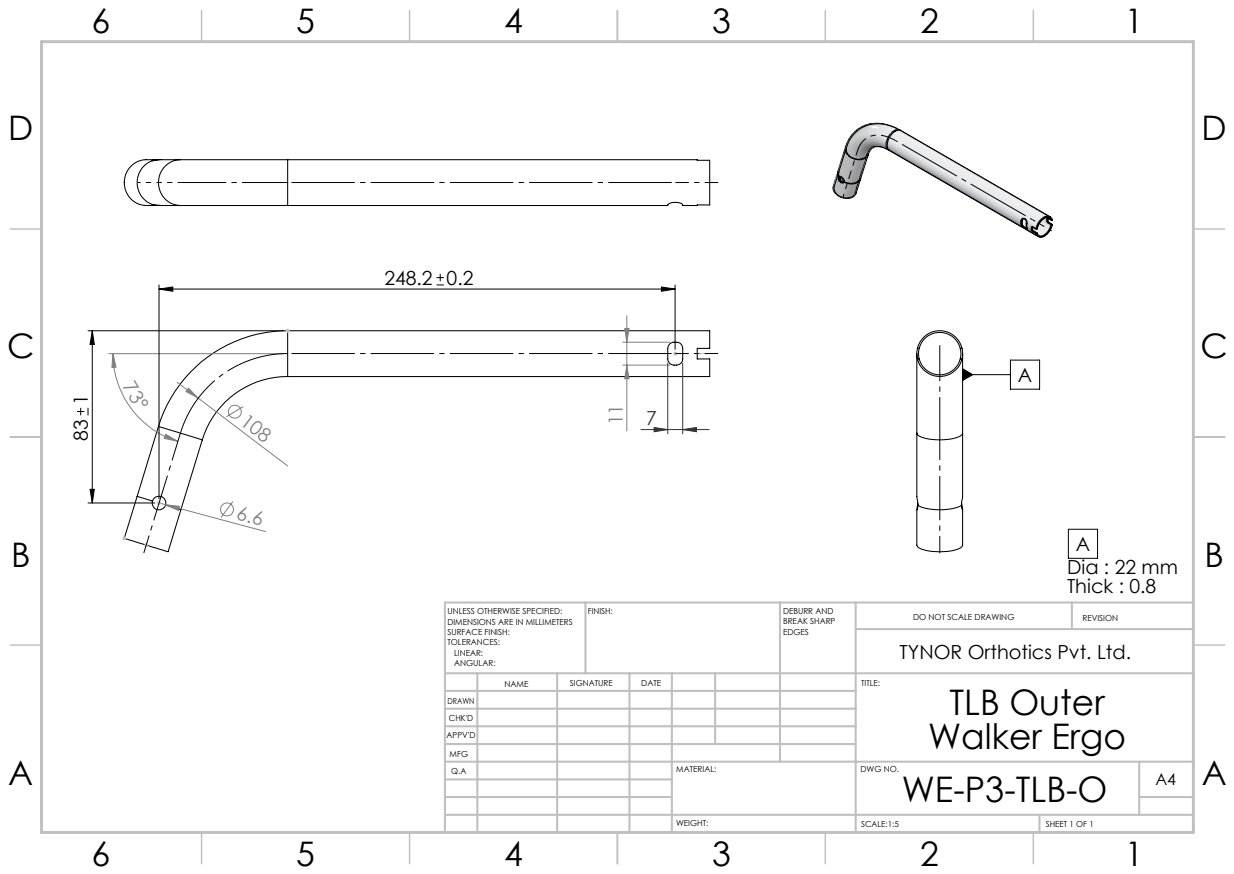
[picture p125: page 1]
Dia : 22 mm Thick : 0.8; FINISH:; DEBURR AND; BREAK SHARP; DO NOT SCALE DRAWING; REVISION; SCALE:1:5; SHEET 1 OF 1

UNLESS OTHERWISE SPECIFIED:
DIMENSIONS ARE IN MILLIMETERS
SURFACE FINISH:
TOLERANCES:
LINEAR:
ANGULAR:

TYNOR Orthotics Pvt. Ltd.

NAME | SIGNATURE | DATE | | | | TITLE: TLB Outer Walker Ergo

DRAWN
CHK'D
APPV'D
MFG
Q.A | | | | MATERIAL: | DWG NO. WE-P3-TLB-O | A4
