princekumar983777/TYNOR/Walker Ergo/Welded Brace Walker Ergo.pdf

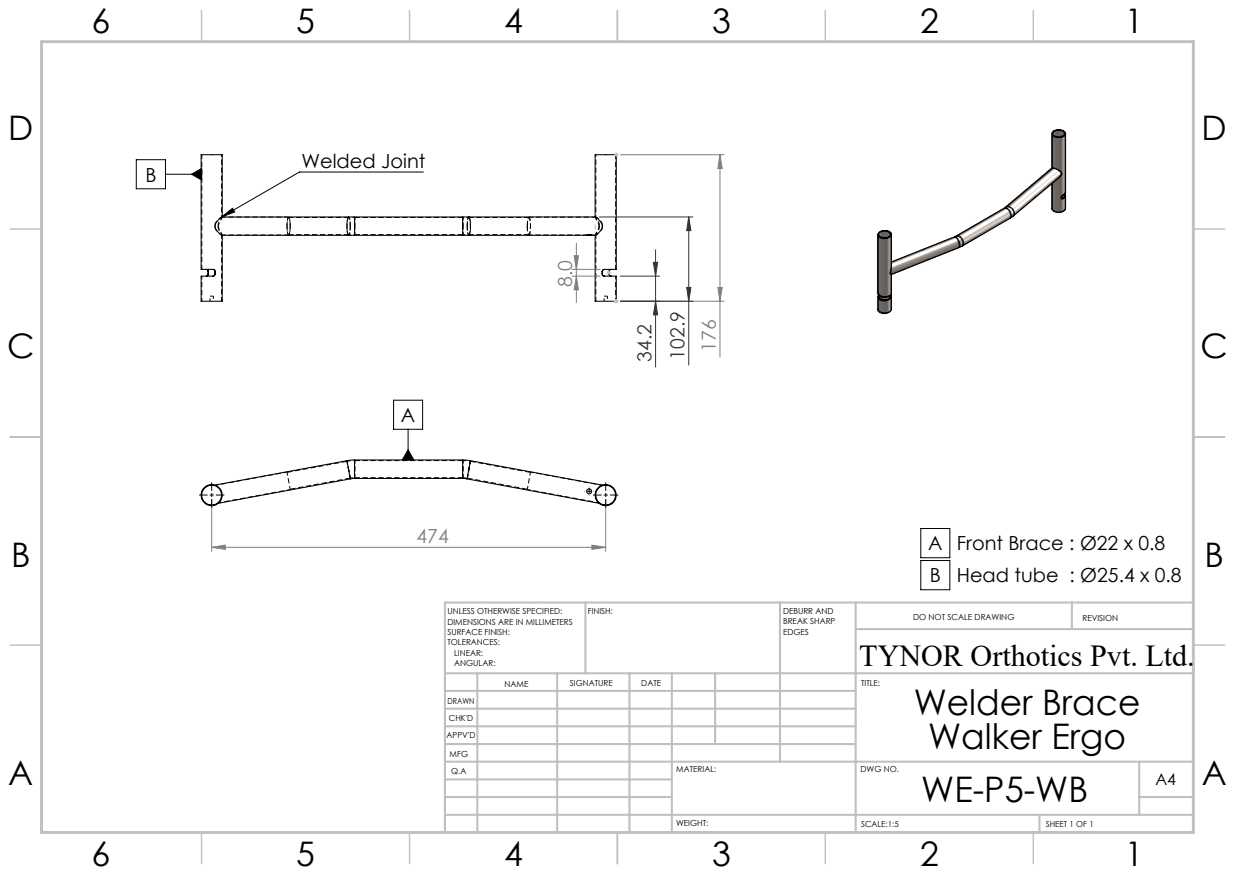
[picture p126: page 1]
Welded Joint B; Front Brace : Ø22 x 0.8; Head tube : Ø25.4 x 0.8; FINISH:; DEBURR AND; BREAK SHARP; DO NOT SCALE DRAWING; REVISION; SCALE:1:5; SHEET 1 OF 1

TYNOR Orthotics Pvt. Ltd.

UNLESS OTHERWISE SPECIFIED:
DIMENSIONS ARE IN MILLIMETERS
SURFACE FINISH:
TOLERANCES:
LINEAR:
ANGULAR:

NAME | SIGNATURE | DATE | | | | TITLE: Welder Brace Walker Ergo

DRAWN
CHK'D
APPV'D
MFG
Q.A | | | | MATERIAL: | DWG NO. WE-P5-WB | A4
