princekumar983777/TYNOR/Walker Ergo/PART_1 MAIN LINE.pdf

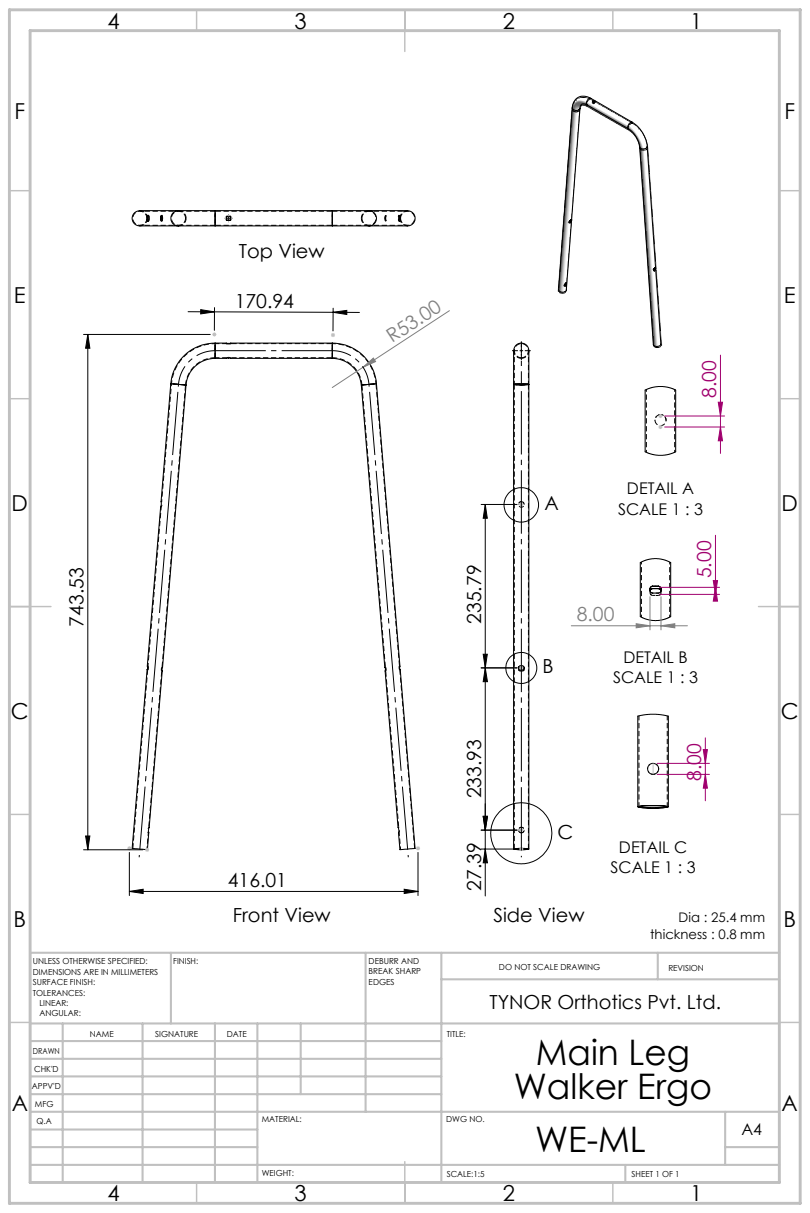
[picture p127: page 1]
Side View; Top View; Front View; DETAIL A SCALE 1 : 3 5.00; DETAIL B SCALE 1 : 3 8.00; DETAIL C SCALE 1 : 3; Dia : 25.4 mm thickness : 0.8 mm; FINISH:; DEBURR AND; BREAK SHARP; DO NOT SCALE DRAWING; REVISION; SCALE:1:5; SHEET 1 OF 1

UNLESS OTHERWISE SPECIFIED:
DIMENSIONS ARE IN MILLIMETERS
SURFACE FINISH:
TOLERANCES:
LINEAR:
ANGULAR:

TYNOR Orthotics Pvt. Ltd.

NAME | SIGNATURE | DATE | | | | TITLE: Main Leg Walker Ergo

DRAWN
CHK'D
APPV'D
MFG
Q.A | | | | MATERIAL: | DWG NO. WE-ML | A4
