princekumar983777/TYNOR/Walker Ergo/PART_4 WELDED Coated ERGO WALKER.pdf

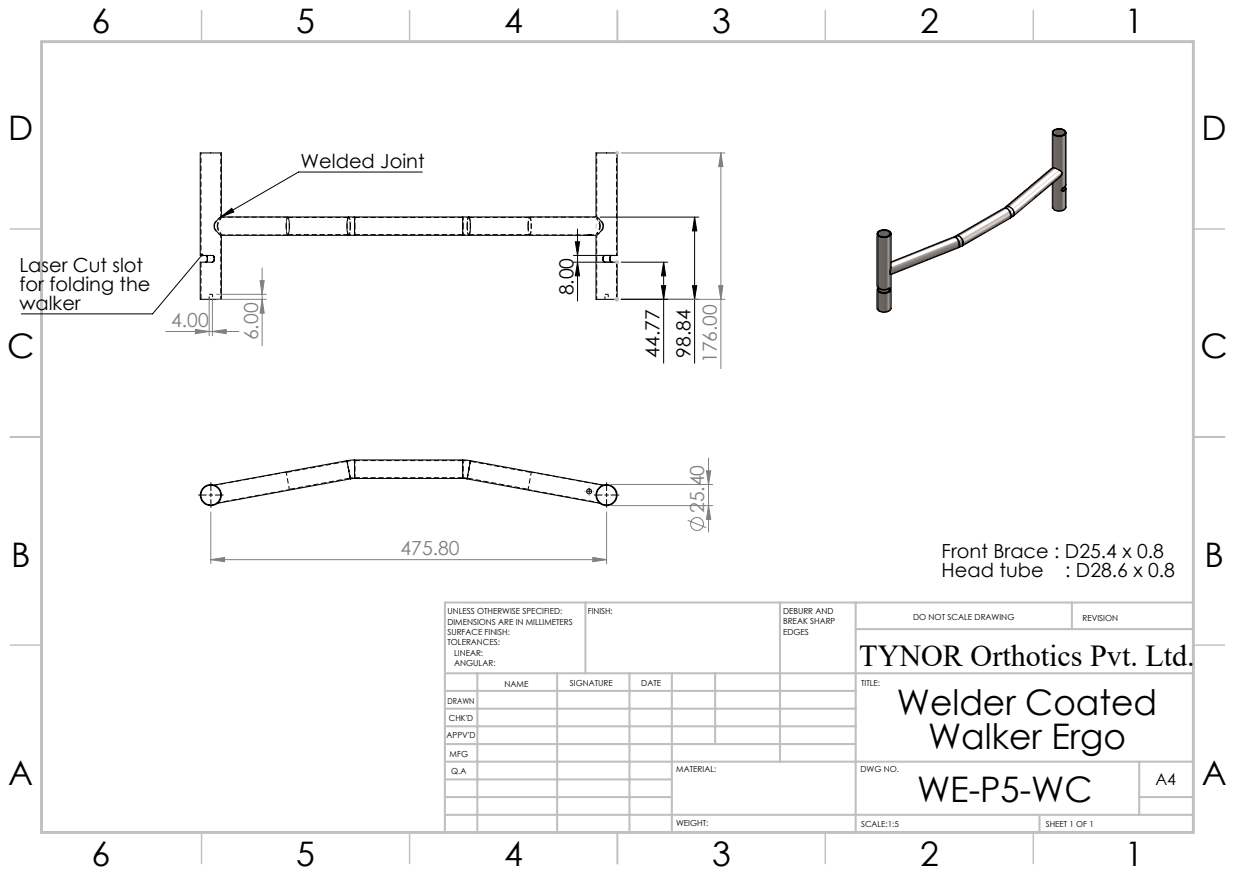
[picture p128: page 1]
Welded Joint; FINISH:; DEBURR AND; BREAK SHARP; DO NOT SCALE DRAWING; REVISION; SCALE:1:5; SHEET 1 OF 1

Laser Cut slot
for folding the
walker

Front Brace : D25.4 x 0.8
Head tube : D28.6 x 0.8
TYNOR Orthotics Pvt. Ltd.

UNLESS OTHERWISE SPECIFIED:
DIMENSIONS ARE IN MILLIMETERS
SURFACE FINISH:
TOLERANCES:
LINEAR:
ANGULAR:

NAME | SIGNATURE | DATE | | | | TITLE: Welder Coated Walker Ergo

DRAWN
CHK'D
APPV'D
MFG
Q.A | | | | MATERIAL: | DWG NO. WE-P5-WC | A4
