princekumar983777/TYNOR/Commode Chair Ergo/Commode Chair Ergo/Back Support Tube Commode Chair Ergo.pdf

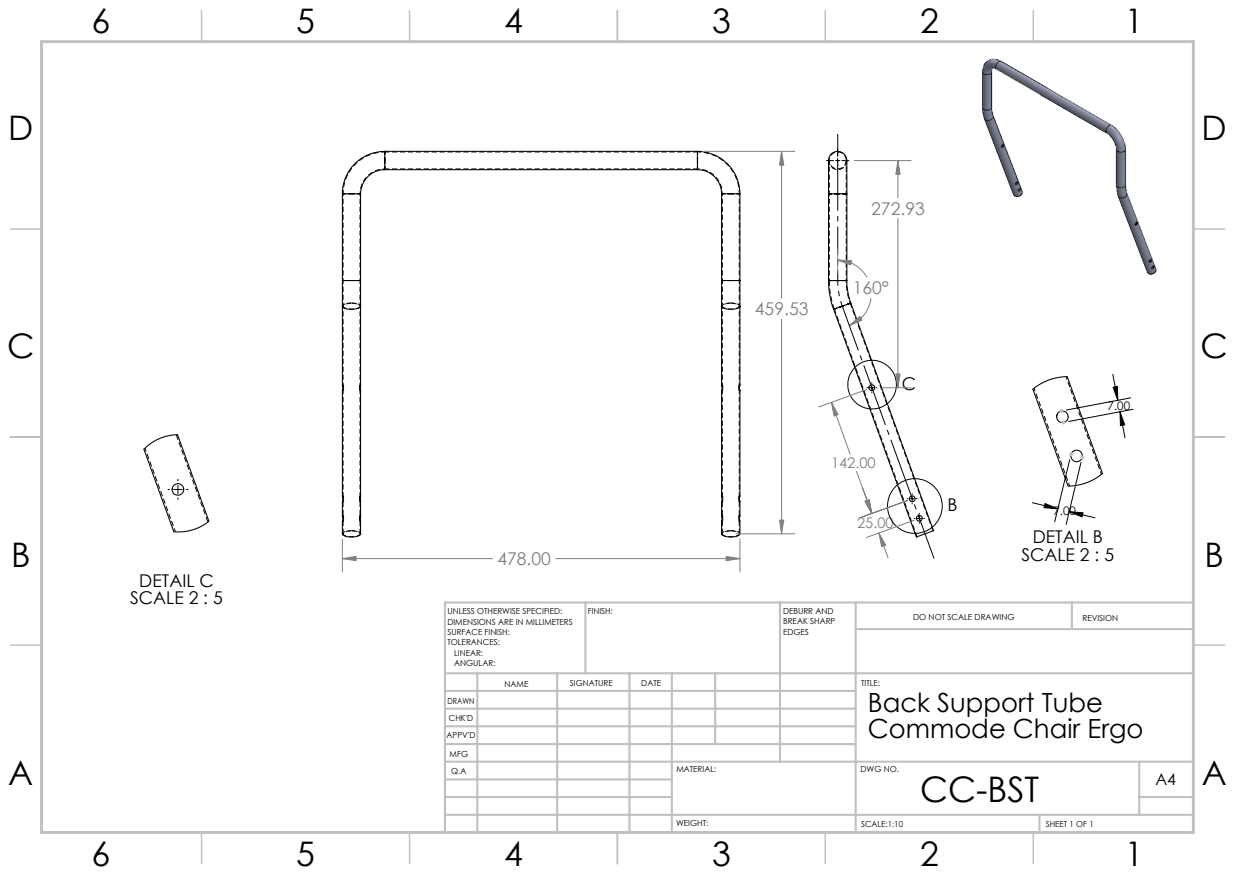
[picture p131: page 1]
DETAIL B SCALE 2 : 5; DETAIL C SCALE 2 : 5; FINISH:; DEBURR AND; BREAK SHARP; DO NOT SCALE DRAWING; REVISION; SCALE:1:10; SHEET 1 OF 1

UNLESS OTHERWISE SPECIFIED:
DIMENSIONS ARE IN MILLIMETERS
SURFACE FINISH:
TOLERANCES:
LINEAR:
ANGULAR:

NAME | SIGNATURE | DATE | | | | TITLE: Back Support Tube Commode Chair Ergo

DRAWN
CHK'D
APPV'D
MFG
Q.A | | | | MATERIAL: | DWG NO. CC-BST | A4
