princekumar983777/TYNOR/Walker Aluminium/Simple Walker/PART_3_1 TLB Tube Inner.pdf

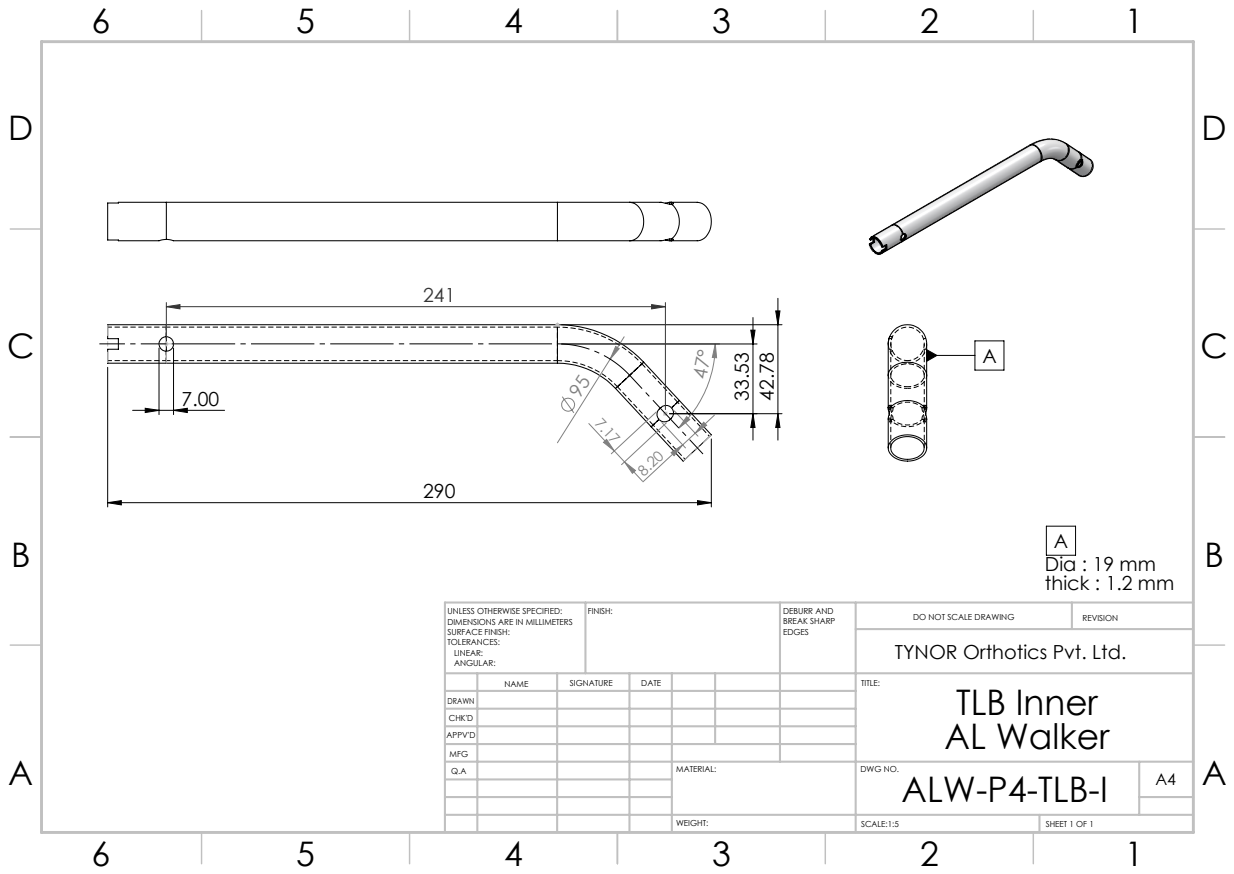
[picture p134: page 1]
Dia : 19 mm thick : 1.2 mm; FINISH:; DEBURR AND; BREAK SHARP; DO NOT SCALE DRAWING; REVISION; SCALE:1:5; SHEET 1 OF 1

UNLESS OTHERWISE SPECIFIED:
DIMENSIONS ARE IN MILLIMETERS
SURFACE FINISH:
TOLERANCES:
LINEAR:
ANGULAR:

TYNOR Orthotics Pvt. Ltd.

NAME | SIGNATURE | DATE | | | | TITLE: TLB Inner AL Walker

DRAWN
CHK'D
APPV'D
MFG
Q.A | | | | MATERIAL: | DWG NO. ALW-P4-TLB-I | A4
