princekumar983777/TYNOR/Walker Aluminium/Simple Walker/PART_4 WELDED Coated ERGO WALKER.pdf

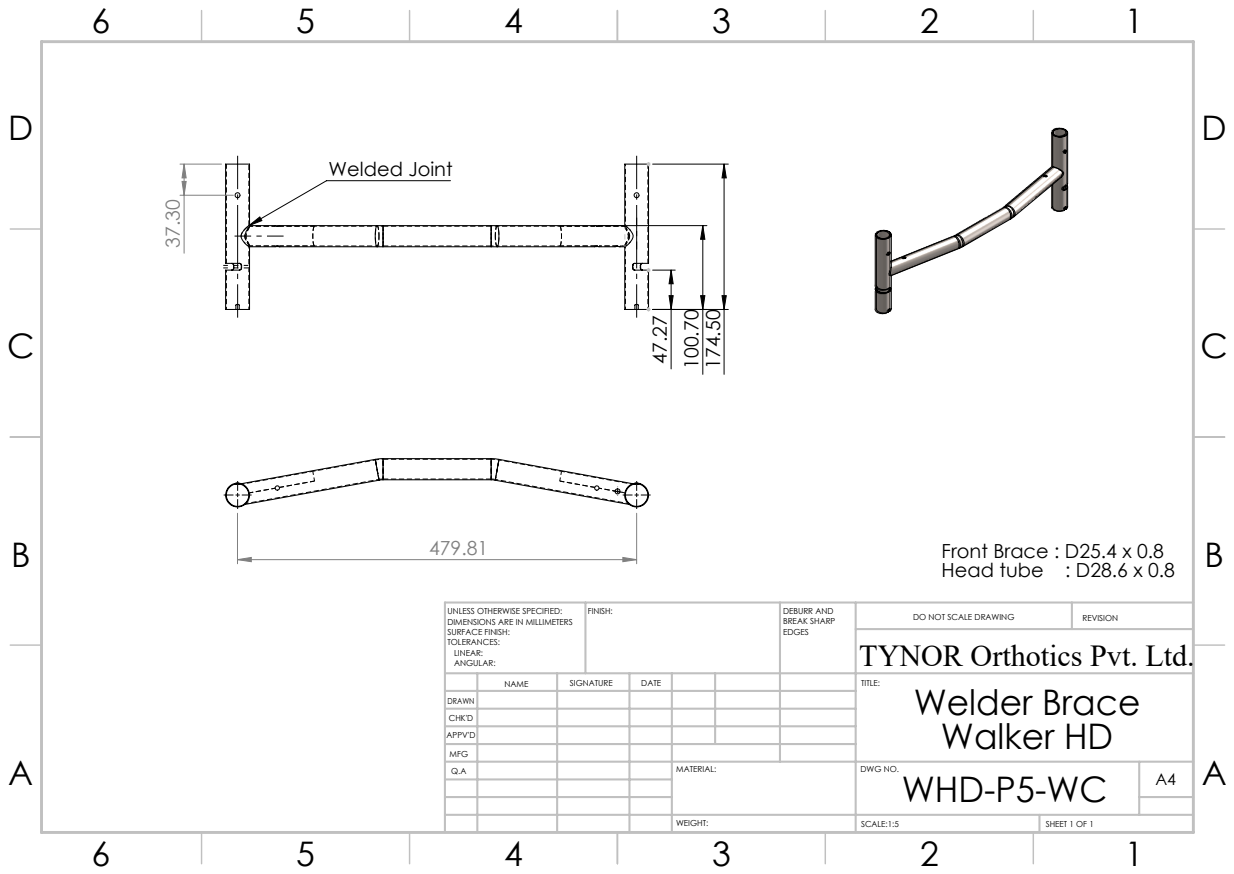
[picture p135: page 1]
Welded Joint; Front Brace : D25.4 x 0.8; FINISH:; DEBURR AND; BREAK SHARP; DO NOT SCALE DRAWING; REVISION; SCALE:1:5; SHEET 1 OF 1

Head tube : D28.6 x 0.8
TYNOR Orthotics Pvt. Ltd.

UNLESS OTHERWISE SPECIFIED:
DIMENSIONS ARE IN MILLIMETERS
SURFACE FINISH:
TOLERANCES:
LINEAR:
ANGULAR:

NAME | SIGNATURE | DATE | | | | TITLE: Welder Brace Walker HD

DRAWN
CHK'D
APPV'D
MFG
Q.A | | | | MATERIAL: | DWG NO. WHD-P5-WC | A4
