princekumar983777/TYNOR/Walker HD/Walker HD/Leg Brace Walker HD.pdf

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

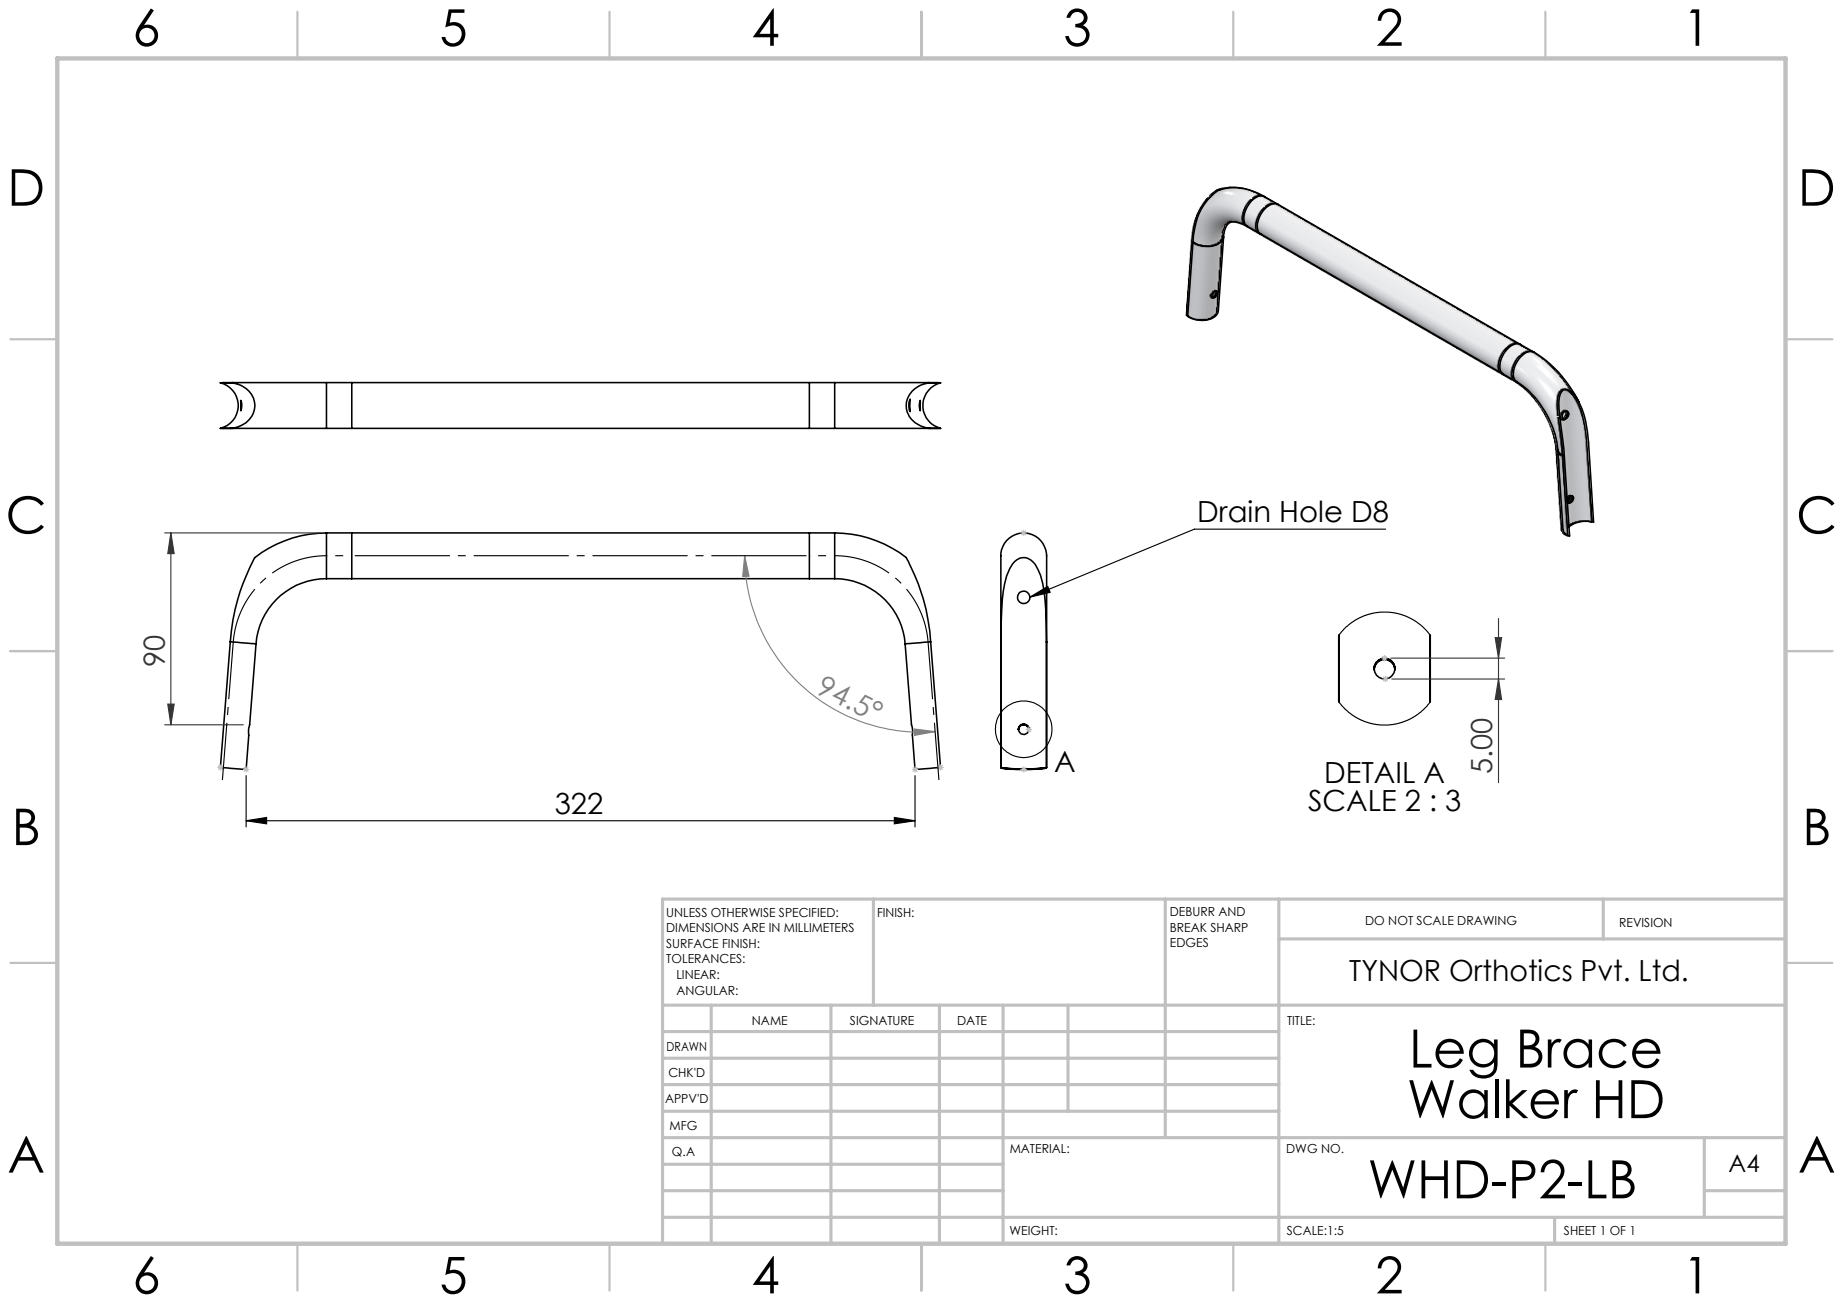
[picture p138: page 1]
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
