princekumar983777/TYNOR/(commit log)

2026-06-10 Add WALKER ERGO and Walker HD files
    [Assem2.SLDASM, Assembly 1.0.SLDASM, Ground Stand.SLDASM, MAIN LINE PART DESIGN.SLDDRW, Main Leg W_HD.SLDPRT, PART_1 MAIN LINE.SLDDRW, PART_1 MAIN LINE.SLDPRT, PART_2 Ergo walker joint Formed.SLDDRW]
2026-06-10 Two Part from Walker HD and Fix the Walker inner and outer part
    [PART_1 MAIN LINE.SLDPRT, PART_3 TLB Tube Inner walker Ergo - Copy.SLDPRT, PART_3 TLB Tube Outer walker Ergo.SLDPRT, PART_5 Perforated Pipe D25.4 ERGO WALKER.SLDPRT]
2026-06-10 Every part fix according to 2024
    [Assem2.SLDASM, Assembly 1.0.SLDASM, Ground Stand.SLDASM, Main Leg W_HD.SLDPRT, PART_1 MAIN LINE.SLDDRW, PART_2 Ergo walker joint Formed.SLDDRW, PART_3 TLB Tube Inner walker Ergo - Copy.SLDPRT, PART_3 TLB Tube Outer walker Ergo.SLDDRW]
2026-06-10 Stop tracking drawings and PDFs in WALKER_ERGO
    [Assembly 1.0.SLDASM, Ground Stand.SLDASM, MAIN LINE PART DESIGN.SLDDRW, PART_1 MAIN LINE.SLDPRT, PART_2 Ergo walker joint Formed.SLDPRT, PART_3 TLB Tube Inner walker Ergo - Copy.SLDPRT, PART_3 TLB Tube Outer walker Ergo.SLDPRT, PART_4 WELDED Coated ERGO WALKER.SLDPRT]
2026-06-17 Completed the Ergo and the HD , left with the AL walker
    [Assembly 1.0.SLDASM, Ground Stand.SLDASM, Ground Stand.SLDDRW, MAIN LINE PART DESIGN.SLDDRW, PART_1 MAIN LINE.SLDDRW, PART_1 MAIN LINE.SLDPRT, PART_2 Ergo walker joint Formed.SLDDRW, PART_2 Ergo walker joint Formed.SLDPRT]
2026-06-25 WE are on AL walker
    [Assembly 1.0 - Copy.SLDASM, Assembly 1.0.SLDASM, Assembly 1.0.SLDDRW, Ground Stand.SLDASM, Ground Stand.SLDDRW, LOCK_PIN.SLDDRW, LOCK_PIN.SLDPRT, Leg Brace for Straight Leg.SLDPRT]
2026-06-26 Developed TLB for inner and outer for the AL Walker with wheel
    [Assembly 1.0.SLDASM, Assembly 1.0.SLDDRW, Assembly 1.0.STEP, Ground Stand.SLDASM, LOCK_PIN.STEP, Leg Brace for Straight Leg.STEP, Maf_of_TLB_inner.SLDDRW, Maf_of_TLb_Outer.SLDDRW]
2026-06-29 Add some extra part
    [Pipe.SLDPRT, Pipe_Holder.SLDDRW, Pipe_Holder.SLDPRT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]
2026-06-29 Just Started Commode ergo
    [Arm rest pipe hinge assembly Commode Chair Ergo.SLDPRT, Assem2.SLDASM, Back Leg Frame Commode Chair Ergo.SLDPRT, Front Leg Frame Commode Chair Ergo.SLDPRT, Front Leg Tube Commode Chair Ergo.SLDPRT, Part6.SLDPRT, Seat Frame Commode Chair Ergo.SLDPRT, Seat Frame Wire Commode Chair Ergo.SLDPRT]
2026-06-30 Commode Chair start wokring
    [Assem2.SLDASM, Back Leg Frame Commode Chair Ergo.SLDPRT, Back Support Tube Commode Chair Ergo.SLDPRT, Front Leg Frame Commode Chair Ergo.SLDPRT, PIP.SLDPRT, Seat Frame Commode Chair Ergo.SLDPRT, Seat Frame Wire Commode Chair Ergo.SLDPRT, Seat frame Assembly.SLDASM]
2026-06-30 added resource for the commode ergo
    [Arm rest pipe hinge assembly Commode Chair Ergo.SLDPRT]
2026-06-30 Fixing parts as the assembly
    [Arm rest pipe hinge assembly Commode Chair Ergo.SLDDRW, Arm rest pipe hinge assembly Commode Chair Ergo.SLDPRT, Assem2.SLDASM, Back Leg Frame Commode Chair Ergo.SLDPRT, Back Support Tube Commode Chair Ergo.SLDDRW, Back Support Tube Commode Chair Ergo.SLDPRT, Front Leg Frame Commode Chair Ergo.SLDPRT, Rivets.SLDPRT]
2026-07-01 Created 4 drawing of Commode Chair
    [Assem2.SLDASM, Back Leg Frame Commode Chair Ergo.SLDDRW, Back Leg Frame Commode Chair Ergo.SLDPRT, Back Support Tube Commode Chair Ergo.SLDPRT, Front Leg Frame Commode Chair Ergo.SLDDRW, Seat Frame Commode Chair Ergo.SLDDRW, Seat frame Assembly.SLDDRW, pla_rivets_2.SLDPRT]
2026-07-01 more drawring from Commode Ergo
    [Front Leg Tube Commode Chair Ergo.SLDDRW, PIP.SLDDRW, Part6.SLDPRT]
2026-07-01 Assembly drawing of Commode Ergo
    [Assem2.SLDASM, Assem2.SLDDRW, Back Support Tube Commode Chair Ergo.SLDPRT]
2026-07-01 just added some rubber stand
    [Arm rest pipe hinge assembly Commode Chair Ergo.SLDDRW, Assem2.SLDASM, Assem2.SLDDRW, Back Leg Frame Commode Chair Ergo.SLDDRW, Back Support Tube Commode Chair Ergo.SLDDRW, Front Leg Frame Commode Chair Ergo.SLDDRW, Front Leg Tube Commode Chair Ergo.SLDDRW, PJug_back.SLDPRT]
